davidpalma666/device.rfidreader-Fork/Hardware/OEPS-2094 HRFIDR - front side 1.jpg

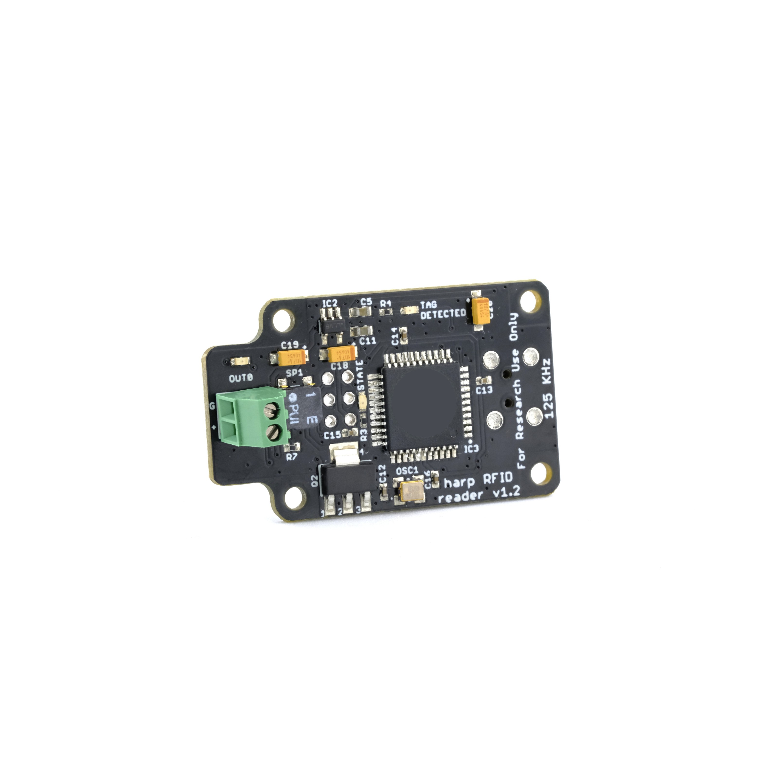
Hardware/OEPS-2094 HRFIDR - front side 1.jpg
