davidpalma666/device.rfidreader-Fork/Hardware/OEPS_BOM_harp_RFID_reader_v1.2.xlsx

Sheet: BOM
 |  |  |  |  |  |  |  |  |  |  |  | Quantity to produce➡️ | 8 | Production➡️ |  | Internal
OEPS PN | Schematic Name⬇️ | Qtty.⬇️ | Description | Type | Manufacturer PN⬇️ | Supplier | Supplier PN | Notes⬇️ | Losses | Needed | To order | Stock RM | Packages | Internal |  | External
 | PCB COMPONENTS
OEPS010011 | C3, C4 | 2 | CAPACITOR: SMD CER 0402 47pF 50V ±5% C0G [04025A470JAT2A] [SMD] | SMD | 04025A470JAT2A | DigiKey | 478-1078-6-ND |  | 0 | 16 | 16 |  |  | 0 | NOK | 0 | NOK
OEPS010017 | C1 | 1 | CAPACITOR: SMD CER 0402 4.7nF 100V ±10% X7R [885012205084] [SMD] | SMD | 885012205084 | DigiKey | 732-12234-6-ND |  | 0 | 8 | 0 | 15 | 6(Tp) 9(Tp) | 15 | OK | 0 | NOK
OEPS010016 | C2, C6, C8, C9, C10, C12, C13, C14, C15, C16, C21 | 11 | CAPACITOR: SMD CER 0402 100nF 50V ±10% X7R [CGA2B3X7R1H104K050BB] [SMD] | SMD | CGA2B3X7R1H104K050BB | DigiKey | 445-6899-6-ND |  | 0 | 88 | 85 | 3 | 3(Tp) | 0 | NOK | 0 | NOK
OEPS010015 | C5, C7, C11, C17 | 4 | CAPACITOR: SMD CER 0603 10uF 16V ±20% X5R [EMK107BBJ106MA-T] [SMD] | SMD | EMK107BBJ106MA-T | DigiKey | 587-3238-6-ND |  | 0 | 32 | 0 | 53 | 4(Tp) 49(Tp) | 13 | OK | 8 | OK
OEPS210002 | C18, C19, C20 | 3 | CAPACITOR POL: SMD TANT A 1206 100uF 10V ±20% 1.4Ohm [TLJA107M010R1400] [SMD] | SMD | TLJA107M010R1400 | DigiKey | 478-5651-6-ND |  | 0 | 24 | 24 |  |  | 0 | NOK | 0 | NOK
OEPS020034 | R7 | 1 | RESISTOR: SMD 0402 39Ω ±1% 0.250W [RCS040239R0FKED] [SMD] | SMD | RCS040239R0FKED | DigiKey | 541-10407-6-ND |  | 0 | 8 | 0 | 13 | 10(Tp) 3(Tp) | 13 | OK | 0 | NOK
OEPS020027 | R2, R3, R4, R6, R8 | 5 | RESISTOR: SMD 0402 1kΩ ±1% 0.063W [CRCW04021K00FKED] [SMD] | SMD | CRCW04021K00FKED | DigiKey | 541-1.00KLDKR-ND |  | 0 | 40 | 40 |  |  | 0 | NOK | 0 | NOK
OEPS020030 | R5 | 1 | RESISTOR: SMD 0402 10kΩ ±1% 0.063W [CRCW040210K0FKED] [SMD] | SMD | CRCW040210K0FKED | DigiKey | 541-10.0KLDKR-ND |  | 0 | 8 | 7 | 1 | 1(Tp) | 1 | NOK | 0 | NOK
OEPS020026 | R1 | 1 | RESISTOR: SMD 0402 1MΩ ±1% 0.063W [CRCW04021M00FKED] [SMD] | SMD | CRCW04021M00FKED | DigiKey | 541-1.00MLDKR-ND |  | 0 | 8 | 8 |  |  | 0 | NOK | 0 | NOK
OEPS040003 | L1 | 1 | INDUCTOR: FERRITE BEAD SMD 40Ω 2A 50mΩ [MI0805K400R-10] [0805] | SMD | MI0805K400R-10 | DigiKey | 240-2389-6-ND |  | 0 | 8 | 6 | 2 | 2(Tp) | 2 | NOK | 0 | NOK
OEPS060005 | Q1 | 1 | TRANSISTOR: BJT NPN 45V 0.5A [BC817-40W-7] [SOT-323] | SMD | BC817-40W-7 | DigiKey | BC817-40WDIDKR-ND |  | 0 | 8 | 5 | 3 | 3(Tp) | 3 | NOK | 0 | NOK
OEPS060004 | Q2 | 1 | TRANSISTOR: MOSFET P-CH 60V 1.7A [NTF2955T1G] [SOT-223] | SMD | NTF2955T1G | DigiKey | NTF2955T1GOSDKR-ND |  | 0 | 8 | 0 | 10 | 10 | 10 | OK | 7 | NOK
OEPS030006 | TAG_B, TAG_T, STATE, OUT0 | 4 | DIODE: LED 0603 Red 635nm 20mA [5975004407F] [0603] | SMD | 5975004407F | DigiKey | 350-2950-6-ND |  | 0 | 32 | 32 |  |  | 0 | NOK | 0 | NOK
OEPS100012 | SP1 | 1 | OTHER: BUZZER MAGNETIC 3V 5X5MM SMD [SMT-0540-S-R] [SMD] | SMD | SMT-0540-S-R | DigiKey | 668-1060-6-ND |  | 0 | 8 | 8 |  |  | 0 | NOK | 0 | NOK
OEPS080013 | IC1 | 1 | IC: USB Interface IC USB to Serial UART (OEPS NP1 073) [FT232RL-REEL] [SSOP-28] | SMD | FT232RL-REEL | DigiKey | 768-1007-6-ND |  | 0 | 8 | 0 | 64 | 48(Tp) 16 | 64 | OK | 63 | OK
OEPS080016 | IC2 | 1 | IC: LDO 3.3V 250mA [LP5907MFX-3.3/NOPB] [SOT-23-5] | SMD | LP5907MFX-3.3/NOPB | DigiKey | 296-38557-6-ND |  | 0 | 8 | 0 | 47 | 47(Tp) | 47 | OK | 42 | OK
OEPS080012 | IC3 | 1 | IC: MCU ATXMEGA A4U 8bits 32KB [ATXMEGA32A4U-A] [ TQFP-44] | SMD | ATXMEGA32A4U-A | DigiKey | ATXMEGA32A4U-AURDKR-ND |  | 0 | 8 | 0 | 13 | 3 10 | 13 | OK | 12 | OK
OEPS080017 | IC4 | 1 | IC: BUFFER NON-INVERT 1CH 3-STATE [M74VHC1GT126DT1G] [TSOP-5] | SMD | M74VHC1GT126DT1G | DigiKey | M74VHC1GT126DT1GOSDKR-ND |  | 0 | 8 | 0 | 29 | 29(Tp) | 29 | OK | 24 | OK
OEPS080014 | OSC1 | 1 | IC: XTAL OSC TCXO 32MHz HCMOS 2.5ppm [O 32,0-JT32C-A-K-3,3-LF] [4-SMD] | SMD | O 32,0-JT32C-A-K-3,3-LF | DigiKey | 1908-1044-6-ND |  | 0 | 8 | 5 | 3 | 1(Tp) 2 | 3 | NOK | 0 | NOK
OEPS070021 | USB | 1 | CONNECTOR: USB 2.0 MINI R/A [UX60-MB-5S8] [SMD] | SMD | UX60-MB-5S8 | DigiKey | H2960DKR-ND |  | 0 | 8 | 0 | 10 | 10(Tp) | 10 | OK | 9 | OK
OEPS070018 | U1 5POS | 1 | CONNECTOR: HEADER 2.00MM straight 1x5POS GOLD [NPPN051BFLD-RC] [SMD] | SMD | NPPN051BFLD-RC‎ | DigiKey | S5902-05-ND |  | 0 | 8 | 8 |  |  | 0 | NOK | 0 | NOK
OEPS070019 | U1 7POS | 1 | CONNECTOR: HEADER 2.00MM straight 1x7POS GOLD [NPPN071BFLC-RC] [SMD] | SMD | ‎NPPN071BFLC-RC‎ | DigiKey | S5901-07-ND |  | 0 | 8 | 0 | 10 | 8(Tb) 2(Tb) | 10 | OK | 9 | OK
OEPS070020 | OUT | 1 | CONNECTOR: TERMINAL BLOCK 2.54MM 2POS side entry [282834-2] [TH] | TH | 282834-2 | DigiKey | A98333-ND |  | 0 | 8 | 0 | 15 | 10 5 | 15 | OK | 14 | OK
 |  |  |  |  |  |  |  |  |  |  |  |  |  |  | OK |  | OK
#N/A |  | 1 | #N/A | #N/A | E1418287 | #N/A | #N/A |  | #N/A |  | #N/A |  |  |  | OK |  | OK
 |  |  |  |  |  |  |  |  |  |  |  |  |  |  | OK |  | OK
OEPS100013 |  | 1 | OTHER: RFID Reader ID-12LA (125 kHz) [ID-12LA] [TH] | TH | ID-12LA | Sparkfun | SEN-11827 |  | 0 | 8 | 8 |  |  | 0 | NOK | 0 | NOK
 |  |  |  |  |  |  |  |  |  |  |  |  |  |  | OK |  | OK
 |  |  |  |  |  |  |  |  |  |  |  |  |  |  | OK |  | OK
 |  |  |  |  |  |  |  |  |  |  |  |  |  |  | OK |  | OK
 |  |  |  |  |  |  |  |  |  |  |  |  |  |  | OK |  | OK
 |  |  |  |  |  |  |  |  |  |  |  |  |  |  | OK |  | OK
 |  |  |  |  |  |  |  |  |  |  |  |  |  |  | OK |  | OK
 |  |  |  |  |  |  |  |  |  |  |  |  |  |  | OK |  | OK
 |  |  |  |  |  |  |  |  |  |  |  |  |  |  | OK |  | OK
 |  |  |  |  |  |  |  |  |  |  |  |  |  |  | OK |  | OK
 |  |  |  |  |  |  |  |  |  |  |  |  |  |  | OK |  | OK
 |  |  |  |  |  |  |  |  |  |  |  |  |  |  | OK |  | OK
 |  |  |  |  |  |  |  |  |  |  |  |  |  |  | OK |  | OK
 |  |  |  |  |  |  |  |  |  |  |  |  |  |  | OK |  | OK
 |  |  |  |  |  |  |  |  |  |  |  |  |  |  | OK |  | OK
 |  |  |  |  |  |  |  |  |  |  |  |  |  |  | OK |  | OK
 |  |  |  |  |  |  |  |  |  |  |  |  |  |  | OK |  | OK
 |  |  |  |  |  |  |  |  |  |  |  |  |  |  | OK |  | OK
 |  |  |  |  |  |  |  |  |  |  |  |  |  |  | OK |  | OK
 |  |  |  |  |  |  |  |  |  |  |  |  |  |  | OK |  | OK
 |  |  |  |  |  |  |  |  |  |  |  |  |  |  | OK |  | OK
 |  |  |  |  |  |  |  |  |  |  |  |  |  |  | OK |  | OK
 |  |  |  |  |  |  |  |  |  |  |  |  |  |  | OK |  | OK
 |  |  |  |  |  |  |  |  |  |  |  |  |  |  | OK |  | OK
 |  |  |  |  |  |  |  |  |  |  |  |  |  |  | OK |  | OK

Sheet: components list
CABLE: FFC / FPC 26WAY 0.5MM 152MM [MP-FFCA05261522A] | OEPS090005 | Cable | MP-FFCA05261522A | 0 | Farnell | 3385235 | OEPS OEPS A35 001 OEPS A35 002 OEPS A35 003 | PDB-C156 TMK105B7104KVHF CL05B103KA5NNNC EMK212ABJ106MG-T
CABLE: FPC 0.30MM 17WAYS 2INCH [0150150217] | OEPS090009 | Cable | 0150150217 | 0 | DigiKey | 900-0150150217-ND | OEPS A35 004 | C3225X7R1C226K250AC | 650(R) 378(R) | 1028 | 650 | Reel | 0622 | 378 | Reel | XXXX
CABLE: FPC 0.30MM 17WAYS 6INCH [0150150617] | OEPS090008 | Cable | 0150150617 | 0 | DigiKey | 900-0150150617-ND | OEPS A35 005 | UMK107BJ105KA-T
CABLE: FPC 0.30MM 27WAYS 2INCH [0150150227] | OEPS090012 | Cable | 0150150227 | 0 | DigiKey | WM9645-ND | OEPS A35 006 | C1005X5R1E474K050BE
CABLE: FPC 0.30MM 27WAYS 4INCH [0150150427] | OEPS090013 | Cable | 0150150427 | 0 | DigiKey | WM6669-ND | OEPS A35 008 | GRM1555C1H220FA01D
CABLE: FPC 0.30MM 45WAYS 2INCH [0150150245] | OEPS090010 | Cable | 0150150245 | 0 | DigiKey | WM9648-ND | OEPS A35 009 | GRM155R71H682JA88D
CABLE: FPC 0.30MM 45WAYS 4INCH [0150150445] | OEPS090011 | Cable | 0150150445 | 0 | DigiKey | WM13117-ND | OEPS A35 010 | CL21A475KAQNNNE
CABLE: MMCX-to-MMCX 2.13meter [523-265101-08-84.00] | OEPS090002 | Cable | 523-265101-08-84.00 | 1 | DigiKey | 265101-08-84.00 | OEPS A35 011 | GRM1555C1H180FA01D
CABLE: RIBON 10COND 28AWG GRAY 100FT 30.48meter [3365/10 100] | OEPS090003 | Cable | 3365/10 100 | 0 | DigiKey | 3M157849-100-ND | OEPS A35 012 | T495C107K016ATE200
CABLE: RIBON 14COND 28AWG GRAY 100FT 30.48meter [3365/14 100] | OEPS090007 | Cable | 3365/14 100 | 0 | DigiKey | 3M157859-100-ND | OEPS A35 013 | GRM1555C1H100FA01D
CABLE: RIBON 8COND WHITE 4INCH 0.1016meter [A08SUR08SUR32W102A] | OEPS090004 | Cable | A08SUR08SUR32W102A | 0 | DigiKey | 455-4058-ND | OEPS A35 014 | RC0402FR-1310KL
CABLE: SDR 2meter 26POS [1SD26-3120-00C-200] | OEPS090001 | Cable | 1SD26-3120-00C-200 | 1 | DigiKey | 3M155828-ND | OEPS A35 015 | RC0402FR-071KL
CABLE: Stereo Jack Plug to Plug 3,5 MM 3.3ft (1.0m) [PSG03744] | OEPS090006 | Cable | PSG03744 | 0 | Farnell | 3498200 | OEPS A35 016 | RC0402FR-074K7L
CAPACITOR POL: SMD ALUM 1000uF 6.3V ±20% X7R [MCVVT6R3M102FB3L] [SMD] | OEPS210009 | SMD | MCVVT6R3M102FB3L | 5 | Farnell | 2611416 | OEPS A35 017 | RC0402FR-070RL | 91(R) | 91 | 91 | Reel | 0622
CAPACITOR POL: SMD ALUM 100uF 25V ±20% X7R [UCD1E101MCL6GS] [SMD] | OEPS210012 | SMD | UCD1E101MCL6GS | 2 | DigiKey | 493-6198-6-ND | OEPS A35 019 | RN731ETTP50R0F50 | 58(R) | 58 | 58 | Reel | 0622
CAPACITOR POL: SMD TANT A 1206 100uF 10V ±20% 1.4Ohm [TLJA107M010R1400] [SMD] | OEPS210002 | SMD | TLJA107M010R1400 | 5 | DigiKey | 478-5651-6-ND | OEPS A35 020 | RC0402FR-07240RL | 506(R) | 506 | 506 | Reel | 0622
CAPACITOR POL: SMD TANT A 1206 4.7uF 16V ±10% [TAJA475K016UNJ] [SMD] | OEPS210003 | SMD | TAJA475K016UNJ | 5 | DigiKey | 478-11461-6-ND | OEPS A35 021 | RC0402FR-071K6L | 503(R) | 503 | 503 | Reel | 0622
CAPACITOR POL: SMD TANT B0 1411 33uF 20V ±20% 50Ohm [TL8B0336M020C] [SMD] | OEPS210010 | SMD | TL8B0336M020C | 5 | Digikey | 718-1918-6-ND | OEPS A35 022 | RC0402FR-0740K2L
CAPACITOR POL: SMD TANT D 2917 100uF 16V ±10% 700mOhm [T491D107K016AT7280] [SMD] | OEPS210004 | SMD | T491D107K016AT7280 | 3 | DigiKey | 399-18066-6-ND | OEPS A35 023 | RC0402FR-07665KL
CAPACITOR POL: SMD TANT D 2917 330uF 10V ±10% 65mOhm (OEPS J30 011A) [TPSD337K010R0065] [SMD] | OEPS210008 | SMD | TPSD337K010R0065 | 5 | Digikey | 478-9190-6-ND | OEPS A35 024 | RC0402FR-07357KL
CAPACITOR POL: SMD TANT X 100uF 16V ±10% 75mOhm [T498X107K016ATE075] [SMD] | OEPS210001 | SMD | T498X107K016ATE075 | 3 | DigiKey | 399-5207-6-ND | OEPS A35 025 | RC0402FR-0724K9L
CAPACITOR POL: TH ALUM 100uF 25V ±20% 130mOhm [EEU-FM1E101B] [TH] | OEPS210005 | TH | EEU-FM1E101B | 1 | DigiKey | P19702CT-ND | OEPS A35 026 | RC0402FR-0778K7L | 512(R) | 512 | 512 | Reel | 0622
CAPACITOR POL: TH ALUM 330uF 16V ±20% 115,5mOhm [MCGPR16V337M8X11] [TH] | OEPS210006 | TH | MCGPR16V337M8X11 | 1 | Farnell | 9451102 | OEPS A35 027 | RC0402FR-07118KL | 543(R) | 543 | 543 | Reel | 0622
CAPACITOR POL: TH SUPERCAPACITOR 3F 2.7V ±10% RADIAL [HV0820-2R7305-R] [TH] | OEPS210011 | TH | HV0820-2R7305-R | 1 | DigiKey | 283-HV0820-2R7305-R-ND | OEPS A35 028 | BLM15AG601SN1D
CAPACITOR POL: USE OEPS210006 INSTEAD [MCGPR16V337M8X11] [TH] | OEPS210007 | TH | MCGPR16V337M8X11 | 1 | Farnell | 9451102 | OEPS A35 029 | MH2029-221Y
CAPACITOR: SMD CER 01005 10nF 16V ±10% X5R [GRM022R61C103KE01L] [SMD] | OEPS010101 | SMD | GRM022R61C103KE01L | 30 | Digikey | 490-GRM022R61C103KE01LCT-ND | OEPS A35 030 | LTST-C191KGKT | 59(R) | 59 | 59 | Reel | 0923
CAPACITOR: SMD CER 0201 100nF 10V ±20% X5R (OEPS J05 002) [GRM033R61A104ME15D] [SMD] | OEPS010040 | SMD | GRM033R61A104ME15D | 30 | DigiKey | 490-5405-6-ND | OEPS A35 031 | LTST-C191KRKT | 71(R) | 71 | 71 | Reel | 0523
CAPACITOR: SMD CER 0201 100nF 25V ±10% X5R (OEPS M01 007) [GRM033R61E104KE14J] [SMD] | OEPS010035 | SMD | GRM033R61E104KE14J | 30 | DigiKey | 490-14571-6-ND | OEPS A35 032 | PMEG3030EP,115 | 53(R) | 53 | 53 | Reel | 0622
CAPACITOR: SMD CER 0201 10nF 10V ±10% X7R (OEPS J05 006) [GRM033R71A103KA01D] [SMD] | OEPS010044 | SMD | GRM033R71A103KA01D | 30 | DigiKey | 490-3194-6-ND | OEPS A35 034 | CUZ6V8,H3F
CAPACITOR: SMD CER 0201 10nF 25V ±10% X7R (OEPS M01 004) [GRM033R71E103KE14D] [SMD] | OEPS010037 | SMD | GRM033R71E103KE14D | 30 | DigiKey | 490-14454-6-ND | OEPS A35 035 | LFE5U-85F-6BG381C
CAPACITOR: SMD CER 0201 10pF 50V ±5% C0G [GRM0335C1H100JA01J] [SMD] | OEPS010060 | SMD | GRM0335C1H100JA01J | 30 | DigiKey | 490-17811-6-ND | OEPS A35 035A | LFE5U-85F-6BG381I
CAPACITOR: SMD CER 0201 1uF 10V ±20% X5R (OEPS J05 003) [GRM033R61A105ME15D] [SMD] | OEPS010041 | SMD | GRM033R61A105ME15D | 30 | DigiKey | 490-13226-6-ND | OEPS A35 036 | SIT9120AC-2C2-25E100.000000X | 22(R) | 22 | 22 | Reel | XXXX
CAPACITOR: SMD CER 0201 1uF 16V ±20% X5R (OEPS M01 009) [CL03A105MO3NRNH] [SMD] | OEPS010036 | SMD | CL03A105MO3NRNH | 30 | DigiKey | 1276-6798-6-ND | OEPS A35 037 | W25Q128JVPIQ TR
CAPACITOR: SMD CER 0201 2.2uF 10V ±20% X5R (OEPS J05 004A) [CM03X5R225M10AH] [SMD] | OEPS010042 | SMD | CM03X5R225M10AH | 30 | Mouser | 346-CM03X5R225M10AH | OEPS A35 038 | MT41K64M16TW-107:J | 2(Tr) | 2 | 2 | Tray | 0222
CAPACITOR: SMD CER 0201 22nF 25V ±10% X5R [C0603X5R1E223K030BB] [SMD] | OEPS010058 | SMD | C0603X5R1E223K030BB | 30 | DigiKey | 445-13675-6-ND | OEPS A35 041 | FT600-B-T | 1(Tr) | 1 | 1 | Tray | XXXX
CAPACITOR: SMD CER 0201 27nF 16V ±10% X7R (OEPS Z00 003) [GRM033R61C273KE84D] [SMD] | OEPS010069 | SMD | GRM033R61C273KE84D | 30 | DigiKey | 490-10416-6-ND | OEPS A35 042 | LTC4360ISC8-2#TRMPBF
CAPACITOR: SMD CER 0201 27pF 50V ±2% C0G, NP0 [GRM0335C1H270GA01D] [SMD] | OEPS010029 | SMD | GRM0335C1H270GA01D | 30 | DigiKey | 490-11317-6-ND | OEPS A35 043 | LTM8051IY#PBF
CAPACITOR: SMD CER 0201 30pF 50V ±2% C0G (OEPS J05 039) [GRM0335C1H300GA01D] [SMD] | OEPS010049 | SMD | GRM0335C1H300GA01D | 30 | DigiKey | 490-14560-6-ND | OEPS A35 044 | NLSX3018MUTAG | 12 | 12 | 12 | Bag | XXXX
CAPACITOR: SMD CER 0201 4.7UF 6.3V ±20% X5R [GRM035R60J475ME15D] [SMD] | OEPS010065 | SMD | GRM035R60J475ME15D | 30 | DigiKey | 490-13230-6-ND | OEPS A35 045 | ABM8G-30.000MHZ-18-D2Y-T
CAPACITOR: SMD CER 0201 47nF 16V ±10% X5R (OEPS J05 005) [GRM033R61C473KE84D] [SMD] | OEPS010043 | SMD | GRM033R61C473KE84D | 30 | DigiKey | 490-7227-6-ND | OEPS A35 047 | ZXMC3A16DN8TC | 9(Tb) 4(Tb) | 13 | 9 | Tube | XXXX | 4 | Tube | XXXX
CAPACITOR: SMD CER 0201 47nF 25V ±10% X5R [CC0201KRX5R8BB473] [SMD] | OEPS010031 | SMD | CC0201KRX5R8BB473 | 30 | DigiKey | 13-CC0201KRX5R8BB473DKR-ND | OEPS A35 048 | BSE-040-01-L-D-A | 2 4(Tp) | 6 | 2 | Bag | 0522 | 4 | Tape | XXXX
CAPACITOR: SMD CER 0402 1.8nF 50V ±5% X7R [C0402C182J5RACTU] [SMD] | OEPS010090 | SMD | C0402C182J5RACTU | 30 | Digikey | 399-C0402C182J5RACTUDKR-ND | OEPS A35 049 | PH1RB-06-UA
CAPACITOR: SMD CER 0402 100nF 25V ±10% X7R [GRM155R71E104KE14D] [SMD] | OEPS010004 | SMD | GRM155R71E104KE14D | 30 | DigiKey | 490-10698-6-ND | OEPS A35 050 | ZX360D-B-10P(30) | 7 | 7 | 7 | Bag | XXXX
CAPACITOR: SMD CER 0402 100nF 25V ±10% X7R (OEPS H02 001) [C1005X7R1E104K050BB] [SMD] | OEPS010050 | SMD | C1005X7R1E104K050BB | 30 | DigiKey | 445-7348-6-ND | OEPS A35 051 | PJ-102AH | 28 | 28 | 28 | Bag | XXXX
CAPACITOR: SMD CER 0402 100nF 35V ±10% X5R (OEPS H1 001) [C1005X5R1V104K050BB] [SMD] | OEPS010066 | SMD | C1005X5R1V104K050BB | 30 | DigiKey | 445-7384-6-ND | OEPS E02 001 | PPTC141LFBN-RC
CAPACITOR: SMD CER 0402 100nF 50V ±10% X7R [CGA2B3X7R1H104K050BB] [SMD] | OEPS010016 | SMD | CGA2B3X7R1H104K050BB | 30 | DigiKey | 445-6899-6-ND | OEPS E02 002 | PPPC072LFBN-RC | 1 | 1 | 1 | Bag | 0422
CAPACITOR: SMD CER 0402 100pF 50V ±5% C0G [CC0402JRNPO9BN101] [SMD] | OEPS010089 | SMD | CC0402JRNPO9BN101 | 30 | Digikey | 311-1024-6-ND | OEPS E02 003 | PPTC161LFBN-RC | 17 | 17 | 17 | Bag | 0624
CAPACITOR: SMD CER 0402 10nF 25V ±10% X7R [GCM155R71E103KA37D] [SMD] | OEPS010002 | SMD | GCM155R71E103KA37D | 30 | DigiKey | 490-6043-6-ND | OEPS E02 004 | PPTC081LFBN-RC
CAPACITOR: SMD CER 0402 10nF 25V ±10% X7R (OEPS H1 002) [GRM155R71E103KA01D] [SMD] | OEPS010067 | SMD | GRM155R71E103KA01D | 30 | DigiKey | 490-1312-6-ND | OEPS E02 005 | OSTVN04A150
CAPACITOR: SMD CER 0402 10nF 50V ±10% X7R (OEPS H02 003) [GRM155R71H103KA88D] [SMD] | OEPS010051 | SMD | GRM155R71H103KA88D | 30 | DigiKey | 490-4516-6-ND | OEPS E02 006 | PJ-063AH
CAPACITOR: SMD CER 0402 10uF 10V ±20% X5R (OEPS M01 014) [CL05A106MP5NUNC] [SMD] | OEPS010038 | SMD | CL05A106MP5NUNC | 30 | DigiKey | 1276-1450-6-ND | OEPS E02 007 | 06035C103KAT2A | 12(Tp) | 12 | 12 | Tape | 0624
CAPACITOR: SMD CER 0402 10uF 6.3V ±20% X5R (OEPS J05 007A) [CL05A106MQ5NUNC] [SMD] | OEPS010045 | SMD | CL05A106MQ5NUNC | 30 | DigiKey | 1276-1451-6-ND | OEPS E02 008A | 478-10073-1-ND | 45(Tp) | 45 | 45 | Tape | 0624
CAPACITOR: SMD CER 0402 12pF 50V ±5% COG/NP0 [GRM1555C1H120JA01D] [SMD] | OEPS010086 | SMD | GRM1555C1H120JA01D | 30 | Digikey | 490-5924-6-ND | OEPS E02 009 | T491D156K035AT
CAPACITOR: SMD CER 0402 15nF 35V ±10% X7R [CGA2B3X7R1V153K050BB] [SMD] | OEPS010023 | SMD | CGA2B3X7R1V153K050BB | 30 | DigiKey | 445-12254-6-ND | OEPS E02 010 | T491D227M010AT
CAPACITOR: SMD CER 0402 1nF 50V ±5% X7R [C0402C102J5RACTU] [SMD] | OEPS010079 | SMD | C0402C102J5RACTU | 30 | Digikey | 399-C0402C102J5RACTUDKR-ND | OEPS E02 011 | RC0603FR-07470RL | 34(R) | 34 | 34 | Reel | 0422
CAPACITOR: SMD CER 0402 1uF 25V ±10% X5R [C1005X5R1E105K050BC] [SMD] | OEPS010030 | SMD | C1005X5R1E105K050BC | 30 | DigiKey | 445-9066-6-ND | OEPS E02 012 | RC0603FR-074K7L
CAPACITOR: SMD CER 0402 2.2uF 10V ±10% X7R [GRM155Z71A225KE44D] [SMD] | OEPS010055 | SMD | GRM155Z71A225KE44D | 30 | DigiKey | 490-GRM155Z71A225KE44DDKR-ND | OEPS E02 013 | RC0603FR-0710KL
CAPACITOR: SMD CER 0402 2.2uF 25V ±20% X5R [GRM155R61E225ME11D] [SMD] | OEPS010062 | SMD | GRM155R61E225ME11D | 30 | DigiKey | 490-12704-6-ND | OEPS E02 014 | SM-42TX203
CAPACITOR: SMD CER 0402 220nF 50V ±10% X5R [UMK105BJ224KV-F] [SMD] | OEPS010085 | SMD | UMK105BJ224KV-F | 30 | Digikey | 587-3500-6-ND | OEPS E02 015 | DR125-680-R | 2 | 2 | 2 | Bag | 0422
CAPACITOR: SMD CER 0402 22nF 50V ±10% X7R [GRM155R71H223KA12D] [SMD] | OEPS010034 | SMD | GRM155R71H223KA12D | 30 | DigiKey | 490-3884-6-ND | OEPS E02 016 | NRVTS260ESFT1G | 85(R) | 85 | 85 | Reel | XXXX
CAPACITOR: SMD CER 0402 22pF 50V ±5% C0G/NP0 [CL05C220JB51PNC] [SMD] | OEPS010080 | SMD | CL05C220JB51PNC | 30 | Digikey | 1276-6849-6-ND | OEPS E02 017 | IS31FL3193-DLS2-TR
CAPACITOR: SMD CER 0402 22uF 10V ±20% X5R [GMC04X5R226M10NT] [SMD] | OEPS010100 | SMD | GMC04X5R226M10NT | 30 | Digikey | 4713-GMC04X5R226M10NTDKR-ND | OEPS E02 018 | MAX6816EUS+T | 6(Tp) | 6 | 6 | Tape | XXXX
CAPACITOR: SMD CER 0402 27nF 16V ±10% X7R [C0402C273K4RACTU] [SMD] | OEPS010068 | SMD | C0402C273K4RACTU | 30 | DigiKey | 399-C0402C273K4RACTUDKR-ND | OEPS E02 019 | MIC4680-5.0YM-TR
CAPACITOR: SMD CER 0402 330nF 10V ±10% X5R [GRM155R61A334KE15D] [SMD] | OEPS010021 | SMD | GRM155R61A334KE15D | 30 | DigiKey | 490-3263-6-ND | OEPS E02 020 | COM-15141
CAPACITOR: SMD CER 0402 330pF 50V ±5% C0G [C0402C331J5GAC7867] [SMD] | OEPS010020 | SMD | C0402C331J5GAC7867 | 30 | DigiKey | 399-C0402C331J5GAC7867DKR-ND | OEPS E02 022 | PPTC041LFBN-RC | 92 | 92 | 92 | Bag | 0422
CAPACITOR: SMD CER 0402 4.7nF 100V ±10% X7R [885012205084] [SMD] | OEPS010017 | SMD | 885012205084 | 30 | DigiKey | 732-12234-6-ND | OEPS E02 023 | SAM12225-ND | 12 | 12 | 12 | Bag | 0421
CAPACITOR: SMD CER 0402 4.7nF 25V ±10% X7R [CC0402KRX7R8BB472] [SMD] | OEPS010001 | SMD | CC0402KRX7R8BB472 | 30 | DigiKey | 311-1039-6-ND | OEPS E02 025 | COM-10597 | 15 | 15 | 15 | Bag | 1224
CAPACITOR: SMD CER 0402 4.7uF 10V ±20% X5R (OEPS H02 004) [GRM155R61A475MEAAD] [SMD] | OEPS010052 | SMD | GRM155R61A475MEAAD | 30 | DigiKey | 490-14306-6-ND | OEPS E02 026 | TMCSILENTSTEPSTICK
CAPACITOR: SMD CER 0402 4.7uF 16V ±20% X5R [KGM05CR51C475MH] [SMD] | OEPS010097 | SMD | KGM05CR51C475MH | 30 | Digikey | 478-KGM05CR51C475MHDKR-ND | OEPS E02 027 | 61300811121 | 20 40 20 | 80 | 20 | Bag | 0624 | 40 | Bag | 0320 | 20 | Bag | 1224
CAPACITOR: SMD CER 0402 4.7uF 25V ±20% X5S [GRM155C61E475ME15J] [SMD] | OEPS010061 | SMD | GRM155C61E475ME15J | 30 | DigiKey | 490-GRM155C61E475ME15JDKR-ND | OEPS E02 029 | 61001421121
CAPACITOR: SMD CER 0402 4.7uF 6.3V ±20% X5R (OEPS J05 008) [GRM155R60J475ME47D] [SMD] | OEPS010046 | SMD | GRM155R60J475ME47D | 30 | DigiKey | 490-5915-6-ND | OEPS E02 029A | 95278-101A14LF | 6(Tp) | 6 | 6 | Tape | 0624
CAPACITOR: SMD CER 0402 470nF 35V ±10% X5R [C1005X5R1V474K050BE] [SMD] | OEPS010059 | SMD | C1005X5R1V474K050BE | 30 | DigiKey | 445-175220-6-ND | OEPS E02 030 | 61301411121
CAPACITOR: SMD CER 0402 470pF 100V ±5% C0G [C1005C0G2A471J050BA] [SMD] | OEPS010053 | SMD | C1005C0G2A471J050BA | 30 | DigiKey | 445-15206-6-ND | OEPS E02 031 | LCD-00709 | 9 | 9 | 9 | Bag | 0724
CAPACITOR: SMD CER 0402 470pF 50V ±5% C0G [C0402C471J5GAC7867] [SMD] | OEPS010033 | SMD | C0402C471J5GAC7867 | 30 | DigiKey | 399-C0402C471J5GAC7867DKR-ND | OEPS E02 032 | 61301611121
CAPACITOR: SMD CER 0402 47nF 25V ±10% X7R [GRM155R71E473KA88D] [SMD] | OEPS010003 | SMD | GRM155R71E473KA88D | 30 | DigiKey | 490-3254-6-ND | OEPS E02 037 | 3.06PRST30TC1D
CAPACITOR: SMD CER 0402 47nF 50V ±10% X7R [GRM155R71H473KE14D] [SMD] | OEPS010063 | SMD | GRM155R71H473KE14D | 30 | DigiKey | 490-10702-6-ND | OEPS F01 001 | JS102011SAQN | 2(Tp) | 2 | 2 | Tape | N/A
CAPACITOR: SMD CER 0402 47pF 50V ±5% C0G [04025A470JAT2A] [SMD] | OEPS010011 | SMD | 04025A470JAT2A | 30 | DigiKey | 478-1078-6-ND | OEPS F01 002 | CGA4J3X7R1E105K | 38(R) | 38 | 38 | Reel | 0421
CAPACITOR: SMD CER 0603 100nF 100V ±10% X7R [CL10B104KC8NNNC] [SMD] | OEPS010095 | SMD | CL10B104KC8NNNC | 20 | DigiKey | 1276-6807-6-ND | OEPS F01 015 | UCD1E101MCL6GS | 3 | 3 | 3 | Bag | N/A
CAPACITOR: SMD CER 0603 100nF 100V ±10% X7R [GRM188R72A104KA35D] [SMD] | OEPS010009 | SMD | GRM188R72A104KA35D | 20 | DigiKey | 490-3285-6-ND | OEPS F01 017 | SZMM3Z5V1ST1G | 13(R) | 13 | 13 | Reel | 0421
CAPACITOR: SMD CER 0603 100nF 100V ±10% X7R (OEPS J05 001) [GRJ188R72A104KE11D] [SMD] | OEPS010039 | SMD | GRJ188R72A104KE11D | 20 | DigiKey | 490-10901-6-ND | OEPS F01 019 | MBR0520LT1G | 122(R) | 122 | 122 | Reel | 0617
CAPACITOR: SMD CER 0603 100pF 50V ±5% C0G [CC0603JRNPO9BN101] [SMD] | OEPS010078 | SMD | CC0603JRNPO9BN101 | 30 | Digikey | 311-1069-6-ND | OEPS F01 020 | SBH11-PBPC-D05-RA-BK | 1 | 1 | 1 | Bag | 0421
CAPACITOR: SMD CER 0603 10nF 50V ±10% X7R [C1608X7R1H103K080AA] [SMD] | OEPS010074 | SMD | C1608X7R1H103K080AA | 30 | Digikey | 445-1311-6-ND | OEPS F01 023 | 569-0112-200F | 1 | 1 | 1 | Bag | 0421
CAPACITOR: SMD CER 0603 10pF 50V ±5% C0G [C0603C100J5GACTU] [SMD] | OEPS010096 | SMD | C0603C100J5GACTU | 20 | DigiKey | 399-C0603C100J5GACTUDKR-ND | OEPS F01 028 | 164-6218 | 1 | 1 | 1 | Bag | XX21
CAPACITOR: SMD CER 0603 10uF 16V ±20% X5R [EMK107BBJ106MA-T] [SMD] | OEPS010015 | SMD | EMK107BBJ106MA-T | 20 | DigiKey | 587-3238-6-ND | OEPS F01 029 | 571-0500 | 1 | 1 | 1 | Bag | XX21
CAPACITOR: SMD CER 0603 10uF 35V ±20% X5R [GRM188R6YA106MA73J] [SMD] | OEPS010093 | SMD | GRM188R6YA106MA73J | 20 | Digikey | 490-GRM188R6YA106MA73JDKR-ND | OEPS F01 030 | 569-0111-100F | 1 | 1 | 1 | Bag | XX21
CAPACITOR: SMD CER 0603 15nF 50V ±10% X7R [C0603C153K5RACTU] [SMD] | OEPS010084 | SMD | C0603C153K5RACTU | 30 | Digikey | 399-C0603C153K5RACTUDKR-ND | OEPS F01 031 | PJ-063AH | 1 | 1 | 1 | Bag | 0421
CAPACITOR: SMD CER 0603 15pF 50V ±5% C0G [C1608C0G1H150J080AA] [SMD] | OEPS010072 | SMD | C1608C0G1H150J080AA | 30 | Digikey | 445-1271-6-ND | OEPS F01 034 | IRF510STRRPBF | 14(R) 5 | 19 | 14 | Reel | 0421 | 5 | Bag | N/A
CAPACITOR: SMD CER 0603 180nF 50V ±10% X8R [GCG188R91H184KA01D] [SMD] | OEPS010019 | SMD | GCG188R91H184KA01D | 20 | DigiKey | 490-GCG188R91H184KA01DDKR-ND | OEPS F01 050 | CSR0603FKR500 | 80(R) | 80 | 80 | Reel | 0421
CAPACITOR: SMD CER 0603 18pF 50V ±5% C0G [C0603C180J5GAC7867] [SMD] | OEPS010064 | SMD | C0603C180J5GAC7867 | 30 | DigiKey | 399-C0603C180J5GAC7867DKR-ND | OEPS F01 062 | CFPA-1FB4-A2T | 1 | 1 | 1 | Bag | N/A
CAPACITOR: SMD CER 0603 1nF 100V ±10% X7R [C1608X7R2A102K080AA] [SMD] | OEPS010073 | SMD | C1608X7R2A102K080AA | 30 | Digikey | 445-1298-6-ND | OEPS F01 063 | 731000105 | 1 | 1 | 1 | Bag | XX21
CAPACITOR: SMD CER 0603 1uF 25V ±10% X5R [CL10A105KA8NNNC] [SMD] | OEPS010022 | SMD | CL10A105KA8NNNC | 20 | DigiKey | 1276-1102-6-ND | OEPS F01 067 | ADG1201BRJZ-R2
CAPACITOR: SMD CER 0603 1uF 50V ±10% X7R [06035C105KAT2A] [SMD] | OEPS010054 | SMD | 06035C105KAT2A | 20 | DigiKey | 478-10073-6-ND | OEPS F01 070 | LT1764AEQ#TRPBF | 1 | 1 | 1 | Bag | N/A
CAPACITOR: SMD CER 0603 2.2uF 25V ±10% X5R (OEPS J30 006) [GRM188R61E225KA12D] [SMD] | OEPS010075 | SMD | GRM188R61E225KA12D | 30 | Digikey | 490-10731-6-ND | OEPS F01 071 | BD00FC0WEFJ-E2 | 16(R) | 16 | 16 | Reel | 0421
CAPACITOR: SMD CER 0603 22nF 100V ±10% X7R [C1608X7R2A223K080AA] [SMD] | OEPS010056 | SMD | C1608X7R2A223K080AA | 30 | DigiKey | 445-2275-6-ND | OEPS F01 078 | ADR03BKSZ-REEL7 | 14(R) | 14 | 14 | Reel | 0421
CAPACITOR: SMD CER 0603 22uF 6.3V ±20% X5R (OEPS J30 009) [GRM188R60J226MEA0D] [SMD] | OEPS010076 | SMD | GRM188R60J226MEA0D | 30 | Digikey | 490-7611-6-ND | OEPS F01 079 | AS12CV | 1 | 1 | 1 | Bag | 0421
CAPACITOR: SMD CER 0603 4.7nF 100V ±10% X7R [885012206112] [SMD] | OEPS010014 | SMD | 885012206112 | 20 | DigiKey | 732-12240-6-ND | OEPS F01 080 | 100SP3T2B4M6RE | 1 | 1 | 1 | Bag | 0421
CAPACITOR: SMD CER 0603 4.7uF 16V ±10% X6S [C1608X6S1C475K080AC] [SMD] | OEPS010018 | SMD | C1608X6S1C475K080AC | 20 | DigiKey | 445-9118-6-ND | OEPS F01 082 | SSQ-102-03-G-S | 1 3 | 4 | 1 | Bag | 0421 | 3 | Bag | N/A
CAPACITOR: SMD CER 0603 4.7uF 25V ±10% X5R (OEPS J05 009) [GRM188R61E475KE11D] [SMD] | OEPS010047 | SMD | GRM188R61E475KE11D | 30 | DigiKey | 490-7203-6-ND | OEPS F01 084 | ESR03EZPF4700 | 14(R) | 14 | 14 | Reel | 0421
CAPACITOR: SMD CER 0603 47pF 50V ±5% C0G [06035A470JAT2A] [SMD] | OEPS010012 | SMD | 06035A470JAT2A | 20 | DigiKey | 478-1171-6-ND | OEPS H02 002 | C0402C273K4RACTU
CAPACITOR: SMD CER 0603 75pF 50V C0G [0603N750J500CT] [SMD] | OEPS010070 | SMD | 0603N750J500CT | 30 | Digikey | 1292-1545-6-ND | OEPS H02 005A | RC0603FR-070RL
CAPACITOR: SMD CER 0805 100nF 100V ±10% X7R [C2012X7R2A104K125AA] [SMD] | OEPS010077 | SMD | C2012X7R2A104K125AA | 20 | Digikey | 445-1418-6-ND | OEPS J05 004 | GRM033R61A225ME47D
CAPACITOR: SMD CER 0805 100pF 50V ±5% C0G [CC0805JRNPO9BN101] [SMD] | OEPS010082 | SMD | CC0805JRNPO9BN101 | 30 | Digikey | 311-1111-6-ND | OEPS J05 010A | C2012JB1A476M125AC | 142(R) | 142 | 142 | Reel | 0621
CAPACITOR: SMD CER 0805 10uF 25V ±10% X5R [GRM21BR61E106KA73L] [SMD] | OEPS010006 | SMD | GRM21BR61E106KA73L | 20 | DigiKey | 490-5523-6-ND | OEPS J05 014 | U.FL-R-SMT-1(10) | 20(Tp) 6 509(R) | 535 | 20 | Tape | XXXX | 6 | Bag | XXXX | 509 | Reel | 0822
CAPACITOR: SMD CER 0805 15nF 50V ±10% X7R [C0805C153K5RACTU] [SMD] | OEPS010083 | SMD | C0805C153K5RACTU | 30 | Digikey | 399-C0805C153K5RACTUDKR-ND | OEPS J05 015 | ADL3225V-470MT-TL000 | 514(R) | 514 | 514 | Reel | 0822
CAPACITOR: SMD CER 0805 1uF 25V ±10% X7R [GCM21BR71E105KA56L] [SMD] | OEPS010005 | SMD | GCM21BR71E105KA56L | 20 | DigiKey | 490-4785-6-ND | OEPS J05 019 | MMBT3904LP-7B | 514(R) | 514 | 514 | Reel | 0822
CAPACITOR: SMD CER 0805 2.2uF 25V ±10% X7R [GRM21BR71E225KE11L] [SMD] | OEPS010088 | SMD | GRM21BR71E225KE11L | 20 | Digikey | 490-14467-6-ND | OEPS J05 035 | SG-210STF 66.6667ML3
CAPACITOR: SMD CER 0805 4.7uF 50V ±10% X5R [GRM21BR61H475KE51L] [SMD] | OEPS010013 | SMD | GRM21BR61H475KE51L | 20 | DigiKey | 490-10751-6-ND | OEPS J05 052 | 71010120A
CAPACITOR: SMD CER 0805 470nF 50V ±10% X7R [CL21B474KBFNNNG] [SMD] | OEPS010099 | SMD | CL21B474KBFNNNG | 20 | Digikey | 1276-6482-6-ND | OEPS J1 001 | GRM155R71C104KA88D
CAPACITOR: SMD CER 0805 47uF 10V ±20% X5R (OEPS J05 010) [GRM21BR61A476ME15L] [SMD] | OEPS010048 | SMD | GRM21BR61A476ME15L | 20 | DigiKey | 490-9961-6-ND | OEPS J1 002 | CL05A106MP5NUNC
CAPACITOR: SMD CER 1206 10uF 25V ±10% X7R [GRM31CR71E106KA12L] [SMD] | OEPS010007 | SMD | GRM31CR71E106KA12L | 15 | DigiKey | 490-6518-6-ND | OEPS J1 007 | LTST-C191KRKT
CAPACITOR: SMD CER 1206 10uF 35V ±10% X5R [GRT319R6YA106KE01D] [SMD] | OEPS010094 | SMD | GRT319R6YA106KE01D | 15 | Digikey | 490-GRT319R6YA106KE01DDKR-ND | OEPS J1 008 | TSOP57438TT1
CAPACITOR: SMD CER 1206 10uF 50V ±10% X7R [CL31B106KBHNNNE] [SMD] | OEPS010032 | SMD | CL31B106KBHNNNE | 15 | DigiKey | 1276-6767-6-ND | OEPS J1 010 | BLM18PG471SN1D
CAPACITOR: SMD CER 1206 1uF 50V ±10% X7R [CL31B105KBHNFNE] [SMD] | OEPS010087 | SMD | CL31B105KBHNFNE | 15 | Digikey | 1276-3091-6-ND | OEPS J1 011 | LQM2MPN2R2MG0L
CAPACITOR: SMD CER 1206 2.2nF 2000V ±20% X7R [C1206C222MGRACTU] [SMD] | OEPS010092 | SMD | C1206C222MGRACTU | 15 | Digikey | 399-13198-6-ND | OEPS J1 013 | ERJ-2RKF4871X
CAPACITOR: SMD CER 1206 22uF 10V ±10% X5R [CL31A226KPHNNNE] [SMD] | OEPS010071 | SMD | CL31A226KPHNNNE | 15 | Digikey | 1276-1287-6-ND | OEPS J1 014 | ERJ-2RKF4990X
CAPACITOR: SMD CER 1206 22uF 25V ±20% X5R [TMK316BBJ226ML-T] [SMD] | OEPS010098 | SMD | TMK316BBJ226ML-T | 15 | Digikey | 587-3246-6-ND | OEPS J1 015 | ERJ-2RKF1003X
CAPACITOR: SMD CER 1206 4.7uF 16V ±10% X7R [CL31B475KOHNNNE] [SMD] | OEPS010081 | SMD | CL31B475KOHNNNE | 15 | Digikey | 1276-3182-6-ND | OEPS J1 016 | ERJ-2RKF1001X
CAPACITOR: SMD CER 1210 100nF 500V ±10% X7R [C1210C104KCRACTU] [SMD] | OEPS010091 | SMD | C1210C104KCRACTU | 15 | Digikey | 399-C1210C104KCRACTUDKR-ND | OEPS J1 018 | ERJ-2RKF8251X
CAPACITOR: SMD CER 1210 10uF 25V ±10% X7R [GRM31CR71E106KA12L] [SMD] | OEPS010010 | SMD | GRM31CR71E106KA12L | 15 | DigiKey | 490-1867-6-ND | OEPS J1 023 | TXS0206AYFPR
CAPACITOR: SMD CER 1210 47uF 25V ±20% X5R [TMK325ABJ476MM-T] [SMD] | OEPS010008 | SMD | TMK325ABJ476MM-T | 10 | DigiKey | 587-6156-6-ND | OEPS J30 001 | 06035C103K
CAPACITOR: TH ALUM ELEC 100µF 100V ± 20% RADIAL [EEU-FR2A101] [TH] | OEPS010057 | TH | EEU-FR2A101 | 1 | DigiKey | P124237-ND | OEPS J30 002 | GRM155R71E473KA88D | 35(R) | 35 | 35 | Reel | 0421
CAPACITOR: TH ALUM ELEC 100µF 25V ± 20% RADIAL [ESK107M025AE3EA] [TH] | OEPS010028 | TH | ESK107M025AE3EA | 1 | Farnell | 2835182 | OEPS J30 003 | GRM155R71C104KA88
CAPACITOR: TH ALUM ELEC 10µF 35V ± 20% RADIAL [MCRH35V106M5X11] [TH] | OEPS010027 | TH | MCRH35V106M5X11 | 1 | Farnell | 9451900 | OEPS J30 004 | 06035C104KAT2A
CAPACITOR: TH CER 100nF 50V X7R RADIAL [C322C104K5R5TA] [TH] | OEPS010026 | TH | C322C104K5R5TA | 1 | DigiKey | 399-4329-ND | OEPS J30 005 | GRM39R105K10
CAPACITOR: TH CER 1nF 100V X7R RADIAL [K102K15X7RH53L2] [TH] | OEPS010025 | TH | K102K15X7RH53L2 | 1 | DigiKey | K102K15X7RH53L2-ND | OEPS J30 006 | GRM188R61E225KA2D | 34(R) 20(R) | 54 | 34 | Reel | 0421 | 20 | Reel | 0922
CAPACITOR: TH CER 22pF 50V C0G/NP0 RADIAL [K220J15C0GF53L2] [TH] | OEPS010024 | TH | K220J15C0GF53L2 | 1 | DigiKey | BC5146-ND | OEPS J30 007 | GRM188R61C475KE1D
CONNECTOR: 3.5MM JACK STEREO 90º [35RASMT2BHNTRX] [SMD] | OEPS070025 | SMD | 35RASMT2BHNTRX | 1 | DigiKey | SC1489-6-ND | OEPS J30 008 | GRM188R61C106MA3D | 42(R) | 42 | 42 | Reel | 0421
CONNECTOR: 3.5MM JACK STEREO 90º [PJ-316A-6A] [SMD] | OEPS070129 | SMD | PJ-316A-6A | 1 | LCSC Electronics | C128987 | OEPS J30 009 | GRM188R60J226MEA0D
CONNECTOR: 3.5MM JACK STEREO 90º [SJ-3523-SMT-TR] [SMD] | OEPS070012 | SMD | SJ-3523-SMT-TR | 1 | DigiKey | CP-3523SJDKR-ND | OEPS J30 009A | C1608X5R1A226M | 33(R) | 33 | 33 | Reel | 0421
CONNECTOR: ARRAY PLUG 400POS GOLD [ASP-134488-01] [SMD] | OEPS070148 | SMD | ASP-134488-01 | 1 | Digikey | SAM8730-ND | OEPS J30 010 | TCTAL0J107MBR
CONNECTOR: BNC JACK 50ohm R/A [0731375003] [TH] | OEPS070151 | TH | 0731375003 | 1 | DigiKey | WM5514-ND | OEPS J30 011 | T495D337K010ATE125 | 5 2 3 | 10 | 5 | Bag | N/A | 2 | Bag | XX20 | 3 | Bag | N/A
CONNECTOR: BNC JACK 50ohm R/A [731000105] [TH] | OEPS070024 | TH | 731000105 | 1 | DigiKey | WM5524-ND | OEPS J30 012 | RC0603FR-070RL
CONNECTOR: BNC JACK 75ohm R/A [112419] [TH] | OEPS070088 | TH | 112419 | 1 | DigiKey | ACX1971-ND | OEPS J30 013 | RC0603FR-0722RL
CONNECTOR: BNC JACK 75ohm straight [731010360] [TH] | OEPS070002 | TH | 731010360 | 1 | DigiKey | WM5509-ND | OEPS J30 014 | RC0603FR-0733RL | 473(R) | 473 | 473 | Reel | 1121
CONNECTOR: CONN BNC JACK STR 50 OHM PCB [1-1337445-0] [TH] | OEPS070107 | TH | 1-1337445-0 | 1 | Digikey | A101972-ND | OEPS J30 015 | RC0402FR-0749R9L
CONNECTOR: CONN FFC BOTTOM 16POS 0.5MM R/A [FH12-16S-0.5SH(55)] [SMD] | OEPS070104 | SMD | FH12-16S-0.5SH(55) | 1 | Digikey | HFJ116DKR-ND | OEPS J30 016 | RC0603FR-071000RL
CONNECTOR: CONN FFC BOTTOM 4POS 0.5MM R/A [FH19C-4S-0.5SH(10)] [SMD] | OEPS070077 | SMD | FH19C-4S-0.5SH(10) | 1 | Digikey | H125822DKR-ND | OEPS J30 017 | RC0603FR-07200RL
CONNECTOR: CONN FPC 17POS 0.3MM R/A [FH35C-17S-0.3SHW(99)] [SMD] | OEPS070073 | SMD | FH35C-17S-0.3SHW(99) | 1 | DigiKey | H122267DKR-ND | OEPS J30 018 | RC0603FR-07430RL
CONNECTOR: CONN FPC BOTTOM 27POS 0.3MM R/A [046844727002846+] [SMD] | OEPS070064 | SMD | 046844727002846+ | 3 | DigiKey | 478-046844727002846+DKR-ND | OEPS J30 019 | C0603FR-071KL
CONNECTOR: CONN FPC BOTTOM 45POS 0.3MM R/A [1-2013496-8] [SMD] | OEPS070051 | SMD | 1-2013496-8 | 1 | Worldway | 1-2013496-8 | OEPS J30 020 | RC0603FR-07K15L
CONNECTOR: CONN HDR 80POS SMD GOLD [BTE-040-03-L-D-A] [SMD] | OEPS070103 | SMD | BTE-040-03-L-D-A | 1 | Digikey | SAM12466-ND | OEPS J30 021 | RC0603FR-072KL
CONNECTOR: CONN HEADER SMD R/A 2POS 2MM [S2B-PH-SM4-TB] [SMD] | OEPS070106 | SMD | S2B-PH-SM4-TB | 1 | Digikey | 455-S2B-PH-SM4-TBDKR-ND | OEPS J30 022 | RC0603FR-073K57L
CONNECTOR: CONN HEADER SMD R/A 3POS 1.27MM [850-10-003-40-001000] [SMD] | OEPS070076 | SMD | 850-10-003-40-001000 | 1 | DigiKey | 850-10-003-40-001000-ND | OEPS J30 023 | RC0603FR-076K04L
CONNECTOR: CONN HEADER SMD R/A 5POS 1.25MM [WM7623DKR-ND] [SMD] | OEPS070111 | SMD | WM7623DKR-ND | 1 | Digikey | WM7623DKR-ND | OEPS J30 024 | RC0603FR-0710KL
CONNECTOR: CONN MICRO SD CARD PUSH-PULL R/A [0475710001] [SMD] | OEPS070078 | SMD | 0475710001 | 1 | Digikey | WM9731DKR-ND | OEPS J30 025 | RC0603FR-0711KL
CONNECTOR: CONN MICRO SD CARD R/A [693071010811] [SMD] | OEPS070119 | SMD | 693071010811 | 1 | Digikey | 732-3819-6-ND | OEPS J30 026 | RC0603FR-0730K1L
CONNECTOR: CONN PLUG 34POS SMD GOLD (OEPS Z00 002) [5046223412] [SMD] | OEPS070085 | SMD | 5046223412 | 10 | DigiKey | 23-5046223412DKR-ND | OEPS J30 027 | RC0603FR-07100KL
CONNECTOR: CONN PLUG 3POS IDC 20-22AWG GOLD [37103-2165-000 FL 100] [TH] | OEPS070056 | TH | 37103-2165-000 FL 100 | 1 | DigiKey | 3M155967-ND | OEPS J30 028 | RC0603FR-071ML
CONNECTOR: CONN PLUG 4POS IDC 20-22AWG GOLD [37104-2165-000 FL 100] [TH] | OEPS070055 | TH | 37104-2165-000 FL 100 | 1 | DigiKey | 3M155844-ND | OEPS J30 029 | BLM21PG221SN1D | 17(R) | 17 | 17 | Reel | 0421
CONNECTOR: CONN POWER JACK 2.0mm SM R/A [PJ-036AH-SMT-TR] [SMD] | OEPS070122 | SMD | PJ-036AH-SMT-TR | 1 | Digikey | CP-036AHPJDKR-ND | OEPS J30 030 | BLM18KG601SN1D | 30(R) | 30 | 30 | Reel | 0421
CONNECTOR: CONN POWER JACK 2.50mm SM R/A (OEPS J30 048) [PJ-036BH-SMT-TR] [SMD] | OEPS070092 | SMD | PJ-036BH-SMT-TR | 1 | Digikey | CP-036BHPJDKR-ND | OEPS J30 031 | LQM21PN1R2MC0D | 31(R) | 31 | 31 | Reel | 0421
CONNECTOR: CONN RCPT 1.4 HDMI 19POS R/A [10029449-111RLF] [SMD] | OEPS070086 | SMD | 10029449-111RLF | 1 | DigiKey | 609-4614-6-ND | OEPS J30 032 | MPZ2012S601AT000 | 34(R) | 34 | 34 | Reel | 0421
CONNECTOR: CONN RCPT 10P IDC 26-28AWG GOLD [1658621-1] [Other] | OEPS070046 | Other | 1658621-1 | 1 | DigiKey | AKC10H-ND | OEPS J30 033A | MLP2012S4R7MT0S1 | 19(R) | 19 | 19 | Reel | 0421
CONNECTOR: CONN RCPT 12POS 0.079 GOLD PCB [37212-62M3-003PL] [TH] | OEPS070054 | TH | 37212-62M3-003PL | 1 | DigiKey | 3M5717-ND | OEPS J30 034 | CBC3225T101MR
CONNECTOR: CONN RCPT 34POS SMD GOLD (OEPS Z00 001) [5046183412] [SMD] | OEPS070084 | SMD | 5046183412 | 10 | DigiKey | 23-5046183412DKR-ND | OEPS J30 035 | XLH536026000000I | 2(Tp) | 2 | 2 | Tape | 0923
CONNECTOR: CONN RCPT 4P 0.031 GOLD SMD R/A [MQ172X-4PA(30)] [SMD] | OEPS070072 | SMD | MQ172X-4PA(30) | 1 | DigiKey | H125250-ND | OEPS J30 035A | XLH535026.000000I | 4 17(Tp) | 21 | 4 | Bag | N/A | 17 | Tape | 0223
CONNECTOR: CONN RCPT 4POS 0.079 GOLD PCB [37204-62A3-004PL] [TH] | OEPS070053 | TH | 37204-62A3-004PL | 1 | DigiKey | 3M5702-ND | OEPS J30 036 | SG-3040LC 32.7680KB3:PURE SN | 3(Tp) 8 | 11 | 3 | Tape | 0920 | 8 | Bag | N/A
CONNECTOR: CONN RCPT 70POS GOLD (OEPS D13 001) [DF40C(2.0)-70DS-0.4V(51)] [SMD] | OEPS070090 | SMD | DF40C(2.0)-70DS-0.4V(51) | 3 | Digikey | H11908DKR-ND | OEPS J30 037 | SP3010-04UTG | 4(Tp) | 4 | 4 | Tape | XX20
CONNECTOR: CONN RCPT 80POS GOLD [BTE-040-01-F-D-A] [SMD] | OEPS070089 | SMD | BTE-040-01-F-D-A | 1 | Digikey | SAM9060-ND | OEPS J30 038A | CYUSB3014-BZXC
CONNECTOR: CONN RCPT 80POS SMD GOLD [BSE-040-01-F-D-A-TR] [SMD] | OEPS070100 | SMD | BSE-040-01-F-D-A-TR | 1 | Digikey | 612-BSE-040-01-F-D-A-TRDKR-ND | OEPS J30 039 | NCP361SNT1G | 4(Tp) | 4 | 4 | Tape | XX20
CONNECTOR: CONN RCPT FMALE 4POS GOLD SOLDER [T4041037041-000] [TH] | OEPS070108 | TH | T4041037041-000 | 1 | Digikey | A126815-ND | OEPS J30 040 | DS90UB914ATRHSTQ1
CONNECTOR: CR1220 Battery Holders; 12mm (OEPS K01 013) [3000] [SMD] | OEPS070116 | SMD | 3000 | 1 | Mouser | 534-3000 | OEPS J30 041A | NCV59748MWADJTBG
CONNECTOR: FPC 26POS 0.5MM R/A [XF2M-2615-1A] [SMD] | OEPS070070 | SMD | XF2M-2615-1A | 1 | DigiKey | OR722DKR-ND | OEPS J30 041B | NCP59744MN1ADJTBG | 5 | 5 | 5 | Bag | XXXX
CONNECTOR: HEADER 0.8MM 8POS [BM08B-SURS-TF] [SMD] | OEPS070149 | SMD | BM08B-SURS-TF | 1 | Digikey | 455-BM08B-SURS-TFDKR-ND | OEPS J30 042 | TPS76801QDR | 2(Tp) 5(Tb) | 7 | 2 | Tape | XXXX | 5 | Tube | XXXX
CONNECTOR: HEADER 1.27MM R/A 10POS [FTSH-105-01-F-D-RA-K] [TH] | OEPS070147 | TH | FTSH-105-01-F-D-RA-K | 1 | Digikey | SAM9432-ND | OEPS J30 043 | TPS62231DRYT | 3(Tp) | 3 | 3 | Tape | XX20
CONNECTOR: HEADER 1.27MM straight 4x10POS [MOLC-110-11-S-Q] [TH] | OEPS070132 | TH | MOLC-110-11-S-Q | 1 | Samtec | MOLC-110-11-S-Q | OEPS J30 044 | MMBT3904-TP
CONNECTOR: HEADER 2.00MM straight 1x5POS GOLD [NPPN051BFLD-RC] [SMD] | OEPS070018 | SMD | NPPN051BFLD-RC | 1 | DigiKey | S5902-05-ND | OEPS J30 045 | M24M02-DRMN6TP | 2(Tp) 9(Tb) | 11 | 2 | Tape | N/A | 9 | Tube | XXXX
CONNECTOR: HEADER 2.00MM straight 1x7POS GOLD [NPPN071BFLC-RC] [SMD] | OEPS070019 | SMD | NPPN071BFLC-RC | 1 | DigiKey | S5901-07-ND | OEPS J30 046 | SN74VC1G125DBVR | 6(Tp) | 6 | 6 | Tape | XX20
CONNECTOR: HEADER 2.54MM 2x5POS [M20-8760542] [SMD] | OEPS070145 | SMD | M20-8760542 | 1 | Digikey | 952-2842-ND | OEPS J30 046B | 74LVC1G125GWQ100 | 249(R) | 249 | 249 | Reel | XXXX
CONNECTOR: HEADER 2.54MM 90º 1x2POS [PH1RB-02-UA] [TH] | OEPS070005 | TH | PH1RB-02-UA | 1 | DigiKey | 2057-PH1RB-02-UA-ND | OEPS J30 047 | 897-10-010-40-300002 | 8(Tp) | 8 | 8 | Tape | 0725
CONNECTOR: HEADER 2.54MM R/A 1x5POS [61300511021] [TH] | OEPS070143 | TH | 61300511021 | 1 | Digikey | 732-5338-ND | OEPS J30 048 | PJ-036BH-SMT-TR | 2 | 2 | 2 | Bag | 1020
CONNECTOR: HEADER 2.54MM R/A 1x6POS (OEPS K01 025) [61300611021] [TH] | OEPS070118 | TH | 61300611021 | 1 | Digikey | 732-5339-ND | OEPS J30 049A | LSM0603453V | 10(R) | 10 | 10 | Reel | 0425
CONNECTOR: HEADER 2.54MM R/A 2x2POS [10129381-904003BLF] [TH] | OEPS070146 | TH | 10129381-904003BLF | 1 | Digikey | 10129381-904003BLF | OEPS J30 050 | CONSMA002
CONNECTOR: HEADER 2.54MM R/A 2x3POS [61300621021] [TH] | OEPS070144 | TH | 61300621021 | 1 | Digikey | 732-5352-ND | OEPS J30 052 | 67996-206HLF
CONNECTOR: HEADER 2.54MM R/A 2x5POS [SBH11-PBPC-D05-RA-BK] [TH] | OEPS070027 | TH | SBH11-PBPC-D05-RA-BK | 1 | DigiKey | S9177-ND | OEPS J30 053 | 67996-208HLF
CONNECTOR: HEADER 2.54MM R/A 2x8POS [302-R161] [TH] | OEPS070152 | TH | 302-R161 | 1 | DigiKey | ED10535-ND | OEPS J30 054 | 5-146280
CONNECTOR: HEADER 2.54MM straight 1x14POS [TSW-114-07-G-S] [TH] | OEPS070004 | TH | TSW-114-07-G-S | 1 | DigiKey | SAM1029-14-ND | OEPS J30 055 | 5-146280-2
CONNECTOR: HEADER 2.54MM straight 1x2POS [68001-202HLF] [TH] | OEPS070079 | TH | 68001-202HLF | 1 | DigiKey | 609-3469-ND | OEPS K01 001 | PCF8523T/1,118
CONNECTOR: HEADER 2.54MM straight 1x3POS [68001-203HLF] [TH] | OEPS070029 | TH | 68001-203HLF | 1 | DigiKey | 609-3470-ND | OEPS K01 002 | TB6612FNG,C,8,EL
CONNECTOR: HEADER 2.54MM straight 1x4POS [68001-204HLF] [TH] | OEPS070080 | TH | 68001-204HLF | 1 | DigiKey | 609-3402-ND | OEPS K01 003 | M74VHC1GT125DT1G
CONNECTOR: HEADER 2.54MM straight 1x5POS [M20-9990546] [TH] | OEPS070131 | TH | M20-9990546 | 1 | DigiKey | 952-2268-ND | OEPS K01 004 | RC0805FR-071KL
CONNECTOR: HEADER 2.54MM straight 1x6POS [61300611121] [TH] | OEPS070097 | TH | 61300611121 | 1 | Digikey | 732-5319-ND | OEPS K01 005 | RC0805FR-074K7L
CONNECTOR: HEADER 2.54MM straight 2x10POS [67996-420HLF] [TH] | OEPS070016 | TH | 67996-420HLF | 1 | DigiKey | 609-3221-ND | OEPS K01 006 | CR0805-FX-3302ELF
CONNECTOR: HEADER 2.54MM straight 2x3POS [67996-206HLF] [TH] | OEPS070015 | TH | 67996-206HLF | 1 | DigiKey | 609-3210-ND | OEPS K01 008 | ERJ-6ENF4700V
CONNECTOR: HEADER 2.54MM straight 2x3POS [PR20203VBDN] [TH] | OEPS070124 | TH | PR20203VBDN | 1 | DigiKey | 1849-PR20203VBDN-ND | OEPS K01 009 | GRM21BR61E106KA73L
CONNECTOR: HEADER JST VERT 2.5MM 2POS [B2B-XH-A(LF)(SN)] [TH] | OEPS070028 | TH | B2B-XH-A(LF)(SN) | 1 | DigiKey | 455-2247-ND | OEPS K01 010 | RSM200S-32.768-12.5-10PPM-NPB
CONNECTOR: HEADER JST VERT 2MM 2POS [B2B-PH-K-S(LF)(SN)] [TH] | OEPS070130 | TH | B2B-PH-K-S(LF)(SN) | 1 | DigiKey | 455-1704-ND | OEPS K01 010B | ABS25-32.768KHZ-4-T
CONNECTOR: HEADER R/A 8POS 0.8MM [SM08B-SURS-TF(LF)(SN)] [SMD] | OEPS070048 | SMD | SM08B-SURS-TF(LF)(SN) | 1 | DigiKey | 455-2040-6-ND | OEPS K01 011A | TSM500P02CX RFG
CONNECTOR: HEADER RCPT 16POS 2.54MM [CES-116-01-T-S] [TH] | OEPS070110 | TH | CES-116-01-T-S | 1 | Digikey | SAM1087-16-ND | OEPS K01 012 | Adafruit: 2762 (black) 2759 (white) Mouser: 485-2762 485-2759
CONNECTOR: HEADER RCPT 2.54MM 2POS R/A [SSW-102-02-T-S-RA] [TH] | OEPS070098 | TH | SSW-102-02-T-S-RA | 1 | Digikey | SAM11929-ND | OEPS K01 012A | XT1511RGBW-BW
CONNECTOR: HEADER RCPT 2.54MM straight 1x14POS [PPPC141LFBN-RC] [TH] | OEPS070006 | TH | PPPC141LFBN-RC | 1 | DigiKey | S7047-ND | OEPS K01 013 | 534-3000 (534-3000TR tape&reel version)
CONNECTOR: HEADER RCPT 2.54MM straight 1x2POS [PPTC021LFBN-RC] [TH] | OEPS070095 | TH | PPTC021LFBN-RC | 1 | Digikey | S7000-ND | OEPS K01 014 | PS1240P02BT
CONNECTOR: HEADER RCPT 2.54MM straight 1x4POS [PPTC041LFBN-RC] [TH] | OEPS070096 | TH | PPTC041LFBN-RC | 1 | Digikey | S7002-ND | OEPS K01 016 | BYS10-25-E3/TR
CONNECTOR: HEADER RCPT 2.54MM straight 1x5POS [PPTC051LFBN-RC] [TH] | OEPS070142 | TH | PPTC051LFBN-RC | 1 | Digikey | S6103-ND | OEPS K01 017 | SSSS811101
CONNECTOR: HEADER RCPT 2.54MM straight 1x7POS Blue [76341-307LF] [TH] | OEPS070150 | TH | 76341-307LF | 1 | Mouser | 649-76341-307LF | OEPS K01 018 | 35RASMT2BHNTRX
CONNECTOR: HEADER RCPT 2x6POS 2.54MM [CES-106-01-T-D] [TH] | OEPS070135 | TH | CES-106-01-T-D | 1 | Digikey | SAM1086-06-ND | OEPS K01 019 | CES-112-01-T-S
CONNECTOR: HEADER RCPT 3POS 2.54MM [2212S-03SG-85] [TH] | OEPS070137 | TH | 2212S-03SG-85 | 1 | Farnell | 1593459 | OEPS K01 020 | CES-116-01-T-S
CONNECTOR: HEADER RCPT 3POS R/A 2.54MM [SSW-103-02-T-S-RA] [TH] | OEPS070139 | TH | SSW-103-02-T-S-RA | 1 | Digikey | SSW-103-02-T-S-RA-ND | OEPS K01 021 | M20-9990546
CONNECTOR: HEADER Samtec 80POS [BTE-040-01-L-D-A] [SMD] | OEPS070017 | SMD | BTE-040-01-L-D-A | 2 | DigiKey | SAM8745-ND | OEPS K01 022A | GP1A57HRJ00F
CONNECTOR: HEADER SMD 2x2POS 2.54MM [M20-8760242] [SMD] | OEPS070099 | SMD | M20-8760242 | 1 | Digikey | 952-3254-ND | OEPS K01 023 | B2B-PH-K-S(LF)(SN)
CONNECTOR: HEADER SMD JST 4POS 1MM [BM04B-SRSS-TB(LF)(SN)] [SMD] | OEPS070125 | SMD | BM04B-SRSS-TB(LF)(SN) | 2 | Mouser | 306-BM04BSRSSTBLFSN | OEPS K01 025 | 61300611021
CONNECTOR: HEADER SMD JST 4POS 1MM [BM04B-SRSS-TB] [SMD] | OEPS070126 | SMD | BM04B-SRSS-TB | 2 | DigiKey | 455-BM04B-SRSS-TBDKR-ND | OEPS K01 101 | Adafruit 2796 M: 485-2796 DK: 1528-1539-ND | 24 | 24 | 24 | Bag | 0624
CONNECTOR: HEADER SMD JST 4POS 1MM [SM04B-SRSS-TB] [SMD] | OEPS070138 | SMD | SM04B-SRSS-TB | 2 | DigiKey | 455-SM04B-SRSS-TBDKR-ND | OEPS K01 104 | Adafruit 3502 M: 485-3502 DK: 1528-2326-ND | 1 | 1 | 1 | Box | XXXX
CONNECTOR: HEADER SMD JST 6POS 2MM [B6B-PH-SM4-TB] [SMD] | OEPS070154 | SMD | B6B-PH-SM4-TB | 2 | DigiKey | 455-B6B-PH-SM4-TBDKR-ND | OEPS K01 106 | TSW-112-06-T-S
CONNECTOR: HEADER VERT 16POS 2.54MM [TSW-116-06-T-S] [TH] | OEPS070109 | TH | TSW-116-06-T-S | 1 | Digikey | SAM1027-16-ND | OEPS K01 107 | TSW-116-06-T-S
CONNECTOR: HEADER VERT 2x5POS 2.54MM [10129383-910002ALF] [SMD] | OEPS070120 | SMD | 10129383-910002ALF | 1 | Digikey | 609-10129383-910002ALFDKR-ND | OEPS K01 109 | ERJ-3EKF1002V
CONNECTOR: HEADER VERT 2x6POS 2.54MM [TSW-106-06-T-D] [TH] | OEPS070136 | TH | TSW-106-06-T-D | 1 | Digikey | 612-TSW-106-06-T-D-ND | OEPS M01 004 | GRM033R71E103KE14D
CONNECTOR: HEADER VERT 3POS 1MM [BM03B-SRSS-TB] [SMD] | OEPS070121 | SMD | BM03B-SRSS-TB | 1 | Digikey | 455-BM03B-SRSS-TBDKR-ND | OEPS M01 007 | GRM033R61E104KE14J
CONNECTOR: HIROSE PLUG 70POS GOLD (OEPS M01 055) [DF40C-70DP-0.4V(51)] [SMD] | OEPS070068 | SMD | DF40C-70DP-0.4V(51) | 5 | DigiKey | H11630DKR-ND | OEPS M01 011 | GRM155R61E105KA12D
CONNECTOR: IDC 2.54MM straight 2x12POS [69168-124HLF] [TH] | OEPS070008 | TH | 69168-124HLF | 1 | Mouser | 649-69168-124HLF | OEPS M01 012 | GRM155R61E225KE11D | 58(R) | 58 | 58 | Reel | 0919
CONNECTOR: IDC 2.54MM Straight 2x5POS [SBH11-PBPC-D05-ST-BK] [TH] | OEPS070030 | TH | SBH11-PBPC-D05-ST-BK | 1 | DigiKey | S9169-ND | OEPS M01 013 | CL05A475MO5NUNC
CONNECTOR: IDC 2.54MM straight 2x8POS [69168-116HLF] [TH] | OEPS070007 | TH | 69168-116HLF | 1 | Mouser | 649-69168-116HLF | OEPS M01 014 | CL05A106MP5NUNC
CONNECTOR: IDC RCPT 10POS 26-28AWG GOLD [61201023021] [Other] | OEPS070040 | Other | 61201023021 | 1 | DigiKey | 732-2102-ND | OEPS M01 015 | CL05A156MQ5Q6J8 | 48(R) | 48 | 48 | Reel | 0919
CONNECTOR: LASER DIODE SOCKET FOR Ø3.8 MM [S038S] [SMD] | OEPS070102 | SMD | S038S | 1 | Thorlabs | S038S | OEPS M01 015A | GRM155R60J156ME05D
CONNECTOR: LASER DIODE SOCKET FOR Ø5.6 MM [S7060R] [SMD] | OEPS070101 | SMD | S7060R | 1 | Thorlabs | S7060R | OEPS M01 018 | RC0201FR-07100RL
CONNECTOR: MMCX RCPT 50ohm 90º [1-1634010-0] [TH] | OEPS070039 | TH | 1-1634010-0 | 1 | DigiKey | A101964-ND | OEPS M01 021 | RC0201FR-072KL
CONNECTOR: MMCX RCPT 50ohm 90º [262105] [TH] | OEPS070081 | TH | 262105 | 1 | DigiKey | ACX1978-ND | OEPS M01 022 | RC0201FR-072K87L
CONNECTOR: MMCX RCPT 50ohm 90º [6-1634010-0] [TH] | OEPS070003 | TH | 6-1634010-0 | 1 | DigiKey | A123178-ND | OEPS M01 023 | RC0201FR-074KL7L
CONNECTOR: OMNETICS NANO PLUG 36POS HORIZONTAL (OEPS H1 006) [A79025-001] [SMD] | OEPS070065 | SMD | A79025-001 | 1 | Omnetics | A79025-001 | OEPS M01 024 | RC0201FR-079K09L
CONNECTOR: OMNETICS NANO PLUG/SOCKET HORIZONTAL 12POS (OEPS00041, OEPS H1 007) [A79623-001] [SMD] | OEPS070066 | SMD | A79623-001 | 1 | Omnetics | A79623-001 | OEPS M01 025 | ERA-1AEB103C
CONNECTOR: OMNETICS NANO PLUG/SOCKET VERTICAL 12POS (OEPS H02 012) [A79622-001] [SMD] | OEPS070067 | SMD | A79622-001 | 1 | Omnetics | A79622-001 | OEPS M01 030 | RC0201FR-071ML
CONNECTOR: OMNETICS NANO PLUG/SOCKET VERTICAL 36POS [A79027-001] [SMD] | OEPS070075 | SMD | A79027-001 | 1 | DigiKey | 2262-A79027-001-ND | OEPS M01 033 | CBC3225T101MR
CONNECTOR: OMNETICS NANO SOCKET 36POS VERTICAL (OEPS D00 001) [A79026-001] [SMD] | OEPS070069 | SMD | A79026-001 | 1 | Omnetics | A79026-001 | OEPS M01 036 | VEMD1160X01 | 2 78(Tp) 50(R) | 130 | 2 | Bag | 1120 | 78 | Tape | 1220 | 50 | Reel | 1220
CONNECTOR: PLUG 6POS GOLD [5050700622] [SMD] | OEPS070049 | SMD | 5050700622 | 1 | DigiKey | 900-5050700622CT-ND | OEPS M01 038 | XZVGR155W | 2 26(R) 90(R) | 118 | 2 | Bag | 1219 | 26 | Reel | 0919 | 90 | Reel | 0521
CONNECTOR: POWER JACK DC 2.1MM 5.5MM 1.5A 18VDC [163-179PH-EX] [TH] | OEPS070026 | TH | 163-179PH-EX | 1 | Mouser | 163-179PH-EX | OEPS M01 039 | ASCO-50.000MHZ-EK-T3 | 9(R) 15(R) | 24 | 9 | Reel | 1120 | 15 | Reel | 1121
CONNECTOR: RJ45 JACK 8P8C R/A UNSHIELDED [215877-1] [TH] | OEPS070022 | TH | 215877-1 | 1 | DigiKey | A105009CT-ND | OEPS M01 040 | DG509BEN-T1-GE4 | 13(Tp) | 13 | 13 | Tape | 1120
CONNECTOR: RJ45 JACK 8P8C Vertical UNSHIELDED [5556416-1] [TH] | OEPS070134 | TH | 5556416-1 | 1 | DigiKey | A31428-ND | OEPS M01 041 | CAT4016HV6-GT2 | 5(R) 8(Tb) | 13 | 5 | Reel | 1120 | 8 | Tube | XXXX
CONNECTOR: ROTARY ENCODER MECHANICAL 24PPR [PEC12R-4222F-S0024] [TH] | OEPS070113 | TH | PEC12R-4222F-S0024 | 1 | Digikey | PEC12R-4222F-S0024-ND | OEPS M01 042 | DS90UB913ATRTVTQ1 | 17(R) 8(R) | 25 | 17 | Reel | XXXX | 8 | Reel | 1120
CONNECTOR: SDR RCPT 90º 26POS [12226-8250-00FR] [SMD] | OEPS070009 | SMD | 12226-8250-00FR | 1 | DigiKey | MSDS26-ND | OEPS M01 043 | LT3463AEDD#PBF | 8(Tb) 13(Tb) | 21 | 8 | Tube | 1120 | 13 | Tube | 1121
CONNECTOR: SMA JACK 50ohm R/A [PCB.SMAFRA.HT] [TH] | OEPS070061 | TH | PCB.SMAFRA.HT | 1 | DigiKey | 931-1361-ND | OEPS M01 046 | TLV70712PDQNR | 2 3(R) 60(R) | 65 | 2 | Bag | 1119 | 3 | Reel | XXXX | 60 | Reel | 0719
CONNECTOR: SMA JACK 50ohm straight 16 mm [132291] [TH] | OEPS070001 | TH | 132291 | 1 | DigiKey | ACX1976-ND | OEPS M01 048 | TLV70733DQNR | 23(R) | 23 | 23 | Reel | XXXX
CONNECTOR: SMA RCPT 50ohm R/A [2081679-1] [TH] | OEPS070141 | TH | 2081679-1 | 1 | DigiKey | 17-2081679-1-ND | OEPS M01 049 | TPL001-100RSER | 22(R) | 22 | 22 | Reel | 1121
CONNECTOR: SMA RCPT 50ohm R/A (OEPS J30 050) [CONSMA002] [TH] | OEPS070093 | TH | CONSMA002 | 1 | Digikey | CONSMA002-ND | OEPS M01 050 | TS4231 | 16(R) | 16 | 16 | Reel | 1121
CONNECTOR: SWITCH ROCKER SPDT 3A 120V [400MSP1R6BLKM6QE] [TH] | OEPS070112 | TH | 400MSP1R6BLKM6QE | 0 | Digikey | EG4326-ND | OEPS M01 051 | 10M08DCV81I7G
CONNECTOR: SWITCH TACTILE SPST-NO 0.05A 12V [PTS645VH58-2 LFS] [TH] | OEPS070114 | TH | PTS645VH58-2 LFS | 0 | Digikey | CKN9120-ND | OEPS M01 052 | TPS62621YFFT | 21(R) | 21 | 21 | Reel | 1121
CONNECTOR: SWITCH TACTILE SPST-NO TOP ACTUATED [TS04-66-50-BK-160-SMT] [SMD] | OEPS070115 | SMD | TS04-66-50-BK-160-SMT | 5 | Digikey | 2223-TS04-66-50-BK-160-SMT-ND | OEPS M01 053 | AD5683RBCPZ-1RL7 | 8(R) 5 | 13 | 8 | Reel | 1120 | 5 | Bag | XXXX
CONNECTOR: TERMINAL BLOCK 1 PIN BINDING POST M2.5 R/A [8734] [TH] | OEPS070127 | TH | 8734 | 2 | DigiKey | 36-8734-ND | OEPS M01 054 | ADA4062-4ACPZ-R7 | 10 16(R) | 26 | 10 | Bag | XXXX | 16 | Reel | XXXX
CONNECTOR: TERMINAL BLOCK 2.54MM 16POS top entry [1789074] [TH] | OEPS070013 | TH | 1789074 | 1 | DigiKey | 277-14038-ND | OEPS M01 055 | DF40C-70DP-0.4V(51)
CONNECTOR: TERMINAL BLOCK 2.54MM 2POS side entry [282834-2] [TH] | OEPS070020 | TH | 282834-2 | 1 | DigiKey | A98333-ND | OEPS M01 056 | DF40C-10DP-0.4V(51) | 62(R) | 62 | 62 | Reel | 0919
CONNECTOR: TERMINAL BLOCK 2.54MM 2POS side entry [OSTVN02A150] [TH] | OEPS070133 | TH | OSTVN02A150 | 1 | DigiKey | ED10561-ND | OEPS M05 001 | 6-1634010-0
CONNECTOR: TERMINAL BLOCK 2.54MM 3POS side entry [282834-3] [TH] | OEPS070035 | TH | 282834-3 | 1 | DigiKey | A98334-ND | OEPS M05 001A | 1-1634010-0
CONNECTOR: TERMINAL BLOCK 2.54MM 4POS side entry [282834-4] [TH] | OEPS070036 | TH | 282834-4 | 1 | DigiKey | A98335-ND | OEPS M05 002 | ESHF10501LDSMKTR | 39(Tp) 2(Tp) | 41 | 39 | Tape | 0122 | 2 | Tape | XXXX
CONNECTOR: TERMINAL BLOCK 2.54MM 5POS side entry [282834-5] [TH] | OEPS070041 | TH | 282834-5 | 1 | DigiKey | A98336-ND | OEPS M05 003 | 12226-8250-00FR | 42 | 42 | 42 | Box | 1122
CONNECTOR: TERMINAL BLOCK 2.54MM 6POS side entry [282834-6] [TH] | OEPS070091 | TH | 282834-6 | 1 | DigiKey | A98337-ND | OEPS M05 004 | 95278-101A16LF | 21 | 21 | 21 | Bag | N/A
CONNECTOR: TERMINAL BLOCK 2.54MM 7POS side entry [282834-7] [TH] | OEPS070023 | TH | 282834-7 | 1 | DigiKey | A135912-ND | OEPS M05 005 | 200-ASP-134488-01 | 41(Tp) | 41 | 41 | Tape | 0122
CONNECTOR: TERMINAL BLOCK 2.54MM 8POS top entry [1789472] [TH] | OEPS070011 | TH | 1789472 | 1 | DigiKey | 277-14044-ND | OEPS M05 006 | CHS-01TA | 76(R) 19 6 | 101 | 76 | Reel | 1120 | 19 | Bag | N/A | 6 | Bag | N/A
CONNECTOR: TERMINAL BLOCK 2.54MM 9POS top entry [1888276] [TH] | OEPS070010 | TH | 1888276 | 1 | DigiKey | 277-14292-ND | OEPS M05 008 | MINISMDC014F-2
CONNECTOR: TERMINAL BLOCK 8POS R/A 2.54MM [1725711] [TH] | OEPS070140 | TH | 1725711 | 1 | DigiKey | 277-1279-ND | OEPS M05 010 | RR0510R-49R9D | 212(R) | 212 | 212 | Reel | XX21
CONNECTOR: TERMINAL BLOCK PLUG 2POS 3.5MM [20.1550M/2-E] [TH] | OEPS070059 | TH | 20.1550M/2-E | 1 | Farnell | 2575215 | OEPS M05 011 | RC0402FR-0760R4L | 45(R) 67(R) | 112 | 45 | Reel | 0420 | 67 | Reel | XX21
CONNECTOR: TERMINAL BLOCK PLUG 2POS 3.5MM [691361100002] [TH] | OEPS070034 | TH | 691361100002 | 1 | DigiKey | 732-2751-ND | OEPS M05 012 | ERJ-2RKF1000X | 61(R) 85(R) | 146 | 61 | Reel | 0420 | 85 | Reel | XX21
CONNECTOR: TERMINAL BLOCK PLUG 3POS 3.5MM [691361100003] [TH] | OEPS070047 | TH | 691361100003 | 1 | DigiKey | 732-2752-ND | OEPS M05 013 | CRGP0603F150R | 285(R) | 285 | 285 | Reel | XX21
CONNECTOR: TERMINAL BLOCK PLUG 4POS 3.5MM [20.1550M/4-E] [TH] | OEPS070060 | TH | 20.1550M/4-E | 1 | Farnell | 2575217 | OEPS M05 014 | ERJ-2RKF1001X | 252(R) 108(R) | 360 | 252 | Reel | XX21 | 108 | Reel | 0420
CONNECTOR: TERMINAL BLOCK PLUG 4POS 3.5MM [691361100004] [TH] | OEPS070082 | TH | 691361100004 | 1 | DigiKey | 732-2753-ND | OEPS M05 015 | ERJ-2RKF2001X | 183(R) 211(R) | 394 | 183 | Reel | 0420 | 211 | Reel | XXXX
CONNECTOR: TERMINAL BLOCK PLUG 4POS 5.08MM [1729144] [TH] | OEPS070123 | TH | 1729144 | 1 | Farnell | 3041475 | OEPS M05 016 | EXB-2HV222JV | 162(R) | 162 | 162 | Reel | XX21
CONNECTOR: TERMINAL BLOCK PLUG 5POS 3.5MM [20.1550M/5-E] [Other] | OEPS070038 | Other | 20.1550M/5-E | 1 | Farnell | 2575218 | OEPS M05 017 | ERJ-2RKF3001X | 126(R) 94(R) | 220 | 126 | Reel | 0420 | 94 | Reel | XX21
CONNECTOR: TERMINAL BLOCK PLUG 6POS 3.5MM [20.1550M/6-E] [TH] | OEPS070043 | TH | 20.1550M/6-E | 1 | Farnell | 2575219 | OEPS M05 018 | ERJ-2RKF3481X | 120(R) | 120 | 120 | Reel | XX1
CONNECTOR: TERMINAL BLOCK PLUG 8POS 3.5MM [691361100008] [TH] | OEPS070033 | TH | 691361100008 | 1 | DigiKey | 732-2756-ND | OEPS M05 019 | ERJ-2RKF4701X | 251(R) 226(R) | 477 | 251 | Reel | XX21 | 226 | Reel | 0420
CONNECTOR: TERMINAL BLOCK SOCKET 2POS 3.5MM [ED555/2DS] [TH] | OEPS070087 | TH | ED555/2DS | 1 | DigiKey | ED1514-ND | OEPS M05 020 | ERJ-2RKF5601X | 100(R) 24(R) | 124 | 100 | Reel | XX21 | 24 | Reel | 0420
CONNECTOR: TERMINAL BLOCK SOCKET 2POS R/A 3.5MM [20.155MH/2-E] [TH] | OEPS070057 | TH | 20.155MH/2-E | 1 | Farnell | 2517858 | OEPS M05 021 | ERJ-2RKF1002X | 254(R) 350(R) | 604 |  |  |  | 254 | Reel | XX21 | 350 | Reel | 0122
CONNECTOR: TERMINAL BLOCK SOCKET 2POS R/A 3.5MM [691322110002] [TH] | OEPS070032 | TH | 691322110002 | 1 | DigiKey | 732-2769-ND | OEPS M05 022 | ERJ-2RKF1502X | 80(R) | 80 | 80 | Reel | 1120
CONNECTOR: TERMINAL BLOCK SOCKET 3POS 55DEG 3.5MM [1751109] [TH] | OEPS070074 | TH | 1751109 | 1 | DigiKey | 277-5930-ND | OEPS M05 023 | ERJ-2RKF2102X | 107(R) | 107 | 107 | Reel | XX21
CONNECTOR: TERMINAL BLOCK SOCKET 3POS R/A 3.5MM [691322110003] [TH] | OEPS070071 | TH | 691322110003 | 1 | DigiKey | 732-2770-ND | OEPS M05 024 | ERJ-2RKF4302X | 45(R) | 45 | 45 | Reel | 0420
CONNECTOR: TERMINAL BLOCK SOCKET 4POS R/A 3.5MM [20.155MH/4-E] [TH] | OEPS070058 | TH | 20.155MH/4-E | 1 | Farnell | 2517860 | OEPS M05 025 | ERJ-2RKF7322X | 47(R) 74(R) | 121 | 47 | Reel | 0420 | 74 | Reel | XX21
CONNECTOR: TERMINAL BLOCK SOCKET 4POS R/A 3.5MM [691322110004] [TH] | OEPS070083 | TH | 691322110004 | 1 | DigiKey | 732-2771-ND | OEPS M05 026 | ERJ-2RKF1653X | 149(R) 176(R) | 325 | 149 | Reel | 0420 | 176 | Reel | XX21
CONNECTOR: TERMINAL BLOCK SOCKET 5POS R/A 3.5MM [20.155MH/5-E] [TH] | OEPS070037 | TH | 20.155MH/5-E | 1 | Farnell | 2517861 | OEPS M05 027 | ERJ-2RKF1783X | 85(R) | 85 | 85 | Reel | XX21
CONNECTOR: TERMINAL BLOCK SOCKET 6POS R/A 3.5MM [20.155MH/6-E] [TH] | OEPS070042 | TH | 20.155MH/6-E | 1 | Farnell | 2517862 | OEPS M05 028 | ERJ-2RKF6493X | 85(R) | 85 | 85 | Reel | XX21
CONNECTOR: TERMINAL BLOCK SOCKET 6POS R/A 3.5MM [691322110006] [TH] | OEPS070045 | TH | 691322110006 | 1 | DigiKey | 732-2773-ND | OEPS M05 029 | CC0402KRX7R8BB472 | 55(R) 173(R) | 228 | 55 | Reel | 0420 | 173 | Reel | XX21
CONNECTOR: TERMINAL BLOCK SOCKET 8POS R/A 3.5MM [691322110008] [TH] | OEPS070031 | TH | 691322110008 | 1 | DigiKey | 732-2774-ND | OEPS M05 030 | GCM155R71E103KA37D | 263(R) 621(R) | 884 | 263 | Reel | 0420 | 621 | Reel | XX21
CONNECTOR: U.FL RCPT Straight 50 OHM (OEPS J05 014) [U.FL-R-SMT-1(10)] [SMD] | OEPS070063 | SMD | U.FL-R-SMT-1(10) | 3 | DigiKey | H11891DKR-ND | OEPS M05 031 | GRM155R71E473KA88D | 160(R) | 160 | 160 | Reel | XX21
CONNECTOR: USB 2.0 MICRO B R/A [10118192-0001LF] [SMD] | OEPS070050 | SMD | 10118192-0001LF | 1 | DigiKey | 609-4613-6-ND | OEPS M05 032 | GRM155R71E104KE4D | 1278(R) 2748(R) | 4026 | 1278 | Reel | 0320 | 2748 | Reel | XX21
CONNECTOR: USB 2.0 MICRO B R/A [ZX62D-B-5P8(30)] [SMD/TH] | OEPS070062 | SMD/TH | ZX62D-B-5P8(30) | 1 | DigiKey | H125272DKR-ND | OEPS M05 033 | GCM21BR71E105KA6L | 178(R) 169(R) | 347 | 178 | Reel | XX21 | 169 | Reel | 0320
CONNECTOR: USB 2.0 MICRO B R/A (OEPS K01 015) [ZX62D-B-5PA8(30)] [SMD/TH] | OEPS070117 | SMD/TH | ZX62D-B-5PA8(30) | 1 | Digikey | H125718DKR-ND | OEPS M05 034 | GRM21BR61E106KA3L | 850(R) | 850 | 850 | Reel | XX21
CONNECTOR: USB 2.0 MINI R/A [65100516121] [SMD] | OEPS070014 | SMD | 65100516121 | 1 | DigiKey | 732-2109-6-ND | OEPS M05 035 | GRM31CR71E106KA12 | 418(R) 516(R) | 934 | 418 | Reel | 0320 | 516 | Reel | XX21
CONNECTOR: USB 2.0 MINI R/A [UX60-MB-5S8(70)] [SMD] | OEPS070044 | SMD | UX60-MB-5S8(70) | 1 | DigiKey | 26-UX60-MB-5S8(70)DKR-ND | OEPS M05 036 | TMK325ABJ476MM-T | 456(R) 7 30 | 493 | 456 | Reel | XX21 | 7 | Bag | N/A | 30 | Bag | N/A
CONNECTOR: USB 2.0 MINI R/A [UX60-MB-5S8] [SMD] | OEPS070021 | SMD | UX60-MB-5S8 | 1 | DigiKey | H2960DKR-ND | OEPS M05 037 | 1008PS-472KLB | 51(R) 3 5 | 59 | 51 | Reel | XX21 | 3 | Bag | XXXX | 5 | Bag | N/A
CONNECTOR: USB2.0 TYPE C 16P SMD R/A [USB4105-GF-A] [SMD/TH] | OEPS070105 | SMD/TH | USB4105-GF-A | 1 | Digikey | 2073-USB4105-GF-ADKR-ND | OEPS M05 038 | BLM18KG601SN1D | 265(R) | 265 | 265 | Reel | XX21
CONNECTOR: USB2.0 TYPE C 24P SMD R/A [USB4110-GF-A] [SMD] | OEPS070153 | SMD | USB4110-GF-A | 1 | Digikey | 2073-USB4110-GF-A-6-ND | OEPS M05 039 | SRN6045TA-101M | 8 30(R) | 38 |  |  |  | 8 | Bag | N/A |  |  |  | 30 | Reel | 0122
CONNECTOR: USB3.0 MICRO B SMD R/A [897-10-010-40-300002] [SMD] | OEPS070094 | SMD | 897-10-010-40-300002 | 1 | Digikey | ED1128DKR-ND | OEPS M05 040 | MPZ2012S102AT000 | 110(R) 9 | 119 | 110 | Reel | XX21 | 9 | Bag | N/A
CONNECTOR: USB3.1 TYPE C 24P SMD R/A [12401610E4#2A] [SMD/TH] | OEPS070128 | SMD/TH | 12401610E4#2A | 1 | Mouser | 523-12401610E4#2A | OEPS M05 041 | BLM15PX601SN1D | 160(R) 124(R) | 284 | 160 | Reel | XX21 | 124 | Reel | XX20
CONNECTOR: X.FL RCPT Straight 50 OHM (OEPS Q20 002) [X.FL-R-SMT-1(02)] [SMD] | OEPS070052 | SMD | X.FL-R-SMT-1(02) | 1 | DigiKey | H122100DKR-ND | OEPS M05 042 | HSMG-C280 | 198(R) | 198 | 198 | Reel | XX21
DIODE: DIODE SCHOTTKY 20V 1A [SM5817PL-TP] [SOD-123FL] | OEPS030030 | SMD | SM5817PL-TP | 5 | Digikey | SM5817PL-TPMSDKR-ND | OEPS M05 043 | SESD0402X1UN0030
DIODE: DIODE SCHOTTKY 20V 1A 340m@1A [MBR120VLSFT3G] [SOD-123FL] | OEPS030046 | SMD | MBR120VLSFT3G | 5 | Digikey | MBR120VLSFT3GOSDKR-ND | OEPS M05 044 | BAR66E6327
DIODE: DIODE SCHOTTKY 30V 2A [PMEG3020EP,115] [SOD128] | OEPS030027 | SMD | PMEG3020EP,115 | 10 | DigiKey | 1727-5836-6-ND | OEPS M05 045 | KDZVTR4.3B | 63(R) | 63 | 63 | Reel | XX21
DIODE: DIODE SCHOTTKY 30V 340mA ARRAY [BAT54SW] [TH] | OEPS030056 | TH | BAT54SW | 1 | DigiKey | 5399-BAT54SWCT-ND | OEPS M05 046 | APFA3011AK13F | 102(R) | 102 | 102 | Reel | XX21
DIODE: DIODE SCHOTTKY 40V 1A [CDBW140-G] [SOD-123] | OEPS030034 | SMD | CDBW140-G | 10 | Digikey | 641-1458-6-ND | OEPS M05 047 | SI1012R-T1-GE3
DIODE: DIODE SCHOTTKY ARRAY 30V 100mA [BAR43AFILM] [SOT-23-3] | OEPS030036 | SMD | BAR43AFILM | 10 | Digikey | 497-2514-6-ND | OEPS M05 048 | SN74LVC2G34DCKR | 43(R) | 43 | 43 | Reel | 1120
DIODE: DIODE SCHOTTKY ARRAY 30V 100mA [BAR43CFILM] [SOT-23-3] | OEPS030035 | SMD | BAR43CFILM | 10 | Digikey | 497-2520-6-ND | OEPS M05 049 | SN65LVDS9638DGNR | 33(R) | 33 | 33 | Reel | 1120
DIODE: DIODE ZENER 3.6V 0.2W [MM3Z3V6B] [SOD323F] | OEPS030048 | SMD | MM3Z3V6B | 10 | DigiKey | MM3Z3V6BDKR-ND | OEPS M05 050 | FIN1032MTCX | 33(R) | 33 | 33 | Reel | 1120
DIODE: DIODE ZENER 4.55V 1W [KDZVTR4.3B] [PMDU] | OEPS030051 | SMD | KDZVTR4.3B | 10 | DigiKey | KDZVTR4.3BDKR-ND | OEPS M05 051 | LTC2875IDD#PBF | 4(Tp) 38(Tp) 4(Tb) | 46 | 4 | Tape | N/A | 38 | Tape | N/A | 4 | Tube | N/A
DIODE: DIODE ZENER 7.5V 0.225W [MMBZ5236BLT1G] [SOT-23-3] | OEPS030025 | SMD | MMBZ5236BLT1G | 10 | DigiKey | MMBZ5236BLT1GOSDKR-ND | OEPS M05 052 | ADCMP600BRJZ-REEL7 | 85(R) | 85 | 85 | Reel | 1120
DIODE: DIODE ZENER 7.5V 1W [SMAZ7V5-13-F] [DO-214AC] | OEPS030026 | SMD | SMAZ7V5-13-F | 5 | DigiKey | SMAZ7V5-FDIDKR-ND | OEPS M05 053 | DG1412EEN-T1-GE4 | 118(R) | 118 | 118 | Reel | 1120
DIODE: Dual Series Schottky 30V 0.2A [BAT54SLT1G] [SOT-23-5] | OEPS030003 | SMD | BAT54SLT1G | 10 | DigiKey | BAT54SLT1GOSDKR-ND | OEPS M05 054 | DS90UB914ATRHSTQ1 | 3(Tp) | 3 | 3 | Tape | 0320
DIODE: LED 0603 Blue 470nm 20mA [5988D90107F] [0603] | OEPS030042 | SMD | 5988D90107F | 10 | Digikey | 350-5988D90107FDKR-ND | OEPS M05 055 | DS91M040TSQ/NOPB | 34(R) | 34 | 34 | Reel | 1120
DIODE: LED 0603 Green 571nm 20mA [LTST-C191KGKT] [0603] | OEPS030005 | SMD | LTST-C191KGKT | 20 | DigiKey | 160-1446-6-ND | OEPS M05 056 | AD5766BCPZ-RL | 40(R) | 40 | 40 | Reel | 0122
DIODE: LED 0603 Green 571nm 20mA (OEPS J30 049A) [LSM0603453V] [0603] | OEPS030032 | SMD | LSM0603453V | 5 | Digikey | LSM0603453VDKR-ND | OEPS M05 057 | MCP47FEB02A0-E/ST
DIODE: LED 0603 Infrared 850nm 65mA [HIR19-21C/L11/TR8] [0603] | OEPS030047 | SMD | HIR19-21C/L11/TR8 | 10 | Digikey | 1080-1347-6-ND | OEPS M05 058 | LM4132AMF-2.5/NOPB | 38(R) | 38 | 38 | Reel | 1120
DIODE: LED 0603 Red 633nm 20mA [5990010007F] [0603] | OEPS030044 | SMD | 5990010007F | 10 | Digikey | 350-4346-6-ND | OEPS M05 059 | AD7617BSTZ | 2(Tr) | 2 | 2 | Tray | 0123
DIODE: LED 0603 Red 635nm 20mA [5975004407F] [0603] | OEPS030006 | SMD | 5975004407F | 10 | DigiKey | 350-2950-6-ND | OEPS M05 060 | AD5142BCPZ10-RL7 | 35(R) 9(Tb) 4 | 48 | 35 | Reel | 1120 | 9 | Tube | 1120 | 4 | Bag | XXXX
DIODE: LED 0603 Red 635nm 20mA [VFHR1116P-4C82A-TR] [0603] | OEPS030038 | SMD | VFHR1116P-4C82A-TR | 10 | DigiKey | 404-1224-6-ND | OEPS M05 061 | LTM4622AIYPBF | 42(Tr) | 42 | 42 | Tray | 0122
DIODE: LED 0603 Yellow 590nm 20mA [5990040007F] [0603] | OEPS030043 | SMD | 5990040007F | 10 | Digikey | 350-4349-6-ND | OEPS M05 062 | TPS7A4901DRBR | 96(R) | 96 | 96 | Reel | 1120
DIODE: LED 0805 White 20mA [OVS-0801] [0805] | OEPS030054 | SMD | OVS-0801 | 10 | Farnell | 1716764 | OEPS M05 063 | TPS7A3001DRBT | 55(R) | 55 |  |  |  |  |  |  | 55 | Reel | 0122
DIODE: LED ARRAY 10-SEG Green [DC10GWA] [TH] | OEPS030045 | TH | DC10GWA | 1 | DigiKey | 754-1177-5-ND | OEPS M05 064 | 24AA64-I/ST | 47(R) | 47 |  |  |  |  |  |  | 47 | Reel | 0122
DIODE: LED DUAL Red 635nm 20mA [569-0111-100F] [TH] | OEPS030007 | TH | 569-0111-100F | 1 | DigiKey | 350-1782-ND | OEPS M05 065 | LTM8049IY#PBF | 40 | 40 | 40 | Bag | 0122
DIODE: LED SMD 0402 Red 621nm 1mA [SML-P11UTT86R] [0402] | OEPS030014 | SMD | SML-P11UTT86R | 30 | DigiKey | SML-P11UTT86RDKR-ND | OEPS M05 066 | AD51442WBRUZ10-TL7 | 86 | 86 | 86 | Bag | 0322
DIODE: LED SMD Blue 450nm 500mA (OEPS J05 012) [LXZ1-PR01] [0705] | OEPS030021 | SMD | LXZ1-PR01 | 5 | DigiKey | 1416-1058-6-ND | OEPS M05 070 | ERJ-2RKF4702X | 95(R) | 95 | 95 | Reel | XX21
DIODE: LED SMD Blue 470nm 500mA (OEPS J05 012A) [LXZ1-PB01] [0705] | OEPS030020 | SMD | LXZ1-PB01 | 5 | DigiKey | 1416-1052-6-ND | OEPS M05 071 | DS90UB934TRGZRQ1 | 15(R) 66(R) | 81 | 15 | Reel | 1120 | 66 | Reel | 1120
DIODE: LED SMD Green 565nm 20mA [SML-LX0603GW-TR] [0603] | OEPS030031 | SMD | SML-LX0603GW-TR | 20 | Digikey | 67-1549-6-ND | OEPS M1 900 | X.FL-R-SMT-1(02)
DIODE: LED SMD Green Clear 515nm 20mA [150060GS75000] [0603] | OEPS030033 | SMD | 150060GS75000 | 10 | Digikey | 732-4971-6-ND | OEPS M1 901 | CIG21L4R7MNE | 385(R) | 385 | 385 | Reel | 0819
DIODE: LED SMD Infrared 860nm 100mA (OEPS H02 008) [SFH 4050-Z] [2-SMD] | OEPS030024 | SMD | SFH 4050-Z | 10 | DigiKey | 475-SFH4050-ZDKR-ND | OEPS M10 001 | M20-8770442
DIODE: LED SMD Lime 568nm (OEPS J05 090) [LXZ1-PX01] [0705] | OEPS030022 | SMD | LXZ1-PX01 | 5 | DigiKey | 1416-1186-6-ND | OEPS M10 002 | EVQ-P7J01P
DIODE: LED SMD Red 624nm 20mA [LTST-C191KEKT] [0603] | OEPS030029 | SMD | LTST-C191KEKT | 20 | DigiKey | 160-LTST-C191KEKTDKR-ND | OEPS M10 003 | TNPU0603500RA ZEN00
DIODE: LED SMD Red 630nm 20mA [XZMDK45WT-9] [2-PLCC] | OEPS030018 | SMD | XZMDK45WT-9 | 5 | DigiKey | 1497-1331-6-ND | OEPS M10 004 | RC0603FR-071K33L
DIODE: LED SMD Red 631nm 20mA (OEPS J05 013) [VLMS1500-GS08] [0402] | OEPS030023 | SMD | VLMS1500-GS08 | 30 | DigiKey | VLMS1500-GS08DKR-ND | OEPS M10 005 | RC0603FR-074K7L
DIODE: LED SMD RGB Red 621nm Green 525nm Blue 468nm [ASMB-LTC2-0A335] [4-PLCC] | OEPS030028 | SMD | ASMB-LTC2-0A335 | 5 | DigiKey | 516-4290-6-ND | OEPS M10 006 | RC0603FR-0710KL
DIODE: LED SMD RGB Red 645nm Green 515nm Blue 460nm [XZMDKCBDDG45S-9] [4-PLCC] | OEPS030057 | SMD | XZMDKCBDDG45S-9 | 3 | DigiKey | 1497-1257-6-ND | OEPS M10 007 | RC0603FR-071M2L
DIODE: LED TH 5MM Green, Red 20mA [MCL059PURGW] [TH] | OEPS030012 | TH | MCL059PURGW | 1 | Farnell | 1581197 | OEPS M10 008 | MCT06030C1504FP500
DIODE: LED TH 5MM Super Red 630nm 50mA [TLCS5100] [TH] | OEPS030011 | TH | TLCS5100 | 1 | Farnell | 3777905 | OEPS M10 010 | CL10A105KA8NNNC
DIODE: LED TH Green 565nm 20mA R/A [SSF-LXH100GD-01] [TH] | OEPS030055 | TH | SSF-LXH100GD-01 | 1 | DigiKey | 67-1310-ND | OEPS M10 011 | CL21A225KAFNNNE
DIODE: LED TH Infrared 950nm 50mA [GL480E00000F] [TH] | OEPS030053 | TH | GL480E00000F | 1 | DigiKey | 1855-1055-ND | OEPS M10 012 | TMK316BBJ226ML-T
DIODE: RF DIODE PIN 150V 250MW [BAR66E6327HTSA1] [PG-SOT23] | OEPS030050 | SMD | BAR66E6327HTSA1 | 10 | DigiKey | BAR66E6327HTSA1DKR-ND | OEPS M10 013 | UCD1E101MCL6GS
DIODE: RGB SMD B [EAST1616RGBA8] [6-SMD] | OEPS030013 | SMD | EAST1616RGBA8 | 4 | DigiKey | 1080-EAST1616RGBA8DKR-ND | OEPS M10 014 | HV0820-2R7305-R
DIODE: Schottky 30V 0.1A [CMDSH-3 TR PBFREE] [SOD-323] | OEPS030008 | SMD | CMDSH-3 TR PBFREE | 10 | DigiKey | 1514-CMDSH-3TRPBFREEDKR-ND | OEPS M10 015 | XZMDKCBDDG45S-9
DIODE: Schottky 30V 4A [SSB43L-E3/52T] [DO-214AA (SMB)] | OEPS030009 | SMD | SSB43L-E3/52T | 5 | DigiKey | SSB43L-E3/52TGIDKR-ND | OEPS M10 016 | IS31FL3193-DLS2-TR
DIODE: Schottky 40V 1A [B140-13-F] [DO-214AC] | OEPS030016 | SMD | B140-13-F | 10 | DigiKey | B140-FDIDKR-ND | OEPS M10 017 | LTC4425EMSE#PBF
DIODE: Standard 100V 250mA 500mA (OEPS J05 011) [BAS316-TP] [SOD-323] | OEPS030019 | SMD | BAS316-TP | 10 | DigiKey | BAS316-TPMSDKR-ND | OEPS M10 018 | PTN04050CAZ
DIODE: Standard 400V 1A [S1G] [SMA] | OEPS030001 | SMD | S1G | 20 | DigiKey | 1655-S1GDKR-ND | OEPS M10 019A | SSM-108-L-SV-P-TR
DIODE: Standard 60V 20A [SBRT20M60SP5-7] [ PowerDI™ 5] | OEPS030015 | SMD | SBRT20M60SP5-7 | 5 | DigiKey | SBRT20M60SP5-7DIDKR-ND | OEPS M10 020 | TMCSILENTSTEPSPI
DIODE: Standard 75V 150mA [1N4148WS-E3-18] [SOD-323] | OEPS030052 | SMD | 1N4148WS-E3-18 | 10 | DigiKey | 1N4148WS-E3-18GIDKR-ND | OEPS M10 021 | TSW-108-07-G-S
DIODE: Standard 75V 150mA [1N4148WX-TP] [SOD-323] | OEPS030017 | SMD | 1N4148WX-TP | 10 | DigiKey | 1N4148WXTPMSDKR-ND | OEPS M10 022 | SSM114LSV
DIODE: TVS 15.3V 24.2A [P6SMB18CA] [SMB] | OEPS030002 | SMD | P6SMB18CA | 10 | DigiKey | P6SMB18CALFDKR-ND | OEPS M10 023 | NPTC031KFXC-RC
DIODE: TVS 8channel 8.8V 1A [CM1213-08MR] [10-MSOP] | OEPS030004 | SMD | CM1213-08MR | 5 | DigiKey | CM1213-08MROSDKR-ND | OEPS M10 025 | TSW11407GS
DIODE: TVS DIODE 3.3VWM 11.5VC [ESD9B3.3ST5G] [SOD-923] | OEPS030039 | SMD | ESD9B3.3ST5G | 10 | DigiKey | ESD9B3.3ST5GOSDKR-ND | OEPS M10 026 | TSW-103-07-G-S
DIODE: TVS DIODE 5.25VWM 17VC [USBLC6-2SC6] [SOT-23-6] | OEPS030010 | SMD | USBLC6-2SC6 | 5 | DigiKey | 497-5235-6-ND | OEPS M10 040 | 91292A191
DIODE: TVS DIODE 5.5VWM 14VC [TPD4E05U06DQAR] [10-UFDFN] | OEPS030037 | SMD | TPD4E05U06DQAR | 5 | Digikey | 296-35765-6-ND | OEPS NP1 001 | CC603KRX7R9BB104 | 36(R) | 36 | 36 | Reel | 0920
DIODE: TVS DIODE 5VWM 28VC [PESD5V0L2BT,215] [SOD-923] | OEPS030040 | SMD | PESD5V0L2BT,215 | 10 | DigiKey | 1727-3834-6-ND | OEPS NP1 003 | GRM18871E184KA8D | 22(R) | 22 | 22 | Reel | 0920
DIODE: TVS DIODE 7VWM 13VC [SESD0402X1UN-0030-088] [0402/2DFN] | OEPS030049 | SMD | SESD0402X1UN-0030-088 | 10 | DigiKey | SESD0402X1UN-0030-088DKR-ND | OEPS NP1 004 | C0603C222K3R | 11(R) | 11 | 11 | Reel | XX20
DIODE: TVS DIODE 7VWM 9.2VC [SESD0402X1UN-0020-090] [0402] | OEPS030041 | SMD | SESD0402X1UN-0020-090 | 10 | DigiKey | SESD0402X1UN-0020-090DKR-ND | OEPS NP1 006 | C0603C181J5G | 22(R) | 22 | 22 | Reel | 0520
DNP: Do Not Populate (DNI) | OEPS000000 | - | DNP | 0 | - | DNP | OEPS NP1 007 | CGA3E1X7R1V334K080AC | 11(R) | 11 | 11 | Reel | 0320
IC: 1/1 TRANSCEIVER HALF RS485 [THVD1450D] [8-SOIC] | OEPS080171 | SMD | THVD1450D | 3 | Digikey | 296-49500-ND | OEPS NP1 008 | 06035A470J | 42(R) | 42 | 42 | Reel | 0520
IC: 2-CHANNEL SWITCH SPDT [TMUX136RSER] [10-UQFN] | OEPS080110 | SMD | TMUX136RSER | 5 | DigiKey | 296-47397-6-ND | OEPS NP1 010 | GRM188R6E225MA2D | 19(R) | 19 | 19 | Reel | 0520
IC: 8-BIT SHIFT REGISTER [SN74HC595PWR] [16-TSSOP] | OEPS080200 | SMD | SN74HC595PWR | 3 | Digikey | 296-23258-6-ND | OEPS NP1 012A | TPSR105K025R4000 | 111(R) | 111 | 111 | Reel | 0920
IC: 8-BIT SHIFT REGISTER Schmitt-Trigger [SN74HCS595PWR] [16-TSSOP] | OEPS080159 | SMD | SN74HCS595PWR | 3 | Digikey | 296-SN74HCS595PWRDKR-ND | OEPS NP1 013 | 06035C472K | 11 | 11 | 11 | Bag | N/A
IC: ACCELEROMETER 3G ANALOG (OEPS H1 009) [ADXL335BCPZ-RL7] [16-LQFN Exposed Pad] | OEPS080123 | SMD | ADXL335BCPZ-RL7 | 1 | DigiKey | ADXL335BCPZ-RL7DKR-ND | OEPS NP1 015 | EMK212ABJ106MG-T
IC: ADC 12BIT SAR [ADC121S021CIMFX/NOPB] [SOT-23-6] | OEPS080120 | SMD | ADC121S021CIMFX/NOPB | 4 | DigiKey | 296-37316-6-ND | OEPS NP1 020 | ESD9X3.3ST5G | 205(R) | 205 | 205 | Reel | 0623
IC: ADC 14BIT SAR [MCP33151D-10-E/MS] [10-MSOP] | OEPS080023 | SMD | MCP33151D-10-E/MS | 2 | DigiKey | MCP33151D-10-E/MS-ND | OEPS NP1 024 | 1N4148W-E3-18
IC: ADC 14BIT SAR 2 channels [AD7321BRUZ-REEL7] [14-TSSOP] | OEPS080225 | SMD | AD7321BRUZ-REEL7 | 0 | Digikey | AD7321BRUZ-REEL7DKR-ND | OEPS NP1 025 | 1424198 | 2 1 | 3 | 2 | Bag | XXXX | 1 | Bag | XXXX
IC: ADC 16BIT 16 channels [AD7616BSTZ] [80-LQFP] | OEPS080205 | SMD | AD7616BSTZ | 0 | Digikey | 505-AD7616BSTZ-ND | OEPS NP1 026 | BLM18SG331TN1D
IC: Analog Switch SP3T X 2 [STG3856QTR] [12-QFN] | OEPS080088 | SMD | STG3856QTR | 3 | DigiKey | 497-6174-6-ND | OEPS NP1 027 | MI0805K400R-10
IC: Analog Switch SPDT [TS5A3159AYZPR] [6-DSBGA] | OEPS080078 | SMD | TS5A3159AYZPR | 10 | DigiKey | 296-18671-6-ND | OEPS NP1 028 | BLM18KG601SN1D
IC: AUDIO POWER AMPLIFIER MONO CLASS AB 1.5W [NCS2211DR2G] [8-SOIC] | OEPS080145 | SMD | NCS2211DR2G | 2 | Digikey | NCS2211DR2GOSDKR-ND | OEPS NP1 029 | 61729-1011BLF | 1 1(Tb) | 2 | 1 | Bag | XX20 | 1 | Tube | XXXX
IC: AUDIO SWITCH [FSA553UCX] [9-WLCSP] | OEPS080198 | SMD | FSA553UCX | 1 | DigiKey | FSA553UCXDKR-ND | OEPS NP1 030 | B2B-XH-A-GU
IC: AUTOSWITCHING POWER MUX [TPS2114APW] [ 8-TSSOP] | OEPS080039 | SMD | TPS2114APW | 3 | DigiKey | 296-16939-6-ND | OEPS NP1 031 | M80-8530642 | 1 2 3(Tb) | 6 | 1 | Bag | N/A | 2 | Box | XX21 | 3 | Tube | XXXX
IC: BATT CNTL LI-ION 1CEL [MCP73831T-2ACI/OT] [SOT-23-5] | OEPS080157 | SMD | MCP73831T-2ACI/OT | 5 | Digikey | MCP73831T-2ACI/OTDKR-ND | OEPS NP1 032 | N2514-6002RB | 1 1 | 2 | 1 | Box | 0920 | 1 | Bag | XXXX
IC: BATT PROT LI-ION 1CELL [BQ29700DSER] [6-WFDFN] | OEPS080156 | SMD | BQ29700DSER | 5 | Digikey | 296-43985-6-ND | OEPS NP1 033 | 90325-3006 | 1 | 1 | 1 | Bag | 0920
IC: BATTERY BACKUP SWITCH [ICL7673CBAZA-T] [8-SOIC] | OEPS080034 | SMD | ICL7673CBAZA-T | 2 | DigiKey | ICL7673CBAZA-TDKR-ND | OEPS NP1 034 | 30310-6002
IC: BATTERY LI-ION CHARGER [MCP73834-CNI/MF] [10-VFDFN Exposed Pad] | OEPS080177 | SMD | MCP73834-CNI/MF | 4 | Digikey | MCP73834-CNI/MF-ND | OEPS NP1 035 | M80-8820242 | 2(Tb) | 2 | 2 | Tube | 0920
IC: BATTERY LI-POLYMER CHARGER [MCP73831T-2ATI/OT] [SOT-23-5] | OEPS080035 | SMD | MCP73831T-2ATI/OT | 5 | DigiKey | MCP73831T-2ATI/OTDKR-ND | OEPS NP1 036 | 35RASMT2BHNTRX
IC: BUFFER INVERT 1CH [M74VHC1GT04DTT1G] [TSOP-5] | OEPS080036 | SMD | M74VHC1GT04DTT1G | 5 | DigiKey | M74VHC1GT04DTT1GOSDKR-ND | OEPS NP1 037 | 031-6575
IC: BUFFER INVERT 1CH 3-STATE [SN74LVC1G14DBVR] [SOT-23-5] | OEPS080160 | SMD | SN74LVC1G14DBVR | 5 | Digikey | 4518-SN74LVC1G14DBVRDKR-ND | OEPS NP1 040 | 1843606 | 1 1 | 2 | 1 | Bag | 0920 | 1 | Bag | 0721
IC: BUFFER INVERT 1CH 3-STATE [SN74LVC1G240DBVR] [SOT-23-5] | OEPS080028 | SMD | SN74LVC1G240DBVR | 5 | DigiKey | 296-11609-6-ND | OEPS NP1 042 | BCP56T1G | 6 | 6 | 6 | Bag | N/A
IC: BUFFER INVERT 1CH SCHMITT-TRIGGER [M74VHC1GT14DTT1G] [TSOP-5] | OEPS080037 | SMD | M74VHC1GT14DTT1G | 5 | DigiKey | M74VHC1GT14DTT1GOSDKR-ND | OEPS NP1 043 | RC0603FR-071KL | 470(R) | 470 | 470 | Reel | XX21
IC: BUFFER NON-INVERT 1CH 3-STATE [74LVC1G125GV,125] [SC-74A] | OEPS080087 | SMD | 74LVC1G125GV,125 | 5 | DigiKey | 1727-3100-6-ND | OEPS NP1 044 | RC0603FR-075K76L | 11(R) 444(R) | 455 | 11 | Reel | 0520 | 444 | Reel | XX21
IC: BUFFER NON-INVERT 1CH 3-STATE [M74VHC1GT126DF1G] [SC-70-5] | OEPS080033 | SMD | M74VHC1GT126DF1G | 5 | DigiKey | M74VHC1GT126DF1GOSDKR-ND | OEPS NP1 045 | ERJ-3EKF2801V | 144(R) 25(R) | 169 | 144 | Reel | XX21 | 25 | Reel | 0920
IC: BUFFER NON-INVERT 1CH 3-STATE [M74VHC1GT126DT1G] [TSOP-5] | OEPS080017 | SMD | M74VHC1GT126DT1G | 5 | DigiKey | M74VHC1GT126DT1GOSDKR-ND | OEPS NP1 046 | RC0603JR-070RL | 1774(R) 10(R) 1765(R) | 3549 | 1774 | Reel | XX21 | 10 | Reel | 0520 | 1765 | Reel | 0721
IC: BUFFER NON-INVERT 1CH 3-STATE [MC74VHC1GT125DBVT1G] [SC-74A] | OEPS080169 | SMD | MC74VHC1GT125DBVT1G | 10 | Digikey | 488-MC74VHC1GT125DBVT1GDKR-ND | OEPS NP1 047 | RC0603FR-071ML | 167(R) | 167 | 167 | Reel | XX21
IC: BUFFER NON-INVERT 1CH 3-STATE [SN74LVC1G125DBVT] [SOT-23-5] | OEPS080029 | SMD | SN74LVC1G125DBVT | 3 | DigiKey | 296-26595-6-ND | OEPS NP1 048 | ERJ-3EKF8662V | 19(R) 150(R) | 169 | 19 | Reel | 0420 | 150 | Reel | XX21
IC: BUFFER NON-INVERT 2CH [SN74LVC2G34DCKR] [SC-70-6] | OEPS080207 | SMD | SN74LVC2G34DCKR | 3 | Digikey | 296-13497-6-ND | OEPS NP1 049 | CRCW0603330RFKEAC | 245(R) 28(R) | 273 | 245 | Reel | XX21 | 28 | Reel | 0520
IC: BUFFER NON-INVERT 4+4CH 3-STATE [SN74ACT241DWR] [SOIC-20] | OEPS080022 | SMD | SN74ACT241DWR | 3 | DigiKey | 296-SN74ACT241DWRDKR-ND | OEPS NP1 050 | ERJ-3EKF3602V | 21(R) 145(R) 1 | 167 | 21 | Reel | 0520 | 145 | Reel | XX21 | 1 | Bag | XXXX
IC: BUFFER NON-INVERT 4CH 3-STATE [74HCT125D,653] [SOIC-14] | OEPS080024 | SMD | 74HCT125D,653 | 3 | DigiKey | 1727-2834-6-ND | OEPS NP1 051 | RC0603FR-07100KL | 11(R) 1805(R) 1118(R) | 2934 | 11 | Reel | XX21 | 1805 | Reel | XX21 | 1118 | Reel | 0721
IC: BUFFER NON-INVERT 4CH 3-STATE [74LVC126AD,118] [SOIC-14] | OEPS080027 | SMD | 74LVC126AD,118 | 3 | DigiKey | 1727-6365-6-ND | OEPS NP1 052 | ERJ-3EKF10R0V | 10(R) 1245(R) | 1255 | 10 | Reel | 0920 | 1245 | Reel | XX21
IC: BUFFER NON-INVERT 6CH [SN74LVC07APW] [14-TSSOP] | OEPS080059 | SMD | SN74LVC07APW | 2 | DigiKey | 296-26575-5-ND | OEPS NP1 053 | RC0603FR-0752K3L | 13(R) 147(R) | 160 | 13 | Reel | 0520 | 147 | Reel | XX21
IC: CAPACITIVE TOUCH SENSOR 6CH [CAP1296-1-AIA-TR] [10-DFN-EP] | OEPS080233 | SMD | CAP1296-1-AIA-TR | 3 | DigiKey | CAP1296-1-AIA-TRDKR-ND | OEPS NP1 054 | RC0603FR-0710KL | 655(R) | 655 | 655 | Reel | XX21
IC: CHARGE PUMP Dual-Rail [LTC3265EDHC#TRPBF] [18-DFN (5x3)] | OEPS080103 | SMD | LTC3265EDHC#TRPBF | 0 | DigiKey | 505-LTC3265EDHC#TRPBFDKR-ND | OEPS NP1 055 | AC0603FR-13100RL | 146(R) 11(R) | 157 | 146 | Reel | XX21 | 11 | Reel | 0520
IC: Common mode filter with ESD protection 2 CHAN [ECMF2-40A100N6] [8-SOIC] | OEPS080194 | SMD | ECMF2-40A100N6 | 5 | DigiKey | 497-ECMF2-40A100N6DKR-ND | OEPS NP1 056 | AC0603FR-1318KL | 520(R) | 520 | 520 | Reel | XX21
IC: Common mode filter with ESD protection 4 CHAN [ECMF4-40A100N10] [8-SOIC] | OEPS080195 | SMD | ECMF4-40A100N10 | 5 | DigiKey | 497-ECMF4-40A100N10DKR-ND | OEPS NP1 057 | RC0603FR-074K7L | 251(R) 998(R) 2575(R) | 3824 | 251 | Reel | 0920 | 998 | Reel | XX21 | 2575 | Reel | 0721
IC: COMPARATOR 1 GP [ADCMP600BRJZ-R2] [SOT23-5] | OEPS080208 | SMD | ADCMP600BRJZ-R2 | 1 | Digikey | 505-ADCMP600BRJZ-R2DKR-ND | OEPS NP1 059 | 67996-206HLF | 1 | 1 | 1 | Bag | 0920
IC: CURRENT MONITOR 2% [ZXCT1082QE5TA] [SOT-25] | OEPS080109 | SMD | ZXCT1082QE5TA | 5 | DigiKey | 31-ZXCT1082QE5TADKR-ND | OEPS NP1 060 | B3U-1000P | 8(Tp) | 8 | 8 | Tape | XXXX
IC: CURRENT SENSE 1 CIRCUIT [INA214AIDCKR] [SC-70-6] | OEPS080234 | SMD | INA214AIDCKR | 3 | DigiKey | 296-38956-6-ND | OEPS NP1 062 | SI7060-B-02-IVR | 69(R) | 69 | 69 | Reel | 0721
IC: DAC 12BIT [MCP4921T-E/MS] [8-MSOP] | OEPS080121 | SMD | MCP4921T-E/MS | 3 | DigiKey | MCP4921T-E/MSDKR-ND | OEPS NP1 064 | M74VHC1GT126DT1G | 5(R) | 5 | 5 | Reel | 0921
IC: DAC 16BIT [AD5683RARMZ] [10-MSOP] | OEPS080154 | SMD | AD5683RARMZ | 3 | Digikey | 505-AD5683RARMZ-ND | OEPS NP1 066 | SI8610BC-B-ISR | 2(Tb) | 2 | 2 | Tube | XX20
IC: DAC 16BIT [AD5752AREZ] [24-TSSOP] | OEPS080091 | SMD | AD5752AREZ | 0 | Mouser | 505-AD5752AREZ-ND | OEPS NP1 069 | MAX5443AEUA | 1 | 1 | 1 | Bag | 1120
IC: DAC 16BIT 16CH [AD5766BCPZ-RL7] [40-LFCSP-WQ (6x6)] | OEPS080212 | SMD | AD5766BCPZ-RL7 | 0 | Digikey | 505-AD5766BCPZ-RL7DKR-ND | OEPS NP1 070 | LD1117S33TR | 5(Tp) 4 | 9 | 5 | Tape | N/A | 4 | Bag | XXXX
IC: DAC 8BIT 2CH [MCP47FEB02A0-E/ST] [8-TSSOP] | OEPS080213 | SMD | MCP47FEB02A0-E/ST | 5 | Digikey | MCP47FEB02A0-E/ST-ND | OEPS NP1 071 | OPA4170AIDR | 2 1(Tb) | 3 | 2 | Bag | N/A | 1 | Tube | XX20
IC: DC DC CONVERTER 1 output 3.8V [XCL102D383CR-G] [CL-2025-02] | OEPS080192 | SMD | XCL102D383CR-G | 5 | DigiKey | 893-XCL102D383CR-GDKR-ND | OEPS NP1 072A | NL17SZ125DTT1G | 42(R) | 42 | 42 | Reel | 0921
IC: DC DC CONVERTER 1output 0.6-4.9V 10W [EN5322QI] [EN5322QI] | OEPS080042 | SMD | EN5322QI | 0 | Mouser | 884-EN5322QI-T | OEPS NP1 076 | TCR2EF18LMCT
IC: DC DC CONVERTER 1output 2.5V 2W [TPS826951SIP] [8-uSIP] | OEPS080097 | SMD | TPS826951SIP | 3 | DigiKey | 296-40992-6-ND | OEPS NP1 077 | SN74ACT241PWR | 4(Tp) | 4 | 4 | Tape | N/A
IC: DC DC CONVERTER ADJ 2outputs 2x1A [LTM8049IY#PBF] [77-BGA (15x9)] | OEPS080218 | SMD | LTM8049IY#PBF | 0 | Digikey | 505-LTM8049IY#PBF-ND | OEPS NP1 078 | LT1765EFE#TRPBF | 4(Tp) 1(Tp) 2(Tb) | 7 | 4 | Tape | N/A | 1 | Tape | 1020 | 2 | Tube | XXXX
IC: DC DC CONVERTER Boost/Inverter 2output ±40V 1.3A [LT3471EDD#PBF] [10-WFDFN Exposed Pad] | OEPS080125 | SMD | LT3471EDD#PBF | 1 | Digikey | 505-LT3471EDD#PBF-ND | OEPS NP1 078 | LT1765EFE#TRPBF | 40(R) | 40 | 40 | Reel | XXXX
IC: DC DC STEP-DOWN CONVERTER 1output 2.0-15.0V 600mA [MCP16301HT-E/CH] [SOT-23-6] | OEPS080057 | SMD | MCP16301HT-E/CH | 2 | DigiKey | MCP16301HT-E/CHDKR-ND | OEPS NP1 079 | MCP33151D-10-E/MS
IC: DC-DC CONVERTER 2outputs1.5-12V 1.5-12V [LTM4622AIY#PBF] [25-BGA] | OEPS080003 | SMD | LTM4622AIY#PBF | 0 | DigiKey | LTM4622AIY#PBF-ND | OEPS NP1 081 | SI8641AB-B-IS1R | 5(Tp) 10(Tb) | 15 | 5 | Tape | N/A | 10 | Tube | XXXX
IC: DESERIALIZER FPD-Link III [DS90UB934TRGZRQ1] [48-VQFN (7x7)] | OEPS080210 | SMD | DS90UB934TRGZRQ1 | 0 | Digikey | 296-DS90UB934TRGZRQ1DKR-ND | OEPS NP1 084 | MAX6162AESA | 1(Tb) | 1 | 1 | Tube | XX21
IC: DESERIALIZER FPD-LINK III (OEPS J30 04) [DS90UB914ATRHSTQ1] [48-WFQFN Exposed Pad] | OEPS080136 | SMD | DS90UB914ATRHSTQ1 | 1 | Digikey | 296-38936-6-ND | OEPS NP1 085 | DSC1001CI5
IC: DGT POT 10KOHM 256TAP (OEPS M05 060) [AD5142BCPZ10-RL7] [16-WFQFN Exposed Pad] | OEPS080143 | SMD | AD5142BCPZ10-RL7 | 1 | Digikey | 505-AD5142BCPZ10-RL7DKR-ND | OEPS Q20 003 | FH23-45S-0.3SHW(05) | 50(R) 5(R) | 55 | 50 | Reel | 0822 | 5 | Reel | 0521
IC: DGT POT 10KOHM 256TAP 16TSSOP [AD5142BRUZ10] [16-TSSOP] | OEPS080118 | SMD | AD5142BRUZ10 | 1 | DigiKey | AD5142BRUZ10-RL7DKR-ND | OEPS Q20 021A | CL03A105KP3NSNC | 220(R) | 220 | 220 | Reel | 0822
IC: DGT POT 10KOHM 256TAP 16TSSOP (AUTOMOTIVE) [AD5142WBRUZ10] [16-TSSOP] | OEPS080119 | SMD | AD5142WBRUZ10 | 1 | DigiKey | 505-AD5142WBRUZ10-RL7DKR-ND | OEPS Q20 031 | 10M08SAM153I7G | 28(Tr) | 28 | 28 | Tray | XXXX
IC: DGT POT 50KOHM 129TAP [MCP4541-503E/MS] [8-MSOP] | OEPS080144 | SMD | MCP4541-503E/MS | 2 | Digikey | MCP4541-503E/MS-ND | OEPS Q20 032 | ASCO2-24.000MHZ-EK-T3 | 61(R) | 61 | 61 | Reel | 0521
IC: DIGITAL ISOLATOR 1+1WAY [SI8621BC-B-ISR] [8-SOIC] | OEPS080031 | SMD | SI8621BC-B-ISR | 3 | DigiKey | 336-4774-6-ND | OEPS Q20 033 | MAX4945AELA+T | 37(R) 2 | 39 | 37 | Reel | 0621 | 2 | Bag | XXXX
IC: DIGITAL ISOLATOR 1WAY [SI8610BC-B-ISR] [8-SOIC] | OEPS080004 | SMD | SI8610BC-B-ISR | 3 | DigiKey | 336-4929-6-ND | OEPS Q20 034 | ADP7112ACBZ-1.8-R7 | 64(R) | 64 | 64 | Reel | 0521
IC: DIGITAL ISOLATOR 1WAY [SI8610EC-B-ISR] [8-SOIC] | OEPS080030 | SMD | SI8610EC-B-ISR | 3 | DigiKey | 336-4930-6-ND | OEPS Q20 037 | TPS8268180SIPR | 1 2 7 6 44(R) | 60 | 1 | Bag | 1122 | 2 | Bag | 0622 | 7 | Bag | 0623 | 6 | Bag | XXXX | 44 | Reel | 0621
IC: DIGITAL ISOLATOR 2 Channel [ADUM1201BRZ] [8-SOIC] | OEPS080172 | SMD | ADUM1201BRZ | 3 | Digikey | 505-ADUM1201BRZ-ND | OEPS Q20 038A | TPS7A2012PDQNR | 63(R) | 63 | 63 | Reel | 0621
IC: DIGITAL ISOLATOR 2+2WAY (OEPS NP1 080) [SI8642BC-B-IS1] [16-SOIC] | OEPS080084 | SMD | SI8642BC-B-IS1 | 1 | DigiKey | 336-4941-6-ND | OEPS Q20 041A | DSC6101MI1A-000.0000T | 200(R) 44 | 244 | 200 | Reel | 0822 | 44 | Bag | XXXX
IC: DIGITAL ISOLATOR 4 Channel [ISO7741DWR] [16-SOIC] | OEPS080227 | SMD | ISO7741DWR | 0 | Digikey | 296-47781-6-ND | OEPS Q20 043 | TS4231 | 100(R) | 100 | 100 | Reel | 0822
IC: DIGITAL ISOLATOR 6 Channel [ISO7760DWR] [16-SOIC] | OEPS080228 | SMD | ISO7760DWR | 0 | Digikey | 296-48142-6-ND | OEPS00001 | ERJ3GEYJ510V
IC: DIGITAL POT 100KOHM 256TAP (OEPS J05 037) [TPL0102-100RUCR] [14-XFQFN] | OEPS080075 | SMD | TPL0102-100RUCR | 3 | DigiKey | 296-28379-6-ND | OEPS00002 | ERJ-3GEYJ101V
IC: DIGITAL POT 50KOHM 256TAP [AD5248BRMZ50] [10-MSOP] | OEPS080058 | SMD | AD5248BRMZ50 | 2 | DigiKey | 505-AD5248BRMZ50-ND | OEPS00002A | RC0603JR-07100RL
IC: DMOS Transistor Array 8 Channels [TBD62083AFG,EL] [18-SOIC] | OEPS080176 | SMD | TBD62083AFG,EL | 3 | Digikey | TBD62083AFGELDKR-ND | OEPS00003 | ERJ-3GEYJ562V
IC: DRIVIC 4-70 Maxim MAX14574EWL 70 Vrms driver (OEPS J05 032) [71010120A] [SMD] | OEPS080070 | SMD | 71010120A | 2 | Corning | 71010120A | OEPS00004 | ERJ-3GEYJ103V
IC: EEPROM 2MBIT I2C 1MHZ (OEPS J30 045A) [M24M02-DRMN6TP] [8-SOIC] | OEPS080141 | SMD | M24M02-DRMN6TP | 1 | Digikey | 497-11600-6-ND | OEPS00005 | ERJ-3EKF2552V
IC: EEPROM 64KBIT I2C [24AA64-I/ST] [8-TSSOP] | OEPS080217 | SMD | 24AA64-I/ST | 5 | Digikey | 24AA64-I/ST-ND | OEPS00006 | ERJ-3EKF2742V
IC: EEPROM 64KBIT I2C [24CW640T-I/CS0668] [4-XFBGA] | OEPS080148 | SMD | 24CW640T-I/CS0668 | 10 | DigiKey | 24CW640T-I/CS0668DKR-ND | OEPS00007 | ERJ-3EKF3012V
IC: EEPROM 64KBIT I2C [AT24C64D-SSHM-T] [8-SOIC] | OEPS080150 | SMD | AT24C64D-SSHM-T | 3 | DigiKey | AT24C64D-SSHM-TDKR-ND | OEPS00007A | RC0603FR-0730K1L
IC: EEPROM 64KBIT I2C [M24C64-FCS6TP/K] [WLCSP-5] | OEPS080050 | SMD | M24C64-FCS6TP/K | 3 | DigiKey | 497-13610-6-ND | OEPS00008 | ERJ-3EKF3092V
IC: EEPROM 64KBIT I2C [M24C64-FMN6TP] [8-SOIC] | OEPS080112 | SMD | M24C64-FMN6TP | 3 | DigiKey | 497-15762-6-ND | OEPS00009 | ERJ-3GEYJ563V
IC: FIXED BUCK REG 1.8V 500mA (OEPS J30 043) [TPS62231DRYT] [6-UFDFN] | OEPS080139 | SMD | TPS62231DRYT | 5 | Digikey | 296-24485-6-ND | OEPS00010 | ERJ3-3GEYJ823V
IC: FIXED REG BUCK 1.8V 1.6A [TPS62061DSGT] [8-WSON (2x2)] | OEPS080219 | SMD | TPS62061DSGT | 2 | Digikey | 296-TPS62061DSGTDKR-ND | OEPS00011 | ERJ-3EKF9532V
IC: FLASH 128MBIT SPI/QUAD [W25Q128JVSIQ] [8-SOIC] | OEPS080163 | SMD | W25Q128JVSIQ | 3 | Digikey | W25Q128JVSIQ-ND | OEPS00012 | ERJ-3GEYJ105V
IC: FLASH 8MBIT SPI/QUAD [AT25SF081B-SSHD-T] [ 8-SOIC] | OEPS080055 | SMD | AT25SF081B-SSHD-T | 2 | DigiKey | 1695-AT25SF081B-SSHD-TDKR-ND | OEPS00013 | C1608C0G1H150J080AA
IC: FLASH 8MBIT SPI/QUAD [W25Q80EWUXIE TR] [8-USON] | OEPS080101 | SMD | W25Q80EWUXIE TR | 5 | Mouser | 454-W25Q80EWUXIETR | OEPS00014 | C1608X7R2A102K080AA
IC: FPGA 21 I/O 30WLCSP [ICE40UP5K-UWG30ITR1K] [30-WLCSP] | OEPS080236 | SMD | ICE40UP5K-UWG30ITR1K | 0 | DigiKey | 220-2215-6-ND | OEPS00015 | C1608X7R1H103K080AA
IC: FPGA 29 I/O 64UCFBGA [LIF-MD6000-6UMG64I] [64-ucfBGA (3.5x3.5)] | OEPS080099 | SMD | LIF-MD6000-6UMG64I | 0 | DigiKey | 220-2172-ND | OEPS00016 | 06033C104K4T2A
IC: FPGA 63 I/O 81UCBGA [ICE40LP8K-CM81] [81-VFBGA] | OEPS080054 | SMD | ICE40LP8K-CM81 | 0 | DigiKey | 220-1858-ND | OEPS00017 | C2012X5R1C105K085AA
IC: GATE NAND 2CH 2-INP [SN74LVC2G132DCUR] [8VSSOP] | OEPS080162 | SMD | SN74LVC2G132DCUR | 3 | Digikey | 296-18802-6-ND | OEPS00018 | C1206C106Z8VACTU
IC: Hall Efect Magnetic Rotary Encoder 14 bits [AS5048A-HTSP] [14-TSSOP] | OEPS080108 | SMD | AS5048A-HTSP | 0 | DigiKey | 4991-AS5048A-HTSPDKR-ND | OEPS00019 | 293D106X0010A2TE3
IC: I2C I/O Expander 16 Channels [MCP23017-E/SO] [28-SOIC] | OEPS080175 | SMD | MCP23017-E/SO | 3 | Digikey | MCP23017-E/SO-ND | OEPS00020A | CL31A226KPHNNNE
IC: I2C Level Translator 2CH 400KHZ [PCA9509GM,125] [8-XQFN] | OEPS080089 | SMD | PCA9509GM,125 | 3 | DigiKey | 568-4288-6-ND | OEPS00021 | MLZ2012DR10DTD25
IC: I2C Level Translator 2CH 400KHZ (OEPS J05 034) [PCA9509AGM,125] [8-XQFN] | OEPS080072 | SMD | PCA9509AGM,125 | 3 | DigiKey | 568-9472-6-ND | OEPS00022 | AIML-1206-2R2K-T
IC: I3C Bus switch [P3S0200GMX] [10-XQFN (1.55x2)] | OEPS080106 | SMD | P3S0200GMX | 3 | DigiKey | 568-P3S0200GMXDKR-ND | OEPS00023 | TPS79301DBVRG4
IC: IC MCU 32BIT 256KB FLASH 48QFN [ATSAMD21G18A-MU] [48-VFQFN Exposed Pad] | OEPS080131 | SMD | ATSAMD21G18A-MU | 1 | Digikey | ATSAMD21G18A-MU-ND | OEPS00024 | LTC3426ES6#TRMPBF
IC: IC REG BUCK ADJ 2A [AP62200WU-7] [TSOT-26] | OEPS080122 | SMD | AP62200WU-7 | 5 | DigiKey | 31-AP62200WU-7DKR-ND | OEPS00025 | REF195GSZ
IC: IC TRANSLTR BIDIRECTIONAL 16UCSP [MAX13030EEBE+T] [16-UCSP] | OEPS080114 | SMD | MAX13030EEBE+T | 0 | DigiKey | 175-MAX13030EEBE+TDKR-ND | OEPS00026 | TPS72301DBVR
IC: Image Sensor PYTHON480 808H x 608V BW (OEPS J05 033) [NOIP1SP0480A-STI] [67-ODCSP] | OEPS080071 | SMD | NOIP1SP0480A-STI | 0 | Mouser | 863-NOIP1SP0480A-STI | OEPS00027 | TPS60403DBVR
IC: IMU ACCEL/GYRO/MAG I2C 28LGA (OEPS J05 028) [BNO055] [28-LGA] | OEPS080063 | SMD | BNO055 | 0 | DigiKey | 828-1058-6-ND | OEPS00028 | WS2812S | 156(R) | 156 | 156 | Reel | 0621
IC: INST AMP 1 CIRCUIT [AD622ANZ] [8-DIP] | OEPS080043 | SMD | AD622ANZ | 0 | DigiKey | 505-AD622ANZ-ND | OEPS00029 | ADS8325IDGKT
IC: INST AMP 1 CIRCUIT [AD8421BRZ-R7] [8-SOIC] | OEPS080222 | SMD | AD8421BRZ-R7 | 0 | DigiKey | AD8421BRZ-R7DKR-ND | OEPS00030 | DAC8531E/250
IC: INST AMP 1 CIRCUIT [MCP6N11-010E/SN] [8-SOIC] | OEPS080193 | SMD | MCP6N11-010E/SN | 5 | DigiKey | MCP6N11-010E/SN-ND | OEPS00031 | OPA4170AIDR
IC: Intan 16CH Bipolar Amplifier [RHD2216 #D8213] [56-QFN] | OEPS080124 | SMD | RHD2216 #D8213 | 0 | Intan | #D8213 | OEPS00031A | MCP6H04-E/SL
IC: Intan 16CH Stim/Amp [RHS2116 #D5716] [44-QFN] | OEPS080095 | SMD | RHS2116 #D5716 | 0 | Intan | #D5716 | OEPS00031B | MC33204DR2G
IC: Intan 32CH Unipolar Amplifier (OEPS H1 008) [RHD2132 #D8214] [56-QFN] | OEPS080080 | SMD | RHD2132 #D8214 | 0 | Intan | #D8214 | OEPS00032 | SN74LVC4245APWR
IC: Intan 64CH Unipolar Amplifier (OEPS M01 045) [RHD2164 #D8215] [104-BGA] | OEPS080081 | SMD | RHD2164 #D8215 | 0 | Intan | #D8215 | OEPS00033 | TCA9406DCUR
IC: IO EXPANDER I2C 16WAYS [TCA9555PWR] [24-TSSOP] | OEPS080005 | SMD | TCA9555PWR | 3 | DigiKey | 296-24827-6-ND | OEPS00034 | SJ-3523-SMT-TR
IC: LDO 1.2V 150mA [MIC5365-1.2YC5-TR] [SC-70-5] | OEPS080051 | SMD | MIC5365-1.2YC5-TR | 3 | DigiKey | 576-3175-6-ND | OEPS00035 | 1-1634622-0
IC: LDO 1.2V 250mA [NCP163AFCT120T2G] [4-WLCSP] | OEPS080100 | SMD | NCP163AFCT120T2G | 10 | DigiKey | NCP163AFCT120T2GOSDKR-ND | OEPS00036 | PJ-102AH
IC: LDO 1.8V 250mA [NCP163AFCT180T2G] [4-WLCSP] | OEPS080077 | SMD | NCP163AFCT180T2G | 10 | Mouser | 863-NCP163AFCT180T2G | OEPS00037 | 3-644456-3
IC: LDO 2.5V 200mA (OEPS M01 047) [TLV70725PDQNT] [4-XDFN] | OEPS080082 | SMD | TLV70725PDQNT | 10 | DigiKey | 296-34993-6-ND | OEPS00038 | 10029449-111RLF
IC: LDO 2.5V 250mA [NCP163AFCT250T2G] [4-WLCSP] | OEPS080062 | SMD | NCP163AFCT250T2G | 5 | DigiKey | 488-NCP163AFCT250T2GDKR-ND | OEPS00039 | ED555/2DS
IC: LDO 3.3V 150mA [LP5951MFX-3.3/NOPB] [SOT-23-5] | OEPS080026 | SMD | LP5951MFX-3.3/NOPB | 5 | DigiKey | 296-47807-6-ND | OEPS00040 | MBRA210LT3G
IC: LDO 3.3V 200mA [TLV70033DDCR] [SOT-23-THIN] | OEPS080086 | SMD | TLV70033DDCR | 5 | DigiKey | 296-27937-6-ND | OEPS00042 | BTE-040-01-F-D-A
IC: LDO 3.3V 250mA [LP5907MFX-3.3/NOPB] [SOT-23-5] | OEPS080016 | SMD | LP5907MFX-3.3/NOPB | 5 | DigiKey | 296-38557-6-ND | OEPS00044 | TPD1E10B06DPYR
IC: LDO 3.3V 250mA [MCP1700T-3302E/TT] [SOT-23-3] | OEPS080153 | SMD | MCP1700T-3302E/TT | 5 | DigiKey | MCP1700T3302ETTDKR-ND | OEPS00220 | LT1765EFE#TRPBF
IC: LDO 3.3V 250mA [NCP163AFCT330T2G] [4-WLCSP] | OEPS080096 | SMD | NCP163AFCT330T2G | 10 | DigiKey | NCP163AFCT330T2GOSDKR-ND | OEPS010001 | CC0402KRX7R8BB472 | 1(Tp) 97(Tp) | 98 | 1 | Tape | 1124 | 97 | Tape | 0625
IC: LDO 3.3V 250mA (OEPS Z00 004) [NCP163AMX330TBG] [4-XDFN] | OEPS080076 | SMD | NCP163AMX330TBG | 10 | DigiKey | NCP163AMX330TBGOSDKR-ND | OEPS010002 | GCM155R71E103KA37D
IC: LDO 3.3V 300mA [MIC5504-3.3YM5-TR] [SOT-23-5] | OEPS080052 | SMD | MIC5504-3.3YM5-TR | 3 | DigiKey | 576-4764-6-ND | OEPS010003 | GRM155R71E473KA88D
IC: LDO 3.3V 400mA [NCV4274ADT33RKG] [TO-252-3] | OEPS080011 | SMD | NCV4274ADT33RKG | 3 | DigiKey | NCV4274ADT33RKGOSDKR-ND | OEPS010004 | GRM155R71E104KE14D | 107(Tp) | 107 | 107 | Tape | 1124
IC: LDO 3.3V 400mA [SPX3819-3.3] [SOT-23-5] | OEPS080165 | SMD | SPX3819-3.3 | 5 | Mouser | 701-SPX3819M5-L/TR | OEPS010005 | GCM21BR71E105KA56L | 16(Tp) | 16 | 16 | Tape | XXXX
IC: LDO 3.3V 600mA [AP2112K-3.3TRG1] [SOT-23-5] | OEPS080155 | SMD | AP2112K-3.3TRG1 | 5 | Digikey | AP2112K-3.3TRG1DIDKR-ND | OEPS010006 | GRM21BR61E106KA73L
IC: LDO 3.3V 800mA [LD1117S33TR] [SOT-223] | OEPS080020 | SMD | LD1117S33TR | 5 | DigiKey | 497-1242-6-ND | OEPS010007 | GRM31CR71E106KA12L | 9(Tp) 151(R) | 160 |  |  |  | 9 | Tape | 0325 | 151 | Reel | 0425
IC: LDO 3.3V 800mA [LD1117S33TR] [SOT-223] | OEPS080146 | SMD | LD1117S33TR | 3 | Digikey | 497-1242-6-ND | OEPS010008 | TMK325ABJ476MM-T
IC: LDO 3V 500mA [TLV75530PDBVR] [SOT-23-5] | OEPS080199 | SMD | TLV75530PDBVR | 5 | Mouser | 296-TLV75530PDBVRDKR-ND | OEPS010009 | GRM188R72A104KA35D | 1(Tp) 1281(R) | 1282 |  |  |  |  |  |  | 1 | Tape | 0425 | 1281 | Reel | 0625
IC: LDO 5.0V 1A [MC7805BDTRKG] [TO-252-3] | OEPS080174 | SMD | MC7805BDTRKG | 3 | Digikey | MC7805BDTRKGOSDKR-ND | OEPS010010 | GRM31CR71E106KA12L | 3(Tp) | 3 | 3 | Tape | 1022
IC: LDO 5.0V 300mA [NCP718BSN500T1G] [TSOT-23-5] | OEPS080041 | SMD | NCP718BSN500T1G | 5 | DigiKey | NCP718BSN500T1GOSDKR-ND | OEPS010011 | 04025A470JAT2A |  |  | 1 | Tape | 0224 | 2 | Tape | 0221 | 8 | Tape | 1123 | 7 | Tape | 0326
IC: LDO 5V 100mA [MC78L05ACDR2G] [8-SOIC] | OEPS080226 | SMD | MC78L05ACDR2G | 5 | Digikey | MC78L05ACDR2GOSDKR-ND | OEPS010012 | 06035A470JAT2A | 3(Tp) | 3 | 3 | Tape | 1022
IC: LDO ADJ 1.5A (OEPS J30 041) [TPS74801DRCR] [10-VFDFN Exposed Pad] | OEPS080137 | SMD | TPS74801DRCR | 1 | Digikey | 296-21563-6-ND | OEPS010013 | GRM21BR61H475KE51L | 42(Tp) 8(Tp) 3(Tp) 349(R) | 402 | 42 | Tape | 1124 | 8 | Tape | 0325 | 3 | Tape | 1022 | 349 | Reel | 0425
IC: LDO ADJ 150mA [TPS7A4901DRBR] [8-SON (3x3)] | OEPS080215 | SMD | TPS7A4901DRBR | 1 | Digikey | 296-42154-6-ND | OEPS010014 | 885012206112 | 4(Tp) | 4 | 4 | Tape | 1022
IC: LDO ADJ 1A [TLV76701DRVR] [WSON-6] | OEPS080107 | SMD | TLV76701DRVR | 4 | DigiKey | 296-TLV76701DRVRDKR-ND | OEPS010015 | EMK107BBJ106MA-T | 4(Tp) 49(Tp) | 53 | 4 | Tape | 0426 | 49 | Tape | XXXX
IC: LDO ADJ 1A [TPS73801DCQR] [SOT-223-6] | OEPS080085 | SMD | TPS73801DCQR | 2 | DigiKey | 296-39489-6-ND | OEPS010016 | CGA2B3X7R1H104K050BB | 3(Tp) | 3 | 3 | Tape | 0126
IC: LDO ADJ 1A (OEPS J30 042) [TPS76801QD] [8-SOIC] | OEPS080138 | SMD | TPS76801QD | 5 | Digikey | 296-2743-5-ND | OEPS010017 | 885012205084 | 6(Tp) 9(Tp) | 15 | 6 | Tape | XXXX | 9 | Tape | 0126
IC: LDO ADJ 200mA [TPS79301DBVRG4] [SOT-23-6] | OEPS080129 | SMD | TPS79301DBVRG4 | 4 | Digikey | 296-52825-6-ND | OEPS010018 | C1608X6S1C475K080AC
IC: LDO ADJ 240mA [NJM11100F1-TE2] [SOT-23-6] | OEPS080147 | SMD | NJM11100F1-TE2 | 3 | Digikey | 2129-NJM11100F1-TE2DKR-ND | OEPS010019 | GCG188R91H184KA01D
IC: LDO DUAL 1.2V 1.8V 200mA 200mA [ADP220ACBZ-1812R7] [6-WLCSP] | OEPS080061 | SMD | ADP220ACBZ-1812R7 | 3 | DigiKey | 505-ADP220ACBZ-1812R7DKR-ND | OEPS010020 | C0402C331J5GAC7867 | 24(Tp) | 24 | 24 | Tape | 1122
IC: LDO DUAL 1.8V 1.2V 200mA 200mA [TPS71918-12DRVR] [WSON-6] | OEPS080046 | SMD | TPS71918-12DRVR | 2 | DigiKey | 296-22010-6-ND | OEPS010021 | GRM155R61A334KE15D
IC: LDO DUAL 2.5V 1.8V 300mA 300mA [MIC5335-JGYMT] [MLF-6] | OEPS080045 | SMD | MIC5335-JGYMT | 2 | DigiKey | 2156-MIC5335-JGYMT-ND | OEPS010022 | CL10A105KA8NNNC
IC: LDO DUAL 3.3V 1.8V 200mA 200mA (OEPS J05 036) [TLV7103318DSER] [6-WFDFN] | OEPS080074 | SMD | TLV7103318DSER | 4 | DigiKey | 296-46453-6-ND | OEPS010023 | CGA2B3X7R1V153K050BB
IC: LDO NEGATIVE ADJ 200mA [TPS72301DBVR] [SOT-23-5] | OEPS080130 | SMD | TPS72301DBVR | 2 | Digikey | 296-27049-6-ND | OEPS010024 | K220J15C0GF53L2 | 115 35 | 150 | 115 | Bag | 0622 | 35 | Bag | 0823
IC: LDO NEGATIVE ADJ 200mA [TPS7A3001DRBT] [8-SON (3x3)] | OEPS080216 | SMD | TPS7A3001DRBT | 1 | Digikey | 296-42285-6-ND | OEPS010025 | K102K15X7RH53L2 | 110 38 | 148 | 110 | Bag | 0823 | 38 | Bag | 0622
IC: LED Driver 1.5A Buck Regulator DC/CC [LM3406HVMH/NOPB] [14-HTSSOP] | OEPS080021 | SMD | LM3406HVMH/NOPB | 3 | DigiKey | LM3406HVMH/NOPB-ND | OEPS010026 | C322C104K5R5TA | 111 35 | 146 | 111 | Bag | 0622 | 35 | Bag | 0823
IC: LED Driver 150mA (OEPS J1 022) [LTC3218EDDB#TRMPBF] [10-WFDFN] | OEPS080069 | SMD | LTC3218EDDB#TRMPBF | 1 | DigiKey | 505-LTC3218EDDB#TRMPBFDKR-ND | OEPS010027 | MCRH35V106M5X11 | 44 249 | 293 | 44 | Bag | 0322 | 249 | Bag | 0723
IC: LED Driver 1A Buck Regulator DC/CC [AL8860WT-7] [SOT-23-5] | OEPS080191 | SMD | AL8860WT-7 | 3 | DigiKey | AL8860WT-7DIDKR-ND | OEPS010028 | ESK107M025AE3EA | 120 36 | 156 | 120 | Bag | 0723 | 36 | Bag | 0322
IC: LED DRIVER LENS [HV892K7-G] [10-WDFN] | OEPS080111 | SMD | HV892K7-G | 5 | DigiKey | HV892K7-GDKR-ND | OEPS010029 | GRM0335C1H270GA01D | 13(Tp) | 13 | 13 | Tape | 0923
IC: LED DRIVER LINEAR 42MA [IS31FL3193-DLS2-TR] [10-DFN-EP] | OEPS080232 | SMD | IS31FL3193-DLS2-TR | 3 | DigiKey | 2521-IS31FL3193-DLS2-TRDKR-ND | OEPS010030 | C1005X5R1E105K050BC | 91(Tp) | 91 | 91 | Tape | 0723
IC: LEVEL SHIFTER bidirectional 1way [TXB0101DBVR] [SOT-23-6] | OEPS080002 | SMD | TXB0101DBVR | 5 | DigiKey | 296-21664-6-ND | OEPS010031 | CC0201KRX5R8BB473 | 13(Tp) | 13 | 13 | Tape | 0923
IC: LEVEL TRANSLATOR 2CH BIDIRECTIONAL [TCA9406DCUR] [8-VFSOP] | OEPS080127 | SMD | TCA9406DCUR | 3 | Digikey | 296-28109-6-ND | OEPS010032 | CL31B106KBHNNNE | 9(Tp) 1 | 10 | 9 | Tape | 0425 | 1 | Bag | 0425
IC: LEVEL TRANSLATOR 8CH BIDIRECTIONAL [SN74LVC4245APWR] [24-TSSOP] | OEPS080126 | SMD | SN74LVC4245APWR | 3 | Digikey | 296-12183-6-ND | OEPS010033 | C0402C471J5GAC7867 | 81(Tp) | 81 | 81 | Tape | 0923
IC: LOW POWER HIGH-SIDE CURRENT MONITORS [ZXCT1109SA-7] [SOT-23-3] | OEPS080104 | SMD | ZXCT1109SA-7 | 5 | DigiKey | ZXCT1109SA-7DIDKR-ND | OEPS010034 | GRM155R71H223KA12D | 24(Tp) | 24 | 24 | Tape | XXXX
IC: LVDS 2channel driver [SN65LVDS9638DGN] [8-MSOP-PowerPad] | OEPS080007 | SMD | SN65LVDS9638DGN | 3 | DigiKey | 296-50530-6-ND | OEPS010035 | GRM033R61E104KE14J | 80(Tp) | 80 | 80 | Tape | 0923
IC: LVDS 4channel receiver [FIN1032MTCX] [16-TSSOP] | OEPS080006 | SMD | FIN1032MTCX | 3 | DigiKey | FIN1032MTCXFSDKR-ND | OEPS010036 | CL03A105MO3NRNH | 80(Tp) | 80 | 80 | Tape | 0923
IC: MCU 120MHZ 1024KB FLASH 64 [ATSAMD51J20A-UUT-EFP] [8-SOIC] | OEPS080115 | SMD | ATSAMD51J20A-UUT-EFP | 0 | DigiKey | 150-ATSAMD51J20A-UUT-EFPTR-ND | OEPS010037 | GRM033R71E103KE14D | 33(Tp) | 33 | 33 | Tape | 0923
IC: MCU ARM CORTEX-M0+ 32-BIT DUAL-CORE 133MHZ RP2040 [SC0914(13)] [56-VFQFN Exposed Pad] | OEPS080158 | SMD | SC0914(13) | 3 | Digikey | 2648-SC0914(13)DKR-ND | OEPS010038 | CL05A106MP5NUNC | 1(Tp) | 1 | 1 | Tape | 0825
IC: MCU ARM RP2354B0A4 [SC1512-A4] [QFN-80] | OEPS080220 | SMD | SC1512-A4 | 3 | Mouser | 358-SC1512 | OEPS010039 | GRJ188R72A104KE11D
IC: MCU ARM STM32 405 32bits 64KB [STM32F405RGT6] [64-LQFP] | OEPS080178 | SMD | STM32F405RGT6 | 1 | Digikey | 497-11767-ND | OEPS010041 | GRM033R61A105ME15D | 12(Tp) | 12 | 12 | Tape | 0224
IC: MCU ATMEGA 8bits 16KB (OEPS J05 027A) [ATMEGA168V-10MQR] [32-VQFN] | OEPS080065 | SMD | ATMEGA168V-10MQR | 2 | DigiKey | ATMEGA168V-10MQRDKR-ND | OEPS010042 | CM03X5R225M10AH
IC: MCU ATMEGA 8bits 32KB (OEPS J05 027) [ATMEGA328-MUR] [32-VQFN] | OEPS080066 | SMD | ATMEGA328-MUR | 2 | DigiKey | ATMEGA328-MURDKR-ND | OEPS010043 | GRM033R61C473KE84D | 8(Tp) | 8 | 8 | Tape | 0224
IC: MCU ATXMEGA A1U 8bits 128KB (OEPS NP1 061) [ATXMEGA128A1U-AU] [100-TQFP] | OEPS080083 | SMD | ATXMEGA128A1U-AU | 1 | DigiKey | ATXMEGA128A1U-AURDKR-ND | OEPS010044 | GRM033R71A103KA01D | 8(Tp) | 8 | 8 | Tape | 0224
IC: MCU ATXMEGA A1U 8bits 128KB (OEPS NP1 061) [ATXMEGA64A1U-C7U] [100-VFBGA] | OEPS080090 | SMD | ATXMEGA64A1U-C7U | 1 | Mouser | 556-ATXMEGA64A1U-C7U | OEPS010045 | CL05A106MQ5NUNC
IC: MCU ATXMEGA A4U 8bits 16KB [ATXMEGA16A4U-A] [ TQFP-44] | OEPS080032 | SMD | ATXMEGA16A4U-A | 1 | DigiKey | ATXMEGA16A4U-AURDKR-ND | OEPS010046 | GRM155R60J475ME47D | 1(Tp) | 1 | 1 | Tape | 0224
IC: MCU ATXMEGA A4U 8bits 32KB [ATXMEGA32A4U-A] [ TQFP-44] | OEPS080012 | SMD | ATXMEGA32A4U-A | 1 | DigiKey | ATXMEGA32A4U-AURDKR-ND | OEPS010047 | GRM188R61E475KE11D | 19(Tp) | 19 | 19 | Tape | 1123
IC: MCU ATXMEGA A4U 8bits 32KB [ATXMEGA32A4U-MHR] [44-VFQFN] | OEPS080116 | SMD | ATXMEGA32A4U-MHR | 0 | DigiKey | ATXMEGA32A4U-MHRDKR-ND | OEPS010048 | GRM21BR61A476ME15L | 8(Tp) | 8 | 8 | Tape | 0224
IC: MEMS OSC PROG BLANK 1MHZ-100MHZ [DSC6101JE1A-000.0000] [4-SMD] | OEPS080040 | SMD | DSC6101JE1A-000.0000 | 5 | DigiKey | DSC6101JE1A-000.0000-ND | OEPS010049 | GRM0335C1H300GA01D
IC: MEMS OSC PROG BLANK 1MHz-100MHZ [DSC6102MI2A-000.0000T] [4-SMD] | OEPS080092 | SMD | DSC6102MI2A-000.0000T | 3 | DigiKey | DSC6102MI2A-000.0000TDKR-ND | OEPS010050 | C1005X7R1E104K050BB | 1(Tp) 65(Tp) | 66 | 1 | Tape | 1225 | 65 | Tape | 0526
IC: MEMS OSC PROG BLANK 3.5KHZ-100MHZ [DSC6101MA3B-PROGT ] [4-SMD] | OEPS080049 | SMD | DSC6101MA3B-PROGT | 2 | DigiKey | 150-DSC6101MA3B-PROGTDKR-ND | OEPS010051 | GRM155R71H103KA88D | 1(Tp) 25(Tp) | 26 | 1 | Tape | 0425 | 25 | Tape | 0325
IC: MEMS OSC XO 16MHZ CMOS 25ppm [DSC6001CI2A-016.0000] [4-SMD] | OEPS080053 | SMD | DSC6001CI2A-016.0000 | 5 | Mouser | 579-C6001CI2A0160000 | OEPS010052 | GRM155R61A475MEAAD | 59(Tp) | 59 | 59 | Tape | 0526
IC: MEMS OSC XO 32MHZ CMOS 10ppm [DSC1001CI5-032.0000] [4-SMD] | OEPS080018 | SMD | DSC1001CI5-032.0000 | 5 | DigiKey | 150-DSC1001CI5-032.0000TDKR-ND | OEPS010053 | C1005C0G2A471J050BA | 65(Tp) 11(Tp) | 76 | 65 | Tape | 1023 | 11 | Tape | 0224
IC: MEMS OSC XO 50MHZ CMOS 50ppm [ECS-2520MVLC-500-BN-TR] [4-VLGA] | OEPS080102 | SMD | ECS-2520MVLC-500-BN-TR | 5 | DigiKey | 50-ECS-2520MVLC-500-BN-DKR-ND | OEPS010054 | 06035C105KAT2A | 3(Tp) 798(Tp) 2(Tp) 399(R) | 1202 | 3 | Tape | 0325 | 798 | Tape | 0325 | 2 | Tape | 1124 | 399 | Reel | 0425
IC: MOTOR DRIVER 2.7V-5.5V (OEPS K01 002) [TB6612FNG,C,8,EL] [24-SSOP] | OEPS080166 | SMD | TB6612FNG,C,8,EL | 3 | Digikey | TB6612FNGC8ELDKR-ND | OEPS010055 | GRM155Z71A225KE44D | 3(Tp) | 3 | 3 | Tape | 1023
IC: MULTIPLEXER 1 X 2:1 [74LVC1G157GV,125] [6-TSOP] | OEPS080170 | SMD | 74LVC1G157GV,125 | 10 | Digikey | 1727-3490-6-ND | OEPS010056 | C1608X7R2A223K080AA | 20(Tp) 8 | 28 | 20 | Tape | 0224 | 8 | Bag | 1023
IC: MULTIPLEXER 2 X 4:1 [DG409DYZ-T] [16-SOIC] | OEPS080223 | SMD | DG409DYZ-T | 0 | DigiKey | DG409DYZ-TDKR-ND | OEPS010057 | EEU-FR2A101
IC: Multiplexer Switch ICs [74HCT4067PW,118] [TSSOP-24] | OEPS080010 | SMD | 74HCT4067PW,118 | 3 | DigiKey | 1727-2059-6-ND | OEPS010066 | C1005X5R1V104K050BB | 65(Tp) | 65 | 65 | Tape | 0325
IC: OPAMP 1 CIRCUIT [TLV9061IDBVR] [SOT-23-5] | OEPS080179 | SMD | TLV9061IDBVR | 5 | Digikey | 296-52284-6-ND | OEPS010067 | GRM155R71E103KA01D | 19(Tp) 38(Tp) | 57 | 19 | Tape | 0425 | 38 | Tape | 0325
IC: OPAMP 1 CIRCUIT [TLV9061SIDBVR] [SOT-23-6] | OEPS080202 | SMD | TLV9061SIDBVR | 5 | Digikey | 296-53200-6-ND | OEPS010068 | 399-C0402C273K4RACTUDKR-ND | 85(Tp) | 85 | 85 | Tape | 0325
IC: OPAMP GP 1 CIRCUIT [MAX40111ANT+] [WLP-6] | OEPS080048 | SMD | MAX40111ANT+ | 3 | DigiKey | 175-MAX40111ANT+-ND | OEPS010069 | GRM033R61C273KE84D | 124(Tp) | 124 | 124 | Tape | 0825
IC: OPAMP GP 1 CIRCUIT [MCP6001T-I/OT] [SOT-23-5] | OEPS080190 | SMD | MCP6001T-I/OT | 3 | DigiKey | MCP6001T-I/OTDKR-ND | OEPS010070 | 0603N750J500CT | 9(Tp) 7(Tp) | 16 | 9 | Tape | 0325 | 7 | Tape | 1124
IC: OPAMP GP 1 CIRCUIT [OPA197IDBVT] [SOT-23-5] | OEPS080151 | SMD | OPA197IDBVT | 3 | DigiKey | 296-44076-6-ND | OEPS010071 | CL31A226KPHNNNE | 3(Tp) 2(Tp) 4(Tp) 1094(Tp) 700(R) | 1803 | 3 | Tape | 1124 | 2 | Tape | 0325 | 4 | Tape | 0125 | 1094 | Tape | 0325 | 700 | Reel | 0425
IC: OPAMP GP 1 CIRCUIT [OPA197IDR] [8-SOIC] | OEPS080229 | SMD | OPA197IDR | 0 | Digikey | 296-43866-6-ND | OEPS010072 | C1608C0G1H150J080AA | 5(Tp) 2(Tp) | 7 | 5 | Tape | 0325 | 2 | Tape | 1124
IC: OPAMP GP 1 CIRCUIT [OPA365AIDBVR] [SOT-23-5] | OEPS080149 | SMD | OPA365AIDBVR | 5 | DigiKey | 296-20645-6-ND | OEPS010073 | C1608X7R2A102K080AA | 2(Tp) | 2 | 2 | Tape | 1124
IC: OPAMP GP 1 CIRCUIT (OEPS J05 030) [LMV321IDCKR] [SC-70-5] | OEPS080068 | SMD | LMV321IDCKR | 5 | DigiKey | 296-9568-6-ND | OEPS010074 | C1608X7R103K080AA | 2(Tp) 3(Tp) 1185(R) | 1190 | 2 | Tape | 1124 | 3 | Tape | 0325 | 1185 | Reel | 0425
IC: OPAMP GP 2 CIRCUIT [AS358P-E1] [8-DIP] | OEPS080044 | SMD | AS358P-E1 | 0 | DigiKey | AS358P-E1DI-ND | OEPS010075 | GRM188R61E225KA12D | 11(Tp) | 11 | 11 | Tape | 0925
IC: OPAMP GP 2 CIRCUIT [MAX4489AUA+] [8-MSOP] | OEPS080197 | SMD | MAX4489AUA+ | 1 | DigiKey | MAX4489AUA+-ND | OEPS010077 | C2012X7R2A104K | 9(Tp) | 9 | 9 | Tape | 0326
IC: OPAMP GP 2 CIRCUIT [TLV272CDGKR] [TSSOP-8] | OEPS080019 | SMD | TLV272CDGKR | 5 | DigiKey | 296-26805-6-ND | OEPS010078 | CC0603JRNP09BN101 | 12(Tp) | 12 | 12 | Tape | 0425
IC: OPAMP GP 4 CIRCUIT [MC33204DR2G] [14-SOIC] | OEPS080128 | SMD | MC33204DR2G | 3 | Digikey | MC33204DR2GOSDKR-ND | OEPS010079 | C0402C102J5RACTU | 4(Tp) | 4 | 4 | Tape | 0325
IC: OPAMP GP 4 CIRCUIT (OEPS00031) [OPA4170AIDR] [14-SOIC] | OEPS080132 | SMD | OPA4170AIDR | 2 | Digikey | 296-29664-6-ND | OEPS010080 | CL05C220JB51PNC | 4(Tp) 10(Tp) | 14 | 4 | Tape | 0425 | 10 | Tape | 0825
IC: OPAMP PGA 1 CIRCUIT [LT1995CMS#PBF] [10-MSOP] | OEPS080221 | SMD | LT1995CMS#PBF | 1 | Mouser | 584-LT1995CMS#PBF | OEPS010081 | CL31B475KOHNNNE | 1(Tp) | 1 | 1 | Tape | 0425
IC: OPAMP VFB 1 CIRCUIT [THS4281DBVT] [SC-74A] | OEPS080038 | SMD | THS4281DBVT | 2 | DigiKey | 296-17000-6-ND | OEPS010084 | C0805C153K5RACTU | 4 | 4 | 4 | Bag | 0425
IC: Overvoltage protection [LTC4360ISC8-1#TRMPBF] [SC70-8] | OEPS080008 | SMD | LTC4360ISC8-1#TRMPBF | 3 | DigiKey | LTC4360ISC8-1#TRMPBFCT-ND | OEPS010086 | GRM1555C1H120JA01D | 8(Tp) | 8 | 8 | Tape | 0925
IC: OVERVOLTAGE PROTECTION [TLV841SADL01YBHR] [4-DSBGA] | OEPS080237 | SMD | TLV841SADL01YBHR | 5 | DigiKey | 296-TLV841SADL01YBHRDKR-ND | OEPS010088 | GRM21BR71E225KE11L | 11(Tp) | 11 | 11 | Tape | 0126
IC: PWR SWITCH N-CHAN [TBD62083APG] [18-DIP] | OEPS080189 | SMD | TBD62083APG | 1 | Digikey | TBD62083APG-ND | OEPS020001 | RC0402JR-070RL | 29(R) | 29 |  |  |  |  |  |  | 29 | Reel | XXXX
IC: PWR SWITCH P-CHAN 1:1 [MIC2004-0.5YM5-TR] [SOT-23-5] | OEPS080152 | SMD | MIC2004-0.5YM5-TR | 4 | DigiKey | 576-2582-6-ND | OEPS020002 | RR0510R-49R9-D
IC: REG BUCK ADJ 500MA [BD70522GUL-E2] [VCSP50L1] | OEPS080235 | SMD | BD70522GUL-E2 | 5 | DigiKey | BD70522GUL-E2DKR-ND | OEPS020003 | RC0402FR-0760R4L | 4(Tp) | 4 | 4 | Tape | 1022
IC: REGULATOR 3A Step-down Switching Regulator [LT1765EFE#TRPBF] [16-TSSOP-EP] | OEPS080025 | SMD | LT1765EFE#TRPBF | 0 | DigiKey | LT1765EFE#TRPBFDKR-ND | OEPS020004 | ERJ-2RKF1000X
IC: RES ARRAY 8 RES 100K OHM 1606 [YC248-JR-07100KL] [SMD] | OEPS080203 | SMD | YC248-JR-07100KL | 5 | Digikey | 13-YC248-JR-07100KLCT-ND | OEPS020005 | ERJ-2RKF4990X
IC: RES ARRAY 8 RES 10K OHM 2512 [745X101103JP] [SMD] | OEPS080015 | SMD | 745X101103JP | 5 | Mouser | 774-745X101103JP | OEPS020006 | ERJ-2RKF1001X | 13(Tp) | 13 | 13 | Tape | XXXX
IC: RES ARRAY 8 RES 2.2K OHM 1506 [EXB-2HV222JV] [SMD] | OEPS080206 | SMD | EXB-2HV222JV | 5 | Digikey | Y1222DKR-ND | OEPS020007 | ERJ-2RKF2001X | 4(Tp) 61(Tp) | 65 | 4 | Tape | 1225 | 61 | Tape | 0526
IC: RES ARRAY 8 RES 220K OHM 1606 [YC248-JR-07220KL] [SMD] | OEPS080201 | SMD | YC248-JR-07220KL | 5 | Digikey | 13-YC248-JR-07220KLCT-ND | OEPS020010 | ERJ-2RKF4701X | 1(Tp) 15(Tp) | 16 | 1 | Tape | 0425 | 15 | Tape | 0724
IC: RESISTOR ARRAY 220 OHM [4816P-T02-221LF] [16-SOIC] | OEPS080180 | SMD | 4816P-T02-221LF | 3 | Digikey | 4816P-T02-221LF-ND | OEPS020012 | ERJ-2RKF8251X
IC: RGB Neopixel addressable 1.5mmx1.5mm (pack of 10) [SK6805-E-J] [SMD] | OEPS080001 | SMD | SK6805-E-J | 10 | DigiKey | 1528-4492-ND | OEPS020013 | ERJ-2RKF1002X
IC: RGB Neopixel addressable 5mmx5mm (OEPS K01 012A) [XT1511RGBW-BW] [SMD] | OEPS080164 | SMD | XT1511RGBW-BW | 5 | Worldway | XT1511RGBW-BW | OEPS020014 | ERJ-2RKF1332X
IC: RGB Neopixel addressable 5mmx5mm (OEPS00028) [COM-16347] [SMD] | OEPS080009 | SMD | COM-16347 | 5 | DigiKey | 1568-COM-16347DKR-ND | OEPS020015 | ERJ-2RKF1502X | 6(Tp) 10(Tp) | 16 | 6 | Tape | 0625 | 10 | Tape | 0725
IC: RTC CLOCK/CALENDAR I2C [PCF8523T/1,118] [8-SOIC] | OEPS080167 | SMD | PCF8523T/1,118 | 3 | Digikey | 568-5306-6-ND | OEPS020017 | ERJ-2RKF4702X
IC: SENSOR REMOTE REC 38.0KHZ 40M [TSOP57438TT1] [-] | OEPS080117 | SMD | TSOP57438TT1 | 1 | DigiKey | TSOP57438TT1DKR-ND | OEPS020019 | ERJ-2RKF1003X
IC: SERIALIZER FPD-LINK III [DS90UB953ATRHBTQ1] [32-VQFN] | OEPS080098 | SMD | DS90UB953ATRHBTQ1 | 0 | Mouser | 595-S90UB953ATRHBTQ1 | OEPS020022 | ERJ-2RKF6493X
IC: SERIALIZER FPD-LINK III (OEPS J05 029) [DS90UB913ATRTVTQ1] [32-WQFN] | OEPS080067 | SMD | DS90UB913ATRTVTQ1 | 0 | DigiKey | 296-37226-6-ND | OEPS020024 | CRCW0805270RFKEAHP
IC: SERIALIZER FPD-LINK III (OEPS Q20 035) [DS90UB933TRTVTQ1] [32-WQFN] | OEPS080064 | SMD | DS90UB933TRTVTQ1 | 0 | DigiKey | 296-47324-6-ND | OEPS020025 | RC0805JR-070RL | 60(Tp) 25(R) | 85 | 60 | Tape | 0320 | 25 | Reel | 0122
IC: SMART INTEGRATED STEPPER DRIVER 36V [TMC2210ATJ+] [32-TQFN] | OEPS080056 | SMD | TMC2210ATJ+ | 2 | DigiKey | 175-TMC2210ATJ+-ND | OEPS020026 | CRCW04021M00FKED
IC: STEPPER MOTOR DRIVER [TMC2130-LA] [36-QFN ] | OEPS080231 | SMD | TMC2130-LA | 0 | DigiKey | 505-TMC2130-LA-ND | OEPS020027 | CRCW04021K00FKED
IC: SUPERCAP CHARGER [LTC4425EMSE#PBF] [12-MSOP-EP] | OEPS080230 | SMD | LTC4425EMSE#PBF | 0 | Digikey | LTC4425EMSE#PBF-ND | OEPS020028 | RCS0402100RFKED
IC: SUPERVISOR 1 CHANNEL [APX803L05-35SA-7] [SOT-23-3] | OEPS080168 | SMD | APX803L05-35SA-7 | 5 | Digikey | 31-APX803L05-35SA-7DKR-ND | OEPS020029 | RCS0402130RFKED | 15(Tp) | 15 | 15 | Tape | 0221
IC: Supply Voltage Monitor 1.52V [TPS3839E16DQNT] [X2SON-4] | OEPS080060 | SMD | TPS3839E16DQNT | 3 | DigiKey | 296-TPS3839E16DQNTDKR-ND | OEPS020030 | CRCW040210K0FKED | 1(Tp) | 1 |  |  |  |  |  |  | 1 | Tape | 0425
IC: Supply Voltage Monitor 1.67V [TPS3839G18DQNT] [X2SON-4] | OEPS080047 | SMD | TPS3839G18DQNT | 3 | DigiKey | 296-TPS3839G18DQNTDKR-ND | OEPS020031 | RCS0402240RFKED | 26(Tp) | 26 | 26 | Tape | 0221
IC: SWITCH SPDT X 1 15Ω [SN74LVC1G3157DCKR] [SC70-6] | OEPS080161 | SMD | SN74LVC1G3157DCKR | 3 | Digikey | 296-14909-6-ND | OEPS020032 | RCS040268R0FKED | 100(Tp) 10(Tp) | 110 | 100 | Tape | 0723 | 10 | Tape | 1124
IC: SWITCH SPST-NOX4 1.5OHM [DG1412EEN-T1-GE4] [16-QFN (4x4)] | OEPS080209 | SMD | DG1412EEN-T1-GE4 | 1 | Digikey | DG1412EEN-T1-GE4DKR-ND | OEPS020033 | RCS0402180RFKED | 15(Tp) | 15 | 15 | Tape | 0221
IC: Switched-capacitor Voltage Inverter [LM27761DSGR] [8-WSON] | OEPS080196 | SMD | LM27761DSGR | 5 | DigiKey | 296-44379-6-ND | OEPS020034 | RCS040239R0FKED | 10(Tp) 3(Tp) | 13 | 10 | Tape | 1122 | 3 | Tape | 0221
IC: TRANSCEIVER Half LVDS [DS91M040TSQ/NOPB] [32-WQFN (5x5)] | OEPS080211 | SMD | DS91M040TSQ/NOPB | 0 | Digikey | DS91M040TSQ/NOPBDKR-ND | OEPS020035 | ERJ-3GEYJ222V | 13(Tp) | 13 | 13 | Tape | 0824
IC: TVS DEVICE MIXED (OEPS J30 039) [NCP361SNT1G] [TSOT-23-5] | OEPS080135 | SMD | NCP361SNT1G | 5 | Digikey | NCP361SNT1GOSDKR-ND | OEPS020036 | ERJ-3GEYJ432V
IC: TVS DIODE ARRAY [D3V3XA4B10LP-7] [10-UFDFN] | OEPS080204 | SMD | D3V3XA4B10LP-7 | 5 | Digikey | 31-D3V3XA4B10LP-7DKR-ND | OEPS020037 | RC0402FR-07330RL | 7(Tp) 117(Tp) 2(Tp) | 126 | 7 | Tape | 1123 | 117 | Tape | 0224 | 2 | Tape | XXXX
IC: TVS DIODE ARRAY (OEPS J30 037) [SP3010-04UTG] [10-UFDFN] | OEPS080133 | SMD | SP3010-04UTG | 5 | Digikey | F3507DKR-ND | OEPS020038 | RC0402FR-0731K6L | 48(Tp) | 48 | 48 | Tape | XXXX
IC: USB 3.0 SWITCH 2 Channel [PI5USB30213AXEAEX] [24-XFQFN Exposed Pad] | OEPS080173 | SMD | PI5USB30213AXEAEX | 3 | Digikey | PI5USB30213AXEAEXDIDKR-ND | OEPS020039 | CRM2512-FX-15R0ELF | 63(R) | 63 |  |  |  | 63 | Reel | 0521
IC: USB BUS CONTROLLER EZ-USB FX3 (OEPS J30 038) [CYUSB3013-BZXC] [121-TFBGA] | OEPS080134 | SMD | CYUSB3013-BZXC | 5 | Digikey | 2156-CYUSB3013-BZXC-ND | OEPS020040 | RT0402BRD074K53L
IC: USB Hub Controller 2 Port USB 3.0 [TUSB8020BPHPR] [48-PowerTQFP] | OEPS080105 | SMD | TUSB8020BPHPR | 0 | DigiKey | 296-41024-6-ND | OEPS020041 | ERJ-PA2J100X | 12(Tp) | 12 |  |  |  | 12 | Tape | 1123
IC: USB Interface IC USB to Serial UART [FT232RNL-REEL] [SSOP-28] | OEPS080093 | SMD | FT232RNL-REEL | 1 | DigiKey | 768-FT232RNL-REELDKR-ND | OEPS020042 | CRCW0603100RFKEAHP | 7(Tp) 7(Tp) 141(Tp) | 155 | 7 | Tape | 0421 | 7 | Tape | 0325 |  |  |  | 141 | Tape | 0725
IC: USB Interface IC USB to Serial UART [FT232RNQ-REEL] [32-VFQFN] | OEPS080094 | SMD | FT232RNQ-REEL | 1 | DigiKey | 768-FT232RNQ-REELDKR-ND | OEPS020043 | CPF0402B10KE1 | 1000(R) | 1000 | 1000 | Reel | 0325
IC: USB Interface IC USB to Serial UART (OEPS NP1 073) [FT232RL-REEL] [SSOP-28] | OEPS080013 | SMD | FT232RL-REEL | 1 | DigiKey | 768-1007-6-ND | OEPS020044 | RT0402BRD0734KL | 5(Tp) 2(Tp) | 7 | 5 | Tape | 0425 | 2 | Tape | 1122
IC: USB POWER MANAGER [LTC3554EUD#PBF] [20-QFN] | OEPS080113 | SMD | LTC3554EUD#PBF | 1 | DigiKey | LTC3554EUD#PBF-ND | OEPS020045 | CRM2512-FX-20R0ELF
IC: USE OEPS030032 INSTEAD [LSM0603453V] [0603] | OEPS080140 | SMD | LSM0603453V | 5 | Digikey | LSM0603453VDKR-ND | OEPS020046 | ERA-2AEB513X
IC: VREF 2.5V 0.05% [LM4132AMF-2.5/NOPB] [SOT-23-5] | OEPS080214 | SMD | LM4132AMF-2.5/NOPB | 1 | Digikey | LM4132AMF-2.5/NOPBDKR-ND | OEPS020047 | RT0402BRD0714K7L | 20(Tp) | 20 | 20 | Tape | 0126
IC: VREF 2.5V 0.8% 5mA [AD1582ARTZ-REEL7] [SOT-23-3] | OEPS080224 | SMD | AD1582ARTZ-REEL7 | 1 | Digikey | 505-AD1582ARTZ-REEL7DKR-ND | OEPS020048 | ERJ-2RKF2402X | 1(Tp) 14(Tp) 1(Tp) | 16 |  |  |  | 1 | Tape | 0224 | 14 | Tape | 1023 | 1 | Tape | 0123
IC: XTAL OSC TCXO 32MHz HCMOS 2.5ppm [O 32,0-JT32C-A-K-3,3-LF] [4-SMD] | OEPS080014 | SMD | O 32,0-JT32C-A-K-3,3-LF | 5 | DigiKey | 1908-1044-6-ND | OEPS020049 | MCKNP02SJ0240A10 | 3 2 | 5 | 3 | Bag | XXXX | 2 | Bag | 0323
IC: XTAL OSC XO 26,0000MHz HCMOS 25ppm (OEPS J30 035) [XLH536026.000000I] [6-SMD] | OEPS080142 | SMD | XLH536026.000000I | 5 | Digikey | 631-1320-ND | OEPS020050 | 91A1A-B28-D10L | 3 | 3 | 3 | Bag | 0525
IC: XTAL OSC XO 48MHZ CMOS 25ppm [ECS-2016MV-480-CN-TR] [4-SMD] | OEPS080079 | SMD | ECS-2016MV-480-CN-TR | 5 | DigiKey | XC2807DKR-ND | OEPS020051 | AC0402FR-07100KL | 94(Tp) 150 | 244 | 94 | Tape | XX25 | 150 | Bag | 0723
IC: XTAL OSC XO 66.6667MHZ CMOS 50ppm (OEPS J05 035C) [KC2520K66.6667C1GE00] [4-SMD] | OEPS080073 | SMD | KC2520K66.6667C1GE00 | 3 | DigiKey | 478-KC2520K66.6667C1GE00DKR-ND | OEPS020052 | MF25 1M
INDUCTOR: COMMON MODE CHOKE 330mA 2LN 90Ω [DLW21HN900SQ2L] [2.0mm X 1.2mm] | OEPS040030 | SMD | DLW21HN900SQ2L | 10 | Digikey | 490-1064-6-ND | OEPS020053 | MF25 100K | 165 | 165 | 165 | Bag | 0723
INDUCTOR: FERRITE BEAD SMD 0201 120Ω 900mA 160mΩ [BLM03PX121SN1D] [0201] | OEPS040020 | SMD | BLM03PX121SN1D | 30 | DigiKey | 490-BLM03PX121SN1DDKR-ND | OEPS020054 | MF25 22K | 165 | 165 | 165 | Bag | 0723
INDUCTOR: FERRITE BEAD SMD 0201 1kΩ 200mA 1.25Ω [BLM03AX102SN1D] [0201] | OEPS040018 | SMD | BLM03AX102SN1D | 30 | DigiKey | 490-5625-6-ND | OEPS020055 | MF25 2K2 | 165 | 165 | 165 | Bag | 0723
INDUCTOR: FERRITE BEAD SMD 0201 500Ω 500mA 360mΩ [BLF03RD501GZED] [0201] | OEPS040006 | SMD | BLF03RD501GZED | 30 | DigiKey | 490-BLF03RD501GZEDDKR-ND | OEPS020056 | MF25 1K | 165 | 165 | 165 | Bag | 0723
INDUCTOR: FERRITE BEAD SMD 0402 1kΩ 350mA 490mΩ [BLM15AX102SN1D] [0402] | OEPS040016 | SMD | BLM15AX102SN1D | 20 | DigiKey | 490-5442-6-ND | OEPS020057 | MF25 220R | 165 | 165 | 165 | Bag | 0723
INDUCTOR: FERRITE BEAD SMD 0402 600Ω 900mA 230mΩ [BLM15PX601SN1D] [0402] | OEPS040019 | SMD | BLM15PX601SN1D | 20 | DigiKey | 490-9657-6-ND | OEPS020058 | CRCW02017K15FKED | 20(Tp) | 20 | 20 | Tape | 0923
INDUCTOR: FERRITE BEAD SMD 0603 600Ω 1.3A 150mΩ (OEPS J30 030) [BLM18KG601SN1D] [0603] | OEPS040029 | SMD | BLM18KG601SN1D | 20 | Digikey | 490-5258-6-ND | OEPS020059 | CR0402-FX-1501GLF | 50(Tp) | 50 | 50 | Tape | 0723
INDUCTOR: FERRITE BEAD SMD 0805 1kΩ 1.5A 150mΩ [MPZ2012S102AT000] [SMD] | OEPS040034 | SMD | MPZ2012S102AT000 | 5 | Digikey | 445-MPZ2012S102AT000DKR-ND | OEPS020060 | CRCW0402270RFKEDC | 7(Tp) | 7 | 7 | Tape | 0925
INDUCTOR: FERRITE BEAD SMD 0805 220Ω 2A 45mΩ (OEPS J30 029) [BLM21PG221SN1D] [0805] | OEPS040028 | SMD | BLM21PG221SN1D | 20 | Digikey | 490-1054-6-ND | OEPS020062 | ERJ-2RKF1403X | 9(Tp) | 9 | 9 | Tape | 0326
INDUCTOR: FERRITE BEAD SMD 0805 600Ω 2A 100mΩ (OEPS J30 032) [MPZ2012S601AT000] [0805] | OEPS040027 | SMD | MPZ2012S601AT000 | 20 | Digikey | 445-MPZ2012S601AT000DKR-ND | OEPS020063 | ERJ-2RKF2701X | 207(Tp) 31(Tp) 1(Tp) | 239 | 207 | Tape | XXXX | 31 | Tape | 0224 | 1 | Tape | XXXX
INDUCTOR: FERRITE BEAD SMD 1kΩ 250mA 1.25Ω (OEPS J05 016) [BLM15HD102SN1D] [0402] | OEPS040013 | SMD | BLM15HD102SN1D | 20 | DigiKey | 490-4003-6-ND | OEPS020064 | ERJ-2RKF1202X
INDUCTOR: FERRITE BEAD SMD 220Ω 4A 30% 20mΩ [FBMH3216HM221NTV] [1206] | OEPS040002 | SMD | FBMH3216HM221NTV | 10 | DigiKey | 587-3834-6-ND | OEPS020065 | RC0201FR-071KL | 58(Tp) | 58 | 58 | Tape | 0923
INDUCTOR: FERRITE BEAD SMD 30Ω 1A 50mΩ [BLM18PG300SN1D] [0603] | OEPS040008 | SMD | BLM18PG300SN1D | 20 | DigiKey | 490-1035-6-ND | OEPS020066 | CRCW020110K0FNED | 42(Tp) | 42 | 42 | Tape | 0923
INDUCTOR: FERRITE BEAD SMD 330Ω 1.5A 70mΩ [BLM18SG331TN1D] [0603] | OEPS040004 | SMD | BLM18SG331TN1D | 20 | DigiKey | 490-3997-6-ND | OEPS020067 | RC0201FR-072KL | 51(Tp) | 51 | 51 | Tape | 0325
INDUCTOR: FERRITE BEAD SMD 40Ω 2A 50mΩ [MI0805K400R-10] [0805] | OEPS040003 | SMD | MI0805K400R-10 | 20 | DigiKey | 240-2389-6-ND | OEPS020068 | RC0201FR-0749R9L | 21(Tp) | 21 | 21 | Tape | 0923
INDUCTOR: FERRITE BEAD SMD 470Ω 1A 200mΩ (OEPS J05 017) [BLM18PG471SN1D] [0603] | OEPS040014 | SMD | BLM18PG471SN1D | 20 | DigiKey | 490-5223-6-ND | OEPS020069 | RMCF0201FT22R0CT-ND | 13(Tp) | 13 | 13 | Tape | 0923
INDUCTOR: FERRITE BEAD SMD 600Ω 1A 25% 200mΩ [MH1608-601Y] [0603] | OEPS040001 | SMD | MH1608-601Y | 20 | DigiKey | MH1608-601YDKR-ND | OEPS020070 | ERJ-1GNF1001C | 8(Tp) | 8 | 8 | Tape | 0224
INDUCTOR: FIXED INDUCTOR 0805 2.2uH 600mA 425mΩ (OEPS J30 031) [LQM21PN2R2MC0D] [0805] | OEPS040026 | SMD | LQM21PN2R2MC0D | 3 | Digikey | 490-4994-6-ND | OEPS020071 | ERJ-1GNF1002C | 8(Tp) | 8 | 8 | Tape | 0224
INDUCTOR: FIXED INDUCTOR SMD 0805 4.7uH 800mA 250mΩ [ASMPH-0805-4R7M-T] [0805] | OEPS040007 | SMD | ASMPH-0805-4R7M-T | 20 | DigiKey | 535-12274-6-ND | OEPS020072 | ERJ-1GNF1003C | 8(Tp) | 8 | 8 | Tape | 0224
INDUCTOR: FIXED INDUCTOR SMD 100uH 920mA 456mΩ [SRN6045TA-101M] [SMD] | OEPS040033 | SMD | SRN6045TA-101M | 5 | Digikey | SRN6045TA-101MDKR-ND | OEPS020073 | ERJ-1GNF1022C | 4(Tp) | 4 | 4 | Tape | 0224
INDUCTOR: FIXED INDUCTOR SMD 10uH 1.7A 70mΩ [NRS5030T100MMGJ] [-] | OEPS040024 | SMD | NRS5030T100MMGJ | 3 | Digikey | 587-3453-6-ND | OEPS020074 | ERJ-1GNF1801C | 16(Tp) | 16 | 16 | Tape | 0224
INDUCTOR: FIXED INDUCTOR SMD 10uH 300MA 600mΩ [MLZ1608N100LT000] [0603] | OEPS040021 | SMD | MLZ1608N100LT000 | 30 | DigiKey | 445-6755-6-ND | OEPS020075 | ERJ-1GNF4752C | 8(Tp) | 8 | 8 | Tape | 0224
INDUCTOR: FIXED INDUCTOR SMD 10uH 3A 105mΩ [IHLP2525CZER100M01] [-] | OEPS040005 | SMD | IHLP2525CZER100M01 | 3 | DigiKey | 541-1013-6-ND | OEPS020076 | ERJ-1GNF49R9C | 8(Tp) | 8 | 8 | Tape | 0224
INDUCTOR: FIXED INDUCTOR SMD 1210 100uH 340mA 1.82Ω (OEPS J30 034) [CBC3225T101MR] [1210] | OEPS040010 | SMD | CBC3225T101MR | 10 | DigiKey | 587-1628-6-ND | OEPS020077 | RC0402FR-07100RL | 6(Tp) | 6 | 6 | Tape | 0425
INDUCTOR: FIXED INDUCTOR SMD 15uH 1.65A 106mΩ [MSS6132-153MLC] [-] | OEPS040009 | SMD | MSS6132-153MLC | 3 | DigiKey | 4652-MSS6132-153MLC-ND | OEPS020078 | ERJ-2RKF8200X
INDUCTOR: FIXED INDUCTOR SMD 2.2uH 2.2A 50.4mΩ [NRS4018T2R2MDGJ] [-] | OEPS040025 | SMD | NRS4018T2R2MDGJ | 3 | Digikey | 587-2890-6-ND | OEPS020079 | RC0603FR-070RL | 8(Tp) 30(Tp) | 38 | 8 | Tape | 0224 | 30 | Tape | 0526
INDUCTOR: FIXED INDUCTOR SMD 3.3uH 2.1A 140mΩ [AOTA-B201610S3R3-101-T] [0806] | OEPS040036 | SMD | AOTA-B201610S3R3-101-T | 10 | Digikey | 535-AOTA-B201610S3R3-101-TDKR-ND | OEPS020080 | ERA-2AEB123X | 20(Tp) 21(Tp) 4(Tp) | 45 |  |  |  | 20 | Tape | 1023 | 21 | Tape | 0224 | 4 | Tape | 0325
INDUCTOR: FIXED INDUCTOR SMD 3.3uH 600mA 512mΩ (OEPS J05 018) [MBKK1608T3R3M] [0603] | OEPS040015 | SMD | MBKK1608T3R3M | 20 | DigiKey | 587-4151-6-ND | OEPS020081 | ERJ-2RKF9761X | 9(Tp) | 9 | 9 | Tape | 0326
INDUCTOR: FIXED INDUCTOR SMD 33uH 1.4A 188mΩ [SRN6045-330M] [-] | OEPS040031 | SMD | SRN6045-330M | 3 | DigiKey | SRN6045-330MDKR-ND | OEPS020082 | ERJ-2RKF3161X | 1(Tp) | 1 | 1 | Tape | 0224
INDUCTOR: FIXED INDUCTOR SMD 4.7uH 2A 55mΩ [NRS5024T4R7MMGJ] [-] | OEPS040023 | SMD | NRS5024T4R7MMGJ | 3 | DigiKey | 587-5937-6-ND | OEPS020083 | ERJ-2RKF3301X
INDUCTOR: FIXED INDUCTOR SMD 4.7uH 470mA 312mΩ [CBMF1608T4R7M] [0603] | OEPS040037 | SMD | CBMF1608T4R7M | 20 | Digikey | 587-1719-6-ND | OEPS020085 | ERJ-1GN0R00C | 83(R) | 83 | 83 | Reel | 0123
INDUCTOR: FIXED INDUCTOR SMD 4.7uH 700MA 338mΩ [MLP2012S4R7MT0S1] [0805] | OEPS040022 | SMD | MLP2012S4R7MT0S1 | 20 | DigiKey | 445-6366-6-ND | OEPS020086 | ERJ-3EKF1603V | 92(Tp) 208(Tp) | 300 | 92 | Tape | 0625 | 208 | Tape | XXXX
INDUCTOR: FIXED INDUCTOR SMD 4.7uH 750mA 260mΩ [CIG21L4R7MNE] [0805] | OEPS040017 | SMD | CIG21L4R7MNE | 20 | DigiKey | 1276-6204-6-ND | OEPS020087 | CR0603-FX-5102ELF | 199(Tp) 94(Tp) | 293 | 199 | Tape | 0124 | 94 | Tape | 0625
INDUCTOR: FIXED INDUCTOR SMD 4.7uH 950mA 350mΩ [1008PS-472KLB] [-] | OEPS040032 | SMD | 1008PS-472KLB | 5 | Digikey | 994-1008PS-472KLB | OEPS020088 | ERJ-3EKF2491V | 93(Tp) 4(Tp) | 97 | 93 | Tape | 0625 | 4 | Tape | XXXX
INDUCTOR: FIXED INDUCTOR SMD 47uH 500mA 900mΩ (OEPS J05 015) [ADL3225V-470MT-TL000] [1210] | OEPS040012 | SMD | ADL3225V-470MT-TL000 | 5 | DigiKey | 445-174611-6-ND | OEPS020089 | ERJ-2RKF2401X | 1719(Tp) | 1719 | 1719 | Tape | XXXX
INDUCTOR: FIXED INDUCTOR SMD 56uH 1.75A 160mΩ [SRN8040TA-560M] [-] | OEPS040011 | SMD | SRN8040TA-560M | 3 | DigiKey | SRN8040TA-560MDKR-ND | OEPS020097 | RC0603FR-073K83L | 1(Tp) 1778(R) | 1779 | 1 | Tape | 0325 | 1778 | Reel | 0425
INDUCTOR: FIXED INDUCTOR SMD 6.8uH 1.2A 276mΩ [1277AS-H-6R8M=P2] [SMD] | OEPS040035 | SMD | 1277AS-H-6R8M=P2 | 5 | Digikey | 490-10595-6-ND | OEPS020101 | RC0603FR-0760K4L | 9(Tp) | 9 | 9 | Tape | 0325
MECHA: SCREW M2x5mm pan head phillips drive [MPMS 002 0005 PH] [Mechanics] | OEPS110001 | Mechanics | MPMS 002 0005 PH | 1 | DigiKey | H738-ND | OEPS020104 | RC0603FR-071KL | 20(Tp) | 20 | 20 | Tape | 0425
MECHA: SCREW M3x16mm phillips self-tapping stainless steel [CSPCSHP-SUS-TPT3-16] [Mechanics] | OEPS110002 | Mechanics | CSPCSHP-SUS-TPT3-16 | 1 | Misumi | CSPCSHP-SUS-TPT3-16 | OEPS020120 | CRCW0201100RFKED | 61(Tp) | 61 | 61 | Tape | 0526 |  |  | 0425
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
