davidpalma666/device.rfidreader-Fork/Hardware/Eagle/harp rfid reader_BOM.xlsx

Qty | Value | Package | Parts | MPN | Type | Distributor | Distributor PN
ASSEMBLY HOUSE
2 | 47pF | C0402 | C3, C4 | 04025A470JAT2A | SMD | Digikey | 478-1078-6-ND
1 | 4.7nF | C0402 | C1 | 885012205084 | SMD | Digikey | 732-12234-6-ND
11 | 100nF 50V X7R 10% | C0402 | C2, C6, C8, C9, C10, C12, C13, C14, C15, C16, C21 | CGA2B3X7R1H104K050BB | SMD | Digikey | 445-6899-6-ND
4 | 10uF 20% 16V X5R | C0603 | C5, C7, C11, C17 | EMK107BBJ106MA-T | SMD | Digikey | 587-3238-6-ND
3 | 100uF 20% 10V | CT3216 | C18, C19, C20 | TLJA107M010R1400 | SMD | Digikey | 478-5651-6-ND
1 | 39Ω 1/5watt 1% 0402 | R0402 | R7 | RCS040239R0FKED | SMD | Digikey | 541-10407-6-ND
5 | 1k | R0402 | R2, R3, R4, R6, R8 | CRCW04021K00FKED | SMD | Digikey | 541-1.00KLDKR-ND
1 | 10k | R0402 | R5 | CRCW040210K0FKED | SMD | Digikey | 541-10.0KLDKR-ND
1 | 1M | R0402 | R1 | CRCW04021M00FKED | SMD | Digikey | 541-1.00MLDKR-ND
1 | 40ohms 100MHz 1.5A 0805 SMD | L0805 | L1 | MI0805K400R-10 | SMD | Digikey | 240-2389-6-ND
1 | TRANS NPN 45V 0.5A | SC70-3 | Q1 | BC817-40W-7 | SMD | Digikey | BC817-40WDIDKR-ND
1 | MOSFET P-CH 60V 1.7A | SOT223 | Q2 | NTF2955T1G | SMD | Digikey | NTF2955T1GOSDKR-ND
4 | RED LED | LED0603 | TAG_B, TAG_T, STATE, OUT0 | 5975004407F | SMD | Digikey | 350-2950-6-ND
1 | Buzzers Transducer 3V 100mA 4kHz 78dB @ 3V |  | SP1 | SMT-0540-S-R | SMD | Digikey | 668-1060-6-ND
1 | USB to UART USB 2.0 | 28-SSOP | IC1 | FT232RL-REEL | SMD | Digikey | 768-1007-6-ND
1 | Ultra-Low-Noise LDO 3.3V 250mA | SOT-23-5 | IC2 | LP5907MFX-3.3/NOPB | SMD | Digikey | 296-38557-6-ND
1 | ATXMEGA32A4U | 44-TQFP | IC3 | ATXMEGA32A4U-A | SMD | Digikey | ATXMEGA32A4U-AURDKR-ND
1 | IC BUFFER NON-INVERT 5.5V | TSOP-5 | IC4 | M74VHC1GT126DT1G | SMD | Digikey | M74VHC1GT126DT1GOSDKR-ND
1 | 32 MHz CMOS | 4-SMD | OSC1 | O 32,0-JT32C-A-K-3,3-LF | SMD | Digikey | 1908-1044-6-ND
1 | CONN RCPT USB2.0 MINI |  | USB | UX60-MB-5S8 | SMD | Digikey | H2960DKR-ND
1 | CONN RCPT 5POS 0.1 GOLD SMD |  | U1 5POS | NPPN051BFLD-RC‎ | SMD | Digikey | ‎S5902-05-ND‎
1 | CONN RCPT 7POS 0.1 GOLD SMD |  | U1 7POS | ‎NPPN071BFLC-RC‎ | SMD | Digikey | ‎S5901-07-ND‎
1 | CONN Terminal block 2.54MM |  | OUT | 282834-2 | TH | Digikey | A98333-ND
POST-PRODUCTION
1 | RFID Reader ID-12LA (125 kHz) |  |  | ID-12LA | TH | SparkFun | SEN-11827
NOTES
 |  |  |  | Number of unique parts | 23
 |  |  |  | Number of SMD parts | 45
 |  |  |  | Number of TH parts | 1
