davidpalma666/device.rfidreader-Fork/Hardware/Eagle/harp rfid reader_PnP.Bottom.xlsx

C11 | 25.09 | 21.83 | 0 | 10uF | C0603
C12 | 23.55 | 2.46 | 270 | 100nF | C0402
C13 | 9.65 | 14.7 | 0 | 100nF | C0402
C14 | 19.72 | 20.88 | 90 | 100nF | C0402
C15 | 27.38 | 9.9 | 180 | 100nF | C0402
C16 | 16.8 | 3.37 | 270 | 100nF | C0402
C18 | 28.19 | 19.41 | 180 | 100uF | CT3216
C19 | 34.42 | 19.42 | 180 | 100uF | CT3216
C20 | 9.91 | 23.19 | 270 | 100uF | CT3216
C5 | 25.09 | 24.12 | 0 | 10uF | C0603
IC2 | 28.9 | 22.72 | 180 | LP5907MFX-3.3 | TSOT23-5
IC3 | 18.12 | 12.3 | 180 | ATXMEGA32A4U-AU | QFP80P1200X1200X120-44N
OSC1 | 20.29 | 2.38 | 0 | CNP-MISCELLANEOUS_OSCILLATOR | CNP-MISCELLANEOUS_OSCILLATOR_3.2X2.5
OUT0 | 40.55 | 19.45 | 270 |  | CHIP-LED0603
Q2 | 28.27 | 4.56 | 0 |  | SOT223
R3 | 25.6 | 11.16 | 90 | 1k | R0402
R4 | 21.79 | 23.86 | 0 | 1k | R0402
R7 | 34.83 | 8.8 | 180 | 75 >1/4W | R0402
SP1 | 33.92 | 13.45 | 0 | BUZZER-COIL_SMT-0540-S-R | BUZZER-COIL_SMT-0540-S-R
STATE | 25.6 | 13.45 | 180 |  | CHIP-LED0603
TAG_B | 18.74 | 23.86 | 90 |  | CHIP-LED0603
