davidpalma666/device.rfidreader-Fork/Hardware/Eagle/harp rfid reader_PnP.Top.xlsx

C1 | 3.2 | 19.77 | 90 | 4.7nF | C0402
C10 | 28.51 | 19.42 | 0 | 100nF | C0402
C17 | 24.83 | 15.92 | 270 | 10uF | C0603
C2 | 6.32 | 19.39 | 180 | 100nF | C0402
C21 | 40.55 | 9.99 | 0 | 100nF | C0402
C3 | 11.12 | 12.06 | 270 | 47pF | C0402
C4 | 11.05 | 15.18 | 90 | 47pF | C0402
C6 | 11.53 | 20.55 | 270 | 100nF | C0402
C7 | 9.14 | 22.35 | 270 | 10uF | C0603
C8 | 11.13 | 8.8 | 90 | 100nF | C0402
C9 | 23.26 | 16.13 | 270 | 100nF | C0402
IC1 | 17.07 | 13.45 | 0 | FT232RL | SSOP28
IC4 | 40.55 | 7.25 | 270 |  | SOT23-5
L1 | 6.89 | 22.38 | 270 | ??? | R0805
Q1 | 33.22 | 9.13 | 270 | BC817-40W | SOT323-BEC
R1 | 1.68 | 19.75 | 90 | 1M | R0402
R2 | 34.65 | 13.45 | 90 | 1k | R0402
R5 | 32.33 | 12.31 | 270 | 10k | R0402
R6 | 36.27 | 9.89 | 90 | 1k | R0402
R8 | 40.55 | 17.86 | 180 | 1k | R0402
TAG_T | 36.16 | 13.45 | 0 |  | CHIP-LED0603
USB | 8.78 | 13.45 | 270 |  | 240-0002-1
U1 5POS | 17.92 | 5.95 | 90
U1 7POS | 19.92 | 20.95 | 90
