davidpalma666/device.rfidreader-Fork/Hardware/PCB/harp rfid reader.kicad_pcb

## KiCad design Hardware/PCB/harp rfid reader.kicad_pcb (2026-10-29)

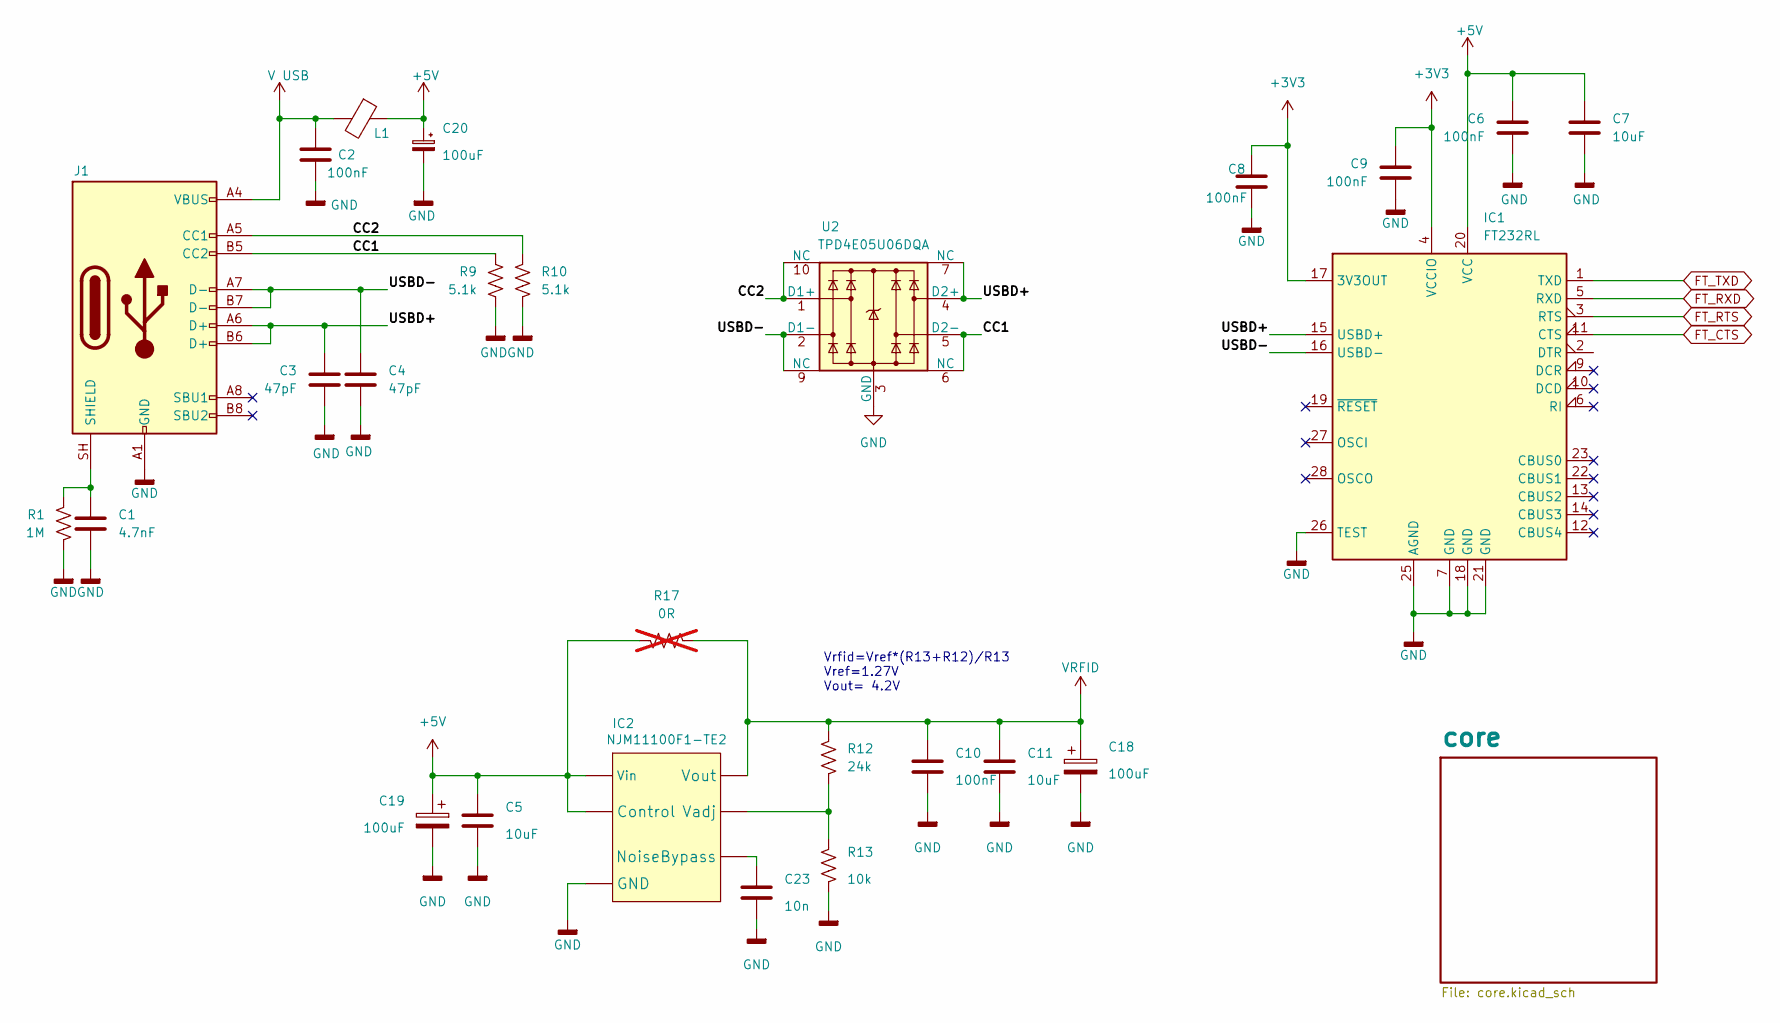
[picture p3: schematic harp rfid reader.kicad_sch]

Parts:
C1: 4.7nF; C_0402_1005Metric; Voltage 100V; Tolerance ±10%; MPN 885012205084
C2, C6, C8, C9, C10: 100nF; C_0402_1005Metric; Tolerance ±10%; Voltage 50V; MPN CGA2B3X7R1H104K050BB
C3, C4: 47pF; C_0402_1005Metric; Voltage 50V; Tolerance ±5%; MPN 04025A470JAT2A
C5, C7, C11: 10uF; C_0603_1608Metric; Voltage 16V; Tolerance ±20%; MPN EMK107BBJ106MA-T
C18, C19, C20: 100uF; C_1206_3216Metric; Tolerance ±20%; Voltage 10V; MPN TLJA107M010R1400
C23: 10n; C_0402_1005Metric; Tolerance ±10%; Voltage 25V; MPN GRM155R71E103KA01D
IC1: FT232RL; SSOP-28_5.3x10.2mm_P0.65mm; MPN FT232RL-REEL
IC2: NJM11100F1-TE2; SOT-23-6; MPN NJM11100F1-TE2
J1: USB4105-GF-A; USB_C_Receptacle_GCT_USB4105-xx-A_16P_TopMnt_Horizontal; MPN USB4105-GF-A
L1: MI0805K400R-10; R_0805_2012Metric; MPN MI0805K400R-10
R1: 1M; R_0402_1005Metric; Tolerance ±1%; MPN CRCW04021M00FKED
R9, R10: 5.1k; R_0402_1005Metric; Tolerance ±1%; MPN ERJ-2RKF5101X
R12: 24k; R_0402_1005Metric; Tolerance ±1%; MPN ERJ-2RKF2402X
R13: 10k; R_0402_1005Metric; Tolerance ±1%; MPN CRCW040210K0FKED
R17: 0R; R_0402_1005Metric; MPN DNP; not fitted
U2: TPD4E05U06DQA; USON-10_2.5x1.0mm_P0.5mm; MPN TPD4E05U06DQAR

Connections:
+3V3: C8.1, C9.1, IC1.4 (VCCIO), IC1.17 (3V3OUT); also elsewhere on the board
+5V: C5.1, C6.1, C7.1, C19.1, C20.1, IC1.20 (VCC), IC2.1 (Control), IC2.6 (Vin), L1.1, R17.1; also elsewhere on the board
/CC1: J1.B5 (CC2), R9.1, U2.5 (D2-), U2.6 (NC)
/CC2: J1.A5 (CC1), R10.1, U2.1 (D1+), U2.10 (NC)
/USBD+: C3.1, IC1.15 (USBD+), J1.A6 (D+), J1.B6 (D+), U2.4 (D2+), U2.7 (NC)
/USBD-: C4.1, IC1.16 (USBD-), J1.A7 (D-), J1.B7 (D-), U2.2 (D1-), U2.9 (NC)
FT_CTS: IC1.11 (CTS); also elsewhere on the board
FT_RTS: IC1.3 (RTS); also elsewhere on the board
FT_RXD: IC1.5 (RXD); also elsewhere on the board
FT_TXD: IC1.1 (TXD); also elsewhere on the board
GND: C1.2, C2.2, C3.2, C4.2, C5.2, C6.2, C7.2, C8.2, C9.2, C10.2, C11.2, C18.2, C19.2, C20.2, C23.2, IC1.7 (GND), IC1.18 (GND), IC1.21 (GND), IC1.25 (AGND), IC1.26 (TEST), IC2.2 (GND), J1.A1 (GND), J1.A12 (GND), J1.B1 (GND), J1.B12 (GND), R1.2, R9.2, R10.2, R13.2, U2.3 (GND), U2.8 (GND); also elsewhere on the board
unnamed: C23.1, IC2.3 (NoiseBypass)
unnamed: IC2.5 (Vadj), R12.2, R13.1
unnamed: C1.1, J1.SH (SHIELD), R1.1
V USB: C2.1, J1.A4 (VBUS), J1.A9 (VBUS), J1.B4 (VBUS), J1.B9 (VBUS), L1.2
VRFID: C10.1, C11.1, C18.1, IC2.4 (Vout), R12.1, R17.2; also elsewhere on the board

Notes on the sheet:
Vrfid=Vref*(R13+R12)/R13 Vref=1.27V Vout= 4.2V

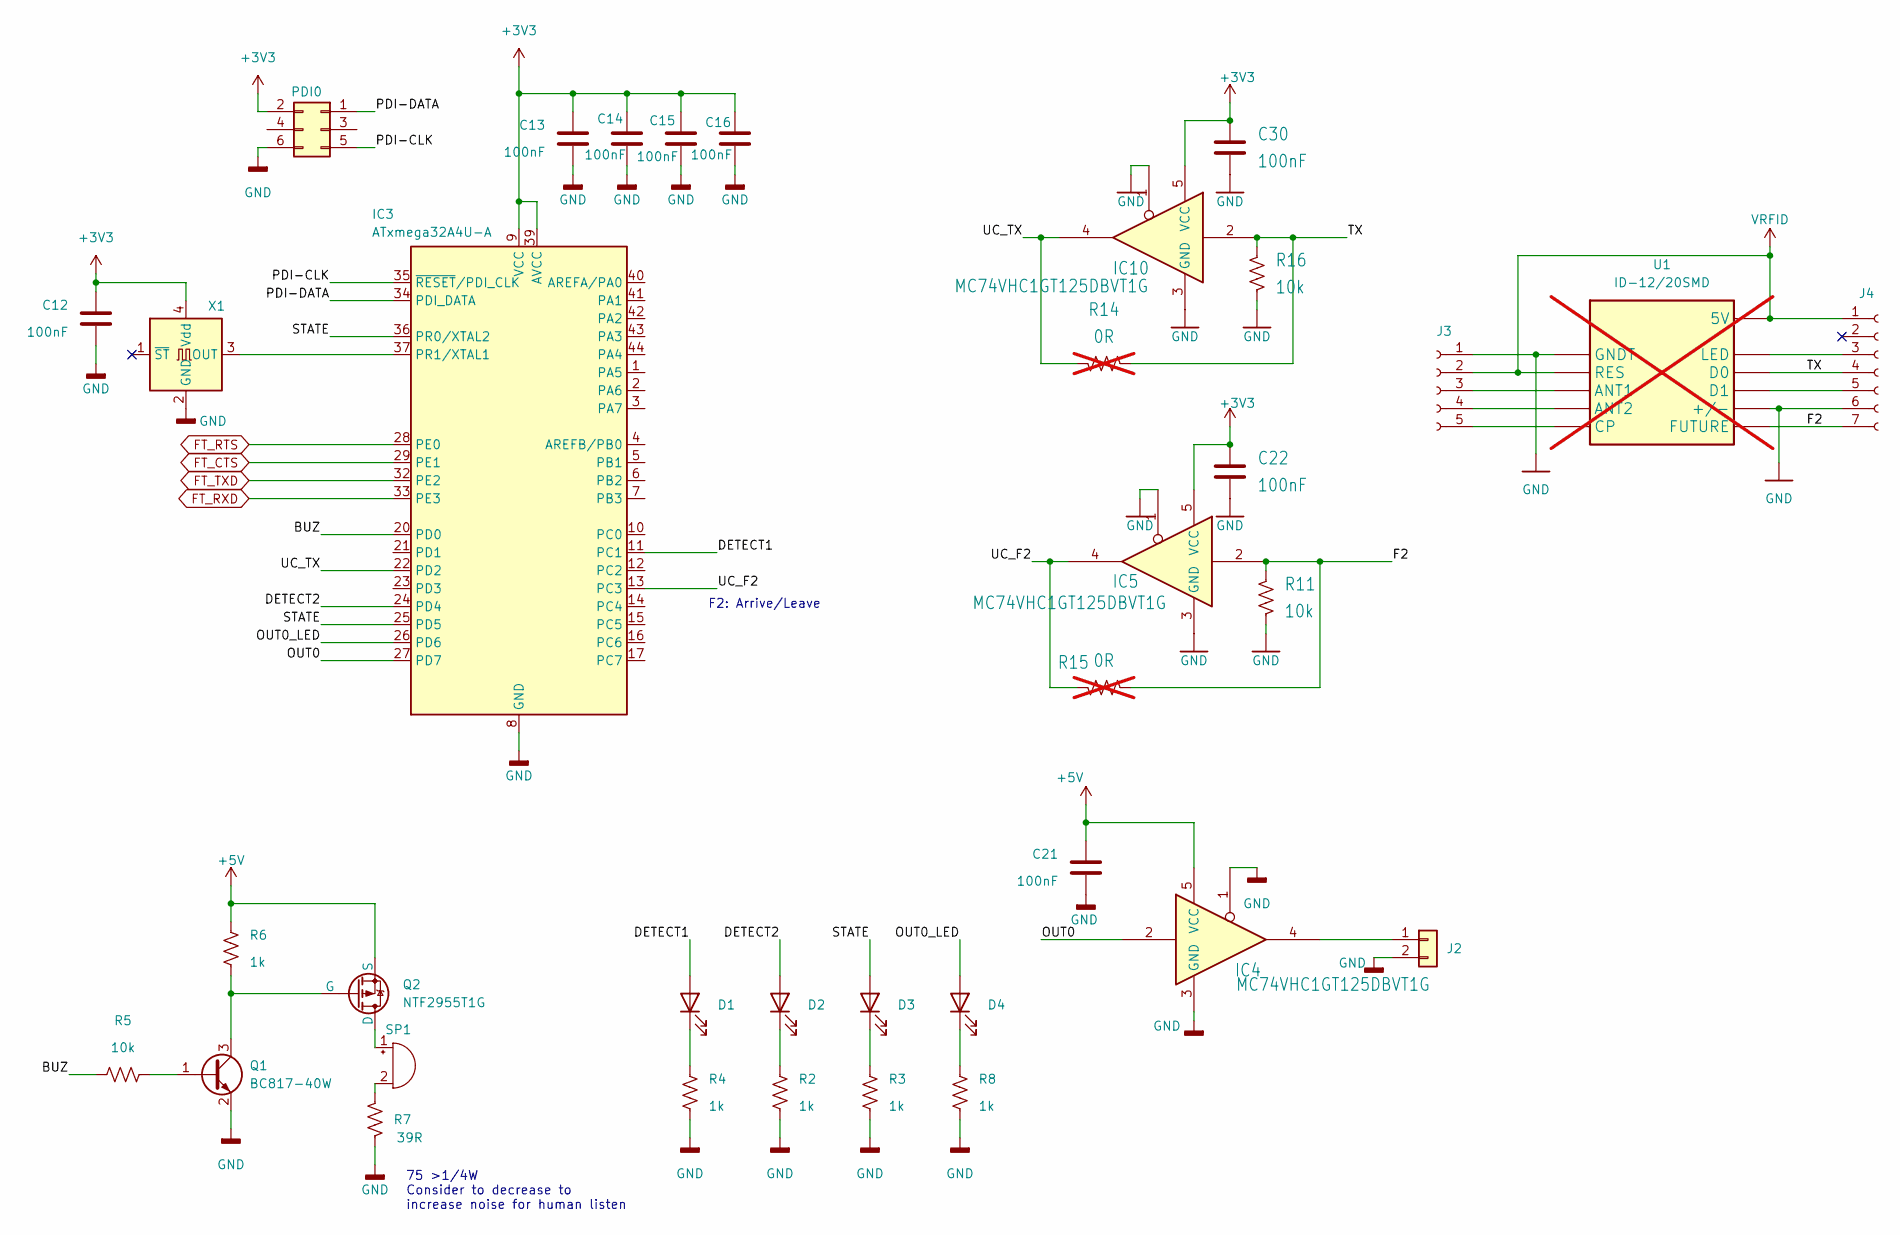
[picture p4: schematic core.kicad_sch, harp RFID reader]

Parts:
C12, C13, C14, C15, C16, C21, C22, C30: 100nF; C_0402_1005Metric; Tolerance ±10%; Voltage 50V; MPN CGA2B3X7R1H104K050BB
D1, D2, D3, D4: 5975004407F; LED_0603_1608Metric; MPN 5975004407F
IC3: ATxmega32A4U-A; TQFP-44_10x10mm_P0.8mm; MPN ATXMEGA32A4U-A
IC4, IC5, IC10: MC74VHC1GT125DBVT1G; SOT-353_SC-70-5; MPN MC74VHC1GT125DBVT1G
J2: 282834-2; 22-23-2021; MPN 282834-2
J3: NPPN051BFLD-RC; PinSocket_1x05_P2.00mm_Vertical_SMD_Pin1Right; MPN NPPN051BFLD-RC
J4: NPPN071BFLC-RC; PinSocket_1x07_P2.00mm_Vertical_SMD_Pin1Right; MPN NPPN071BFLC-RC
PDI0: 67996-206HLF; PinHeader_2x03_P2.54mm_Vertical; MPN 67996-206HLF
Q1: BC817-40W; SOT-323_SC-70; Voltage 45V; MPN BC817-40W-7
Q2: NTF2955T1G; SOT-223; Voltage 60V; MPN NTF2955T1G
R2, R3, R4, R6, R8: 1k; R_0402_1005Metric; Tolerance ±1%; MPN CRCW04021K00FKED
R5, R11, R16: 10k; R_0402_1005Metric; Tolerance ±1%; MPN CRCW040210K0FKED
R7: 39R; R_0402_1005Metric; Tolerance ±1%; MPN RCS040239R0FKED
R14, R15: 0R; R_0402_1005Metric; MPN DNP; not fitted
SP1: SMT-0540-S-R; BUZZER-COIL_SMT-0540-S-R; MPN SMT-0540-S-R
U1: ID-12/20SMD; ID-12_SMD body; MPN ID-12LA; not fitted
X1: O 32,0-JT32C-A-K-3,3-LF; CNP-MISCELLANEOUS_OSCILLATOR_3.2X2.5; MPN O 32,0-JT32C-A-K-3,3-LF

Connections:
+3V3: C12.1, C13.1, C14.1, C15.1, C16.1, C22.1, C30.1, IC3.9 (VCC), IC3.19 (VCC), IC3.31 (VCC), IC3.39 (AVCC), IC5.5 (VCC), IC10.5 (VCC), PDI0.2, X1.4 (Vdd); also elsewhere on the board
+5V: C21.1, IC4.5 (VCC), Q2.3 (S), R6.1; also elsewhere on the board
/core/BUZ: IC3.20 (PD0), R5.1
/core/DETECT1: D1.2 (A), IC3.11 (PC1)
/core/DETECT2: D2.2 (A), IC3.24 (PD4)
/core/F2: IC5.2, J4.7, R11.1, R15.2, U1.6 (FUTURE)
/core/OUT0: IC3.27 (PD7), IC4.2
/core/OUT0_LED: D4.2 (A), IC3.26 (PD6)
/core/PDI-CLK: IC3.35 (~RESET/PDI_CLK), PDI0.5
/core/PDI-DATA: IC3.34 (PDI_DATA), PDI0.1
/core/STATE: D3.2 (A), IC3.25 (PD5), IC3.36 (PR0/XTAL2)
/core/TX: IC10.2, J4.4, R14.2, R16.1, U1.9 (D0)
/core/UC_F2: IC3.13 (PC3), IC5.4, R15.1
/core/UC_TX: IC3.22 (PD2), IC10.4, R14.1
FT_CTS: IC3.29 (PE1); also elsewhere on the board
FT_RTS: IC3.28 (PE0); also elsewhere on the board
FT_RXD: IC3.33 (PE3); also elsewhere on the board
FT_TXD: IC3.32 (PE2); also elsewhere on the board
GND: C12.2, C13.2, C14.2, C15.2, C16.2, C21.2, C22.2, C30.2, IC3.8 (GND), IC3.18 (GND), IC3.30 (GND), IC3.38 (GND), IC4.1, IC4.3 (GND), IC5.1, IC5.3 (GND), IC10.1, IC10.3 (GND), J2.2, J3.1, J4.6, PDI0.6, Q1.2 (E), R2.1, R3.1, R4.1, R7.2, R8.1, R11.2, R16.2, U1.1 (GNDT), U1.7 (+/-), X1.2 (GND); also elsewhere on the board
unnamed: D1.1 (K), R4.2
unnamed: D2.1 (K), R2.2
unnamed: D3.1 (K), R3.2
unnamed: D4.1 (K), R8.2
unnamed: IC3.37 (PR1/XTAL1), X1.3 (OUT)
unnamed: IC4.4, J2.1
unnamed: J3.3, U1.3 (ANT1)
unnamed: J3.4, U1.4 (ANT2)
unnamed: J3.5, U1.5 (CP)
unnamed: J4.3, U1.10 (LED)
unnamed: J4.5, U1.8 (D1)
unnamed: Q1.1 (B), R5.2
unnamed: Q1.3 (C), Q2.1 (G), R6.2
unnamed: Q2.2 (D), Q2.4 (D), SP1.1 (+)
unnamed: R7.1, SP1.2 (-)
VRFID: J3.2, J4.1, U1.2 (RES), U1.11 (5V); also elsewhere on the board

Notes on the sheet:
F2: Arrive/Leave
75 >1/4W Consider to decrease to increase noise for human listen

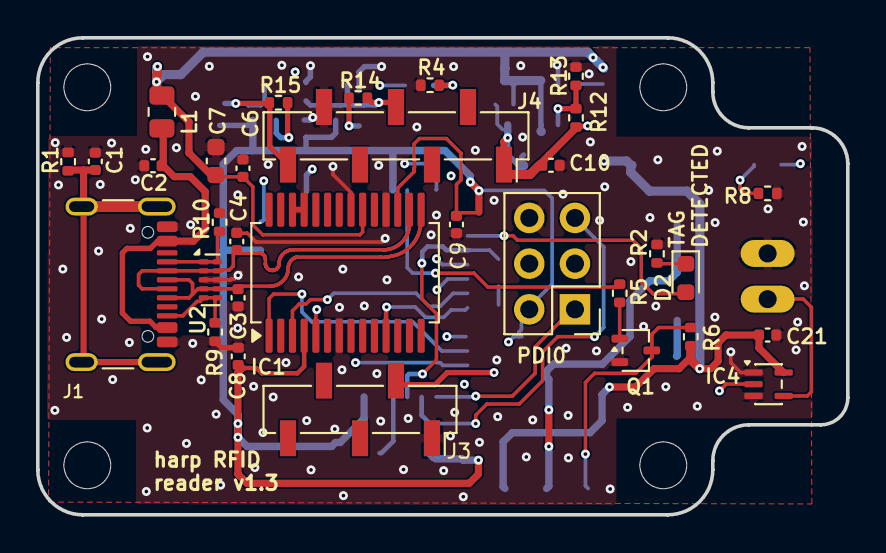
[picture p5: board harp rfid reader.kicad_pcb from above]

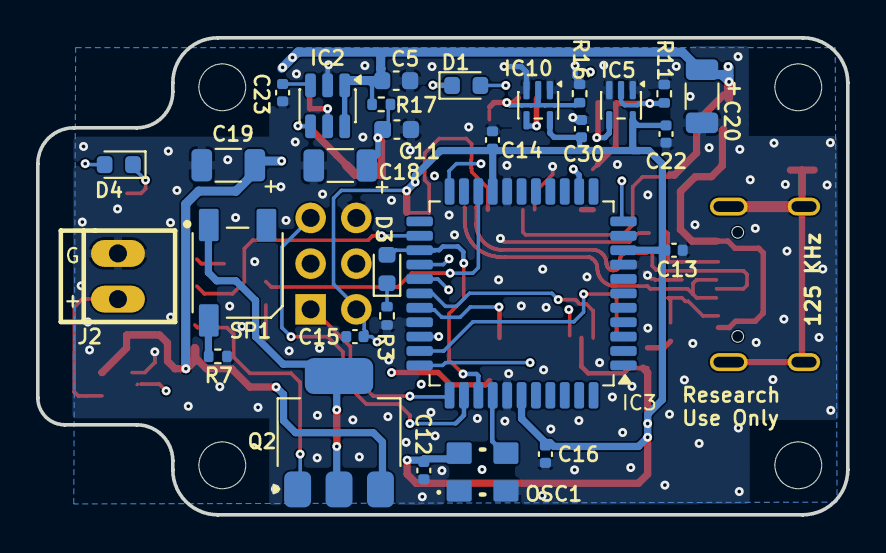
[picture p6: board harp rfid reader.kicad_pcb from below]

Board: 4 copper layers, 45.0 x 26.5 mm, 65 parts (29 on the bottom side), 38 nets.

Other parts of the board:
UNK_HOLE_1: dummyfp1
UNK_HOLE_2, UNK_HOLE_2#2: dummyfp2
UNK_HOLE_3: dummyfp3
