davidpalma666/device.rfidreader-Fork/Hardware/Eagle/harp rfid reader.brd

## EAGLE design Hardware/Eagle/harp rfid reader.brd (2026-10-20)

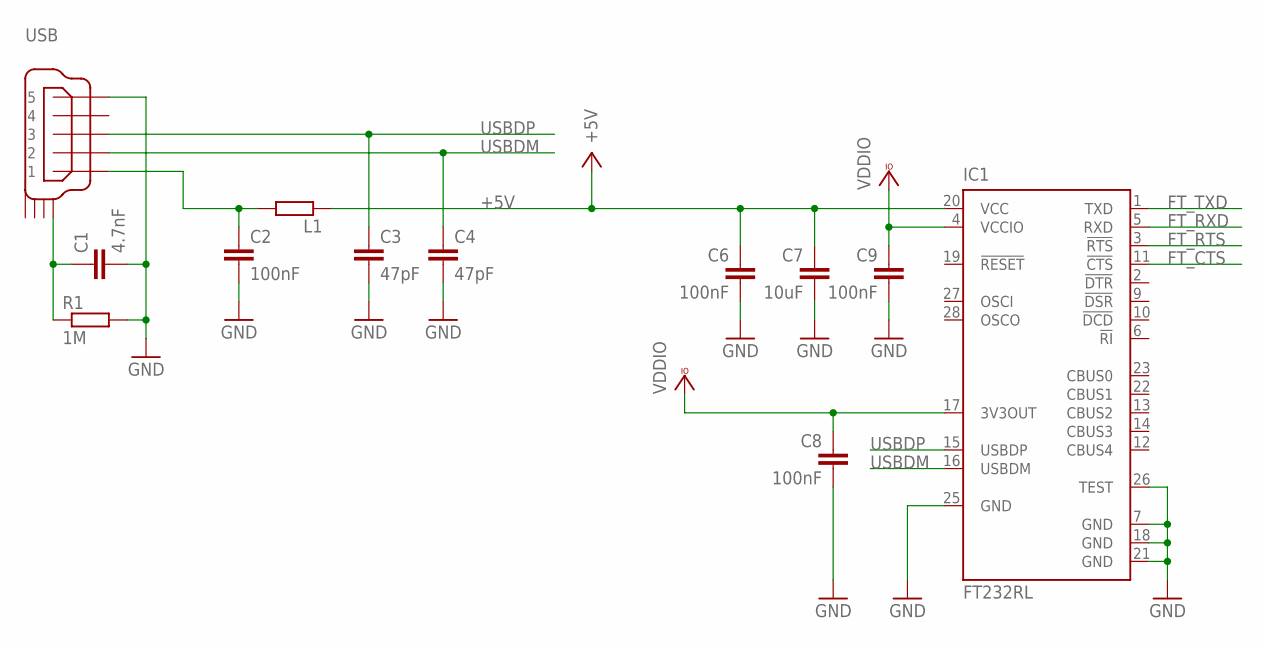
[picture p7: schematic harp rfid reader.sch, sheet 1]

Parts:
C1: 4.7nF; C0402
C2, C6, C8, C9: 100nF; C0402
C3, C4: 47pF; C0402
C7: 10uF; C0603
IC1: FT232RL; SSOP28
L1: ???; R0805
R1: 1M; R0402
USB: USB_MINI_B; 240-0002-1

Connections:
+5V: C6.1, C7.1, IC1.20 (VCC), L1.1; also elsewhere on the board
FT_CTS: IC1.11 (!CTS); also elsewhere on the board
FT_RTS: IC1.3 (!RTS); also elsewhere on the board
FT_RXD: IC1.5 (RXD); also elsewhere on the board
FT_TXD: IC1.1 (TXD); also elsewhere on the board
GND: C1.2, C2.2, C3.2, C4.2, C6.2, C7.2, C8.2, C9.2, IC1.7 (GND), IC1.18 (GND), IC1.21 (GND), IC1.25 (GND), IC1.26 (TEST), R1.2, USB.P$5 (5); also elsewhere on the board
unnamed: C1.1, R1.1, USB.SHIELD_1
unnamed: C2.1, L1.2, USB.P$1 (1)
USBDM: C4.1, IC1.16 (USBDM), USB.P$2 (2)
USBDP: C3.1, IC1.15 (USBDP), USB.P$3 (3)
VCCIO: C8.1, C9.1, IC1.4 (VCCIO), IC1.17 (3V3OUT); also elsewhere on the board

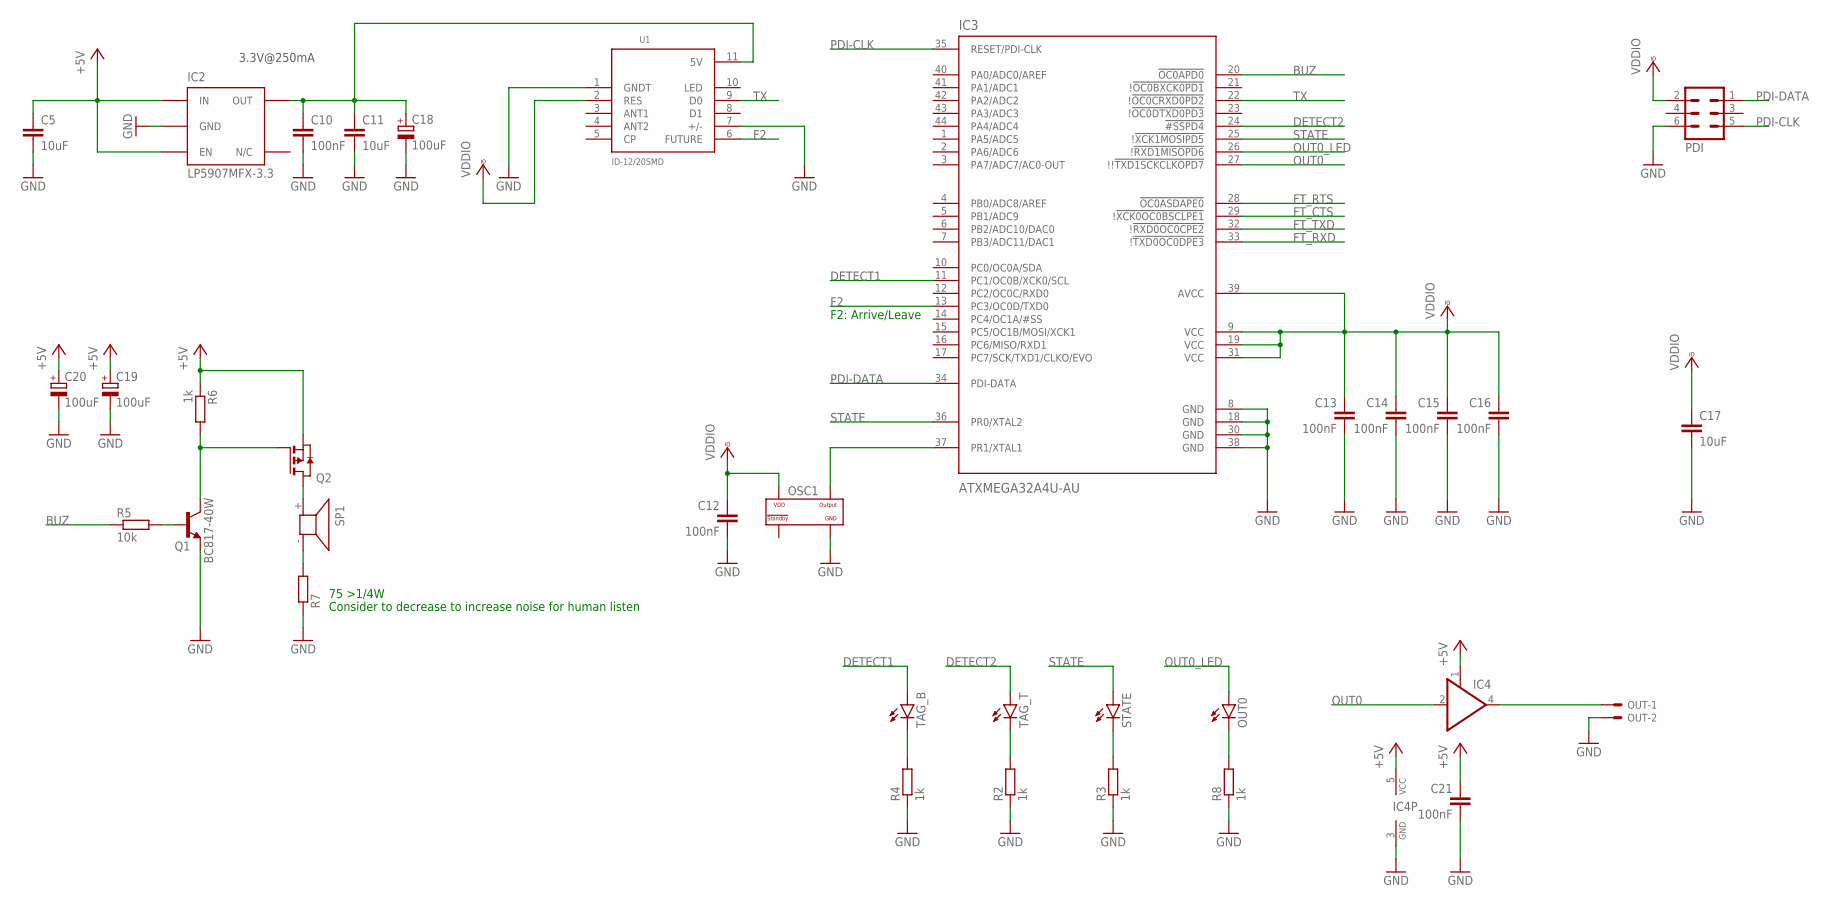
[picture p8: schematic harp rfid reader.sch, sheet 2]

Parts:
C5, C11, C17: 10uF; C0603
C10, C12, C13, C14, C15, C16, C21: 100nF; C0402
C18, C19, C20: 100uF; CT3216
IC2: LP5907MFX-3.3; TSOT23-5
IC3: ATXMEGA32A4U-AU; QFP80P1200X1200X120-44N
IC4: 74AHC1G126DBV; SOT23-5
OSC1: CNP-MISCELLANEOUS_OSCILLATOR; CNP-MISCELLANEOUS_OSCILLATOR_3.2X2.5
OUT: 22-23-2021
OUT0: LEDCHIP-LED0603; CHIP-LED0603
PDI: MA03-2
Q1: BC817-40W; SOT323-BEC
Q2: PMOSSOT223; SOT223
R2, R3, R4, R6, R8: 1k; R0402
R5: 10k; R0402
R7: 75 >1/4W; R0402
SP1: BUZZER-COIL_SMT-0540-S-R
STATE: LEDCHIP-LED0603; CHIP-LED0603
TAG_B: LEDCHIP-LED0603; CHIP-LED0603
TAG_T: LEDCHIP-LED0603; CHIP-LED0603
U1: ID-12/20SMD; ID-12_SMD

Connections:
+5V: C5.1, C19.+, C20.+, C21.1, IC2.1 (IN), IC2.3 (EN), IC4.1 (OE), IC4.5 (VCC), Q2.3 (S), R6.1; also elsewhere on the board
BUZ: IC3.20 (!OC0APD0), R5.1
BUZ_T: Q2.2 (D), Q2.4 (D), SP1.+
DETECT1: IC3.11 (PC1/OC0B/XCK0/SCL), TAG_B.A
DETECT2: IC3.24 (!#SSPD4), TAG_T.A
F2: IC3.13 (PC3/OC0D/TXD0), U1.6 (FUTURE)
FT_CTS: IC3.29 (!!XCK0OC0BSCLPE1); also elsewhere on the board
FT_RTS: IC3.28 (!OC0ASDAPE0); also elsewhere on the board
FT_RXD: IC3.33 (!!TXD0OC0DPE3); also elsewhere on the board
FT_TXD: IC3.32 (!!RXD0OC0CPE2); also elsewhere on the board
GND: C5.2, C10.2, C11.2, C12.2, C13.2, C14.2, C15.2, C16.2, C17.2, C18.-, C19.-, C20.-, C21.2, IC2.2 (GND), IC3.8 (GND), IC3.18 (GND), IC3.30 (GND), IC3.38 (GND), IC4.3 (GND), OSC1.P$2 (GND), OUT.2, PDI.6, Q1.E, R2.1, R3.1, R4.1, R7.1, R8.1, U1.1 (GNDT), U1.7 (+/-); also elsewhere on the board
unnamed: C10.1, C11.1, C18.+, IC2.5 (OUT), U1.11 (5V)
unnamed: R3.2, STATE.C
unnamed: R4.2, TAG_B.C
unnamed: R2.2, TAG_T.C
unnamed: OUT0.C, R8.2
unnamed: IC4.4 (O), OUT.1
unnamed: R7.2, SP1.-
unnamed: Q1.C, Q2.1 (G), R6.2
unnamed: Q1.B, R5.2
OSC1: IC3.37 (PR1/XTAL1), OSC1.P$3 (OUTPUT)
OUT0: IC3.27 (!!!TXD1SCKCLKOPD7), IC4.2 (I)
OUT0_LED: IC3.26 (!!RXD1MISOPD6), OUT0.A
PDI-CLK: IC3.35 (RESET/PDI-CLK), PDI.5
PDI-DATA: IC3.34 (PDI-DATA), PDI.1
STATE: IC3.25 (!!XCK1MOSIPD5), IC3.36 (PR0/XTAL2), STATE.A
TX: IC3.22 (!!OC0CRXD0PD2), U1.9 (D0)
VCCIO: C12.1, C13.1, C14.1, C15.1, C16.1, C17.1, IC3.9 (VCC), IC3.19 (VCC), IC3.31 (VCC), IC3.39 (AVCC), OSC1.P$4 (VDD), PDI.2, U1.2 (RES); also elsewhere on the board

Notes on the sheet:
3.3V@250mA
75 >1/4W
Consider to decrease to increase noise for human listen
F2: Arrive/Leave

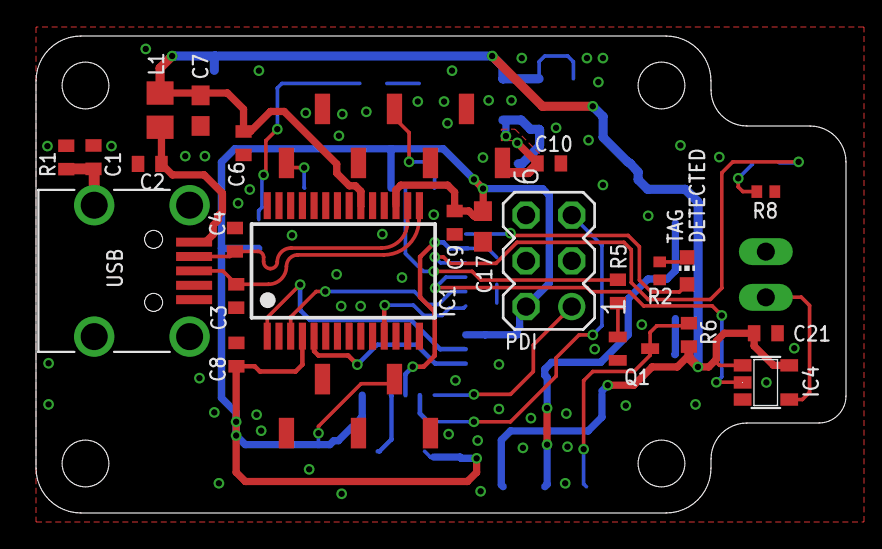
[picture p9: board harp rfid reader.brd from above]

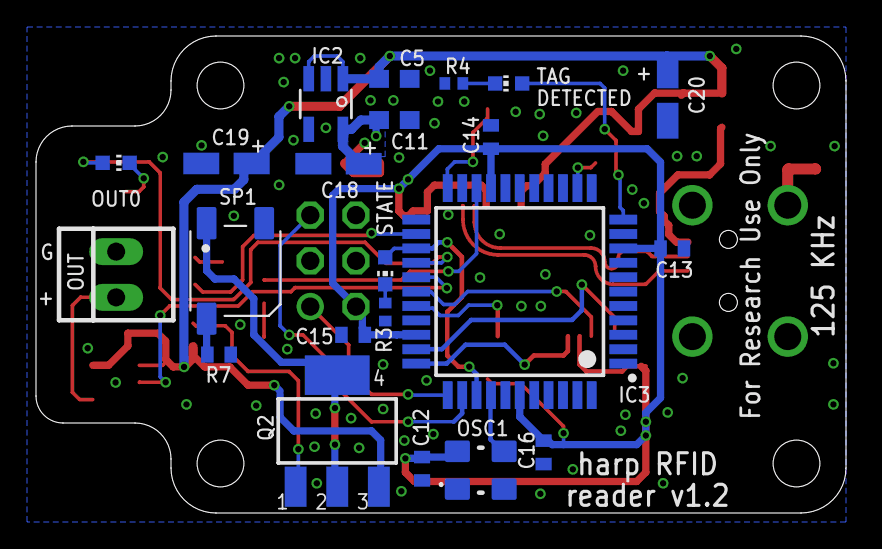
[picture p10: board harp rfid reader.brd from below]

Board: 2 copper layers, 45.0 x 26.5 mm, 46 parts (22 on the bottom side), 32 nets.
