davidpalma666/device.rfidreader-Fork/(commit log)

2026-07-24 1ª versão quase limpa da imigração do Eagle
    [OEPS_BOM_harp_RFID_reader_v1.2.xlsx, OEPS_BOM_harp_RFID_reader_v1.2_simplified.xlsx, core.kicad_sch, harp rfid reader.brd, harp rfid reader.kicad_pcb, harp rfid reader.kicad_sch, harp rfid reader.sch, harp rfid reader_BOM.xlsx]
2026-08-04 versão 1.3 final & ficheiros de manufacturing
    - ainda sem revisão do Filipe
    [BOM harp rfid reader.csv, core.kicad_sch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]
2026-10-20 para revisão Filipe
    ficheiros de manufacturing criados
    [BOM harp rfid reader.csv, core.kicad_sch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]
2026-10-29 corrigidas observações do Filipe
    . versão corrigida para v.1.3
    . corrigida nas páginas do projecto tb
    . retirado string de v.x.y do nome dos ficheiros
    . exposta fórmula de cálculo de tenão do LDO ajustável
    [core.kicad_sch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]
2026-10-29 MPN de IC4 IC5 IC10 não estavam correctos
    . corrigidos MPN & footprints
    . rerouting feito: DRC=0
    . gerados ficheiros produção
    [core.kicad_sch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]
2026-10-29 dorrecção em ligação módulo RFID
    [core.kicad_sch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]
2026-10-29 corrigidos erros em descrição de componentes
    [core.kicad_sch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]
